mosschief/super_duck/cad/README.md

# CAD Spec

The MuJoCo model is the source of truth for the leg joints (positions, axes, ranges) and the actuators: this folder
holds what the CAD is built from, generated from it, and the real dimensions of every purchased part. The shapes,
masses, neck, cameras and IMU go the other way: `freecad/export_sim.py` exports the FreeCAD assembly into the sim
(`freecad/README.md`). Regenerate after any model change:

```bash
python3 tools/export_cad_spec.py        # hardpoints.json / hardpoints.md / purchased_parts.md
python3 tools/check_cad_clearances.py   # clearance_report.md (exit 1 on a self-contact in a leg pose)
python3 tools/export_design_loads.py    # design_loads.json / design_loads.md (~30 s)
tools/fetch_vendor_cad.sh               # vendor drawings + STEP into cad/vendor/ (git-ignored)
```

| File | What it is |
| :--- | :--- |
| [`hardpoints.md`](hardpoints.md) / `.json` | Every joint anchor, axis and range, body frame, part placement, camera, site and light, in mm at the `home_balanced` pose, plus key dimensions and the leg poses the structure must clear. Build the CAD skeleton from this. |
| [`purchased_parts.json`](purchased_parts.json) → [`.md`](purchased_parts.md) | Real envelopes, hole patterns, masses and load limits of purchased parts, each with its source and a confidence level. Edit the JSON. |
| [`clearance_report.md`](clearance_report.md) | Self-contact of the sim's collision hulls (the CAD parts) over all operating poses and full joint ranges, ground clearance, scrub torque. Exact packing and interference: [`freecad/fit_report.md`](freecad/fit_report.md). |
| [`tires.md`](tires.md) | Cast urethane tires: tread and hub spec, mold, casting steps, grip test and how to put the result into the sim. |
| [`design_loads.md`](design_loads.md) / `.json` | Force and moment through every joint (axial, radial, about and across the axis) for standing, driving, crouching, jumps, ±40 N pushes and a fall. Size brackets and bolts from these. |

Frame everywhere: floor at z = 0, x forward, y left, z up, millimetres.

## Key numbers (gim6010 build, 6.88 kg)

| | |
| :--- | :--- |
| Wheel Ø / tire width / track | 150 / 32 / 224 mm |
| Thigh / shin (axis to axis, in the leg plane) | 118 / 118 mm |
| Hip mount spacing (fixed, no hip yaw) | 168 mm |
| Wheel offset inboard of the knee (wheel under hip roll) | 48 mm; scrub offset 4 mm → 0.11 N·m standing roll torque |
| Height at home pose | 650 mm incl. antennas |
| Hip-pitch axis above the wheel axle | 236 (jump take-off) / 207 (home) / 174 mm (deepest crouch), wheel always directly below |
| Eye camera baseline | 70 mm |
| Ground clearance (lowest non-wheel part, any operating pose) | 28.7 mm (wheel motor housing, deep crouch + hip roll) |

## What the lock-down found and changed

- **GIM4305-10 is 33 mm long, not 26.** Listings quote the housing only. The SteadyWin drawing and STEP add a 6 mm
  driver boss and a 1 mm output step. The model's motor envelopes are now Ø53 × 33.
- **The 6S2P pack is 73 × 89 × 68 mm, not 70 × 84 × 63.** 12 Molicel P45B cells (Ø21.55 × 70.15 max) lying 4 × 3,
  plus strip and wrap. It now sits 2 mm below the trunk shell stand-in and 2 mm under the Pi: the trunk needs about
  5 mm more interior height, or the Pi has to move up.
- **The Teensy carrier and IMU were outside the trunk** (x = -95 / -108 mm, the scaled Open Duck Mini IMU spot). Both
  moved inside, onto the upper rear wall. The IMU orientation and gyro don't depend on where the IMU sits on the
  trunk; its acceleration magnitude (free-fall and bump detection) does a little, and those thresholds were set
  with the IMU at this spot.
- **The anti-spark switch overlapped the full-size battery** by 0.5 mm; moved 3 mm forward.
- **The eye cameras' field of view was the wide lens's** (67° vertical). The standard Camera Module 3 is 41°.

## Open issues for CAD (details in the reports)

1. **Closed (2026-10-16): hip yaw removed.** The hip-yaw GIM4305s were held at 0 by the controller (steering is by
   wheel torque), and their output bearing saw 117 N axial on landings (93% of its limit). The hips are now fixed
   mounts (~60 g each, net -240 g). **Design the mount bracket** (trunk floor to hip-roll motor) for 49 N axial /
   12 N radial / 5.8 N·m bending / 1.0 N·m twist at p99.5, peaks 120 N / 22 N / 5.9 N·m / 2.5 N·m
   (`design_loads.md`, `fixed: hip_roll_assembly`).
2. **Bending moments are large for these bearings**: ~6 N·m across the hip roll (GIM4305), ~9 N·m across the hip
   pitch and knee (GIM6010). Neither limit is published: ask SteadyWin, and support the far side of each joint (a
   bearing on the bracket opposite the motor) where you can. With the hip mount fixed, the hip-roll motor's far side
   can be carried by the mount.
3. **Wheel landing: 260 N contact, 245 N radial through the wheel motor (49% of 500 N)**, plus a torque spike from
   the spinning rotor being stopped at touchdown. The wheel hub and tire need to take it.
4. **Neck pitch reaches 5.4 N·m on landings**, above what the STS3215 can hold, so the neck hits its joint limit.
   Give it a real hard stop that isn't the servo.
5. **Printed parts must clear the head and neck motion**: head roll ±26°, neck pitch −17°…+52°, head pitch and yaw
   at their controller clips. The head hits the trunk outside the neck envelope (`freecad/neck_envelope.md`; the sim sees the same contacts, `clearance_report.md`); the controller now clips head commands to it (`test_robustness.py -k head`: no contacts).
6. **Closed (2026-10-16)**: the hip-yaw bracket no longer turns, so it needs no swept clearance under the trunk.
7. **Space still to reserve**: the e-stop needs ~45 mm behind the rear panel; the speaker depth depends on the part
   (the model assumes 6 mm, with 0.5 mm to the battery). The bucks and the bus servo adapter are now placed in the
   FreeCAD model (`freecad/README.md`).
8. **Measure on arrival**: GIM6010-8 radial protrusion (its STEP is Ø86.6 across, likely the connector), micro servo
   tab holes, the speaker, BMS, anti-spark switch and e-stop.
