mosschief/super_duck/requirements-fea.txt

# tools/fea_printed_parts.py (also needs cad/freecad/printed/ from a FreeCAD build)
-r requirements.txt
gmsh==4.15.2
scikit-fem==12.0.2
pyamg==5.4.1
