mosschief/super_duck/cad/design_loads.md

# Design Loads: `open_duck_wheeled_v2_gim6010.xml`

Generated by `tools/export_design_loads.py` (ideal sensors). Loads each joint transmits from parent to child at its anchor: through the motor's output bearing and into the brackets either side. **F_axial / F_radial**: force along / across the joint axis. **M_axis**: moment about the axis (motor torque). **M_bend**: moment across the axis (tilts the bearing; what the bracket and the motor flange bolts carry).

Robot weight 69.0 N. Values are the **99.5th percentile** over the scenario (peak in brackets). For printed parts apply a safety factor of at least 2 on p99.5 (impacts, fatigue, layer adhesion), and check the peak too. Where the M_axis peak exceeds the actuator's own limit, the extra comes from the joint hitting its limit (the hard stop carries it) or from the motor's reflected rotor inertia being stopped suddenly (a shock load through the gearbox, e.g. a spinning wheel touching down).

## Design envelope (all scenarios except the fall)

| Joint | F_axial (N) | F_radial (N) | M_axis (N·m) | M_bend (N·m) | Output bearing (peak / limit) |
| :--- | ---: | ---: | ---: | ---: | :--- |
| `neck_pitch` | 2.1 (25.1) | 29.0 (40.3) | 2.98 (3.65) | 0.38 (3.02) | STS3215 servo; **M_axis peak > actuator limit**: hard stop or rotor-inertia shock |
| `head_pitch` | 1.9 (23.2) | 26.4 (36.0) | 1.45 (1.86) | 0.29 (1.39) | STS3215 servo |
| `head_yaw` | 18.3 (31.6) | 19.1 (28.9) | 0.27 (0.44) | 0.37 (0.55) | STS3215 servo |
| `head_roll` | 16.2 (24.8) | 15.7 (26.8) | 0.06 (0.45) | 0.64 (1.00) | STS3215 servo |
| `left_antenna` | 0.1 (0.1) | 0.2 (0.3) | 0.00 (0.00) | 0.00 (0.00) | micro servo |
| `right_antenna` | 0.1 (0.2) | 0.2 (0.3) | 0.00 (0.00) | 0.00 (0.00) | micro servo |
| `left_hip_roll` | 14.5 (25.8) | 62.0 (127.2) | 1.72 (2.00) | 4.36 (5.93) | GIM4305-10: axial 21%, radial 25% |
| `left_hip_pitch` | 7.8 (10.8) | 82.9 (160.5) | 4.37 (6.02) | 3.51 (9.01) | limits not published |
| `left_knee` | 8.6 (9.6) | 104.0 (208.9) | 7.90 (8.38) | 3.95 (9.49) | limits not published |
| `left_wheel` | 9.0 (9.7) | 110.5 (231.7) | 1.47 (3.41) | 0.81 (3.00) | GIM4305-10: axial 8%, radial 46% |
| `right_hip_roll` | 14.5 (26.1) | 62.4 (112.2) | 1.67 (2.03) | 4.38 (5.94) | GIM4305-10: axial 21%, radial 22% |
| `right_hip_pitch` | 7.6 (18.4) | 83.2 (147.2) | 4.40 (6.02) | 3.46 (5.88) | limits not published |
| `right_knee` | 8.7 (20.1) | 103.8 (196.3) | 7.88 (8.37) | 4.02 (7.06) | limits not published |
| `right_wheel` | 9.0 (20.2) | 110.6 (218.8) | 1.43 (3.84) | 0.80 (1.74) | GIM4305-10: axial 16%, radial 44%; **M_axis peak > actuator limit**: rotor-inertia shock |
| `fixed: hip_roll_assembly` | 49.8 (107.2) | 13.6 (16.0) | 1.04 (1.88) | 3.73 (6.25) | fixed mount: bracket + bolts to the parent (axis = mount z) |
| `fixed: hip_roll_assembly_2` | 50.8 (90.5) | 13.2 (18.7) | 1.02 (1.65) | 3.78 (6.28) | fixed mount: bracket + bolts to the parent (axis = mount z) |

## Per scenario (p99.5)

### stand

Wheel contact peak (touch sensor): 36.1 N

| Joint | F_axial (N) | F_radial (N) | M_axis (N·m) | M_bend (N·m) |
| :--- | ---: | ---: | ---: | ---: |
| `neck_pitch` | 0.0 | 7.1 | 0.28 | 0.02 |
| `head_pitch` | 0.0 | 6.3 | 0.15 | 0.02 |
| `head_yaw` | 6.1 | 1.0 | 0.00 | 0.12 |
| `head_roll` | 0.9 | 5.2 | 0.02 | 0.10 |
| `left_hip_roll` | 1.5 | 17.6 | 0.31 | 0.21 |
| `left_hip_pitch` | 1.8 | 22.9 | 0.22 | 1.24 |
| `left_knee` | 1.8 | 29.7 | 1.62 | 1.20 |
| `left_wheel` | 1.8 | 32.8 | 0.08 | 0.28 |
| `right_hip_roll` | 1.5 | 17.5 | 0.32 | 0.21 |
| `right_hip_pitch` | 1.8 | 22.8 | 0.22 | 1.23 |
| `right_knee` | 1.8 | 29.5 | 1.61 | 1.19 |
| `right_wheel` | 1.8 | 32.6 | 0.08 | 0.27 |
| `fixed: hip_roll_assembly` | 14.3 | 2.1 | 0.07 | 0.48 |
| `fixed: hip_roll_assembly_2` | 14.2 | 2.1 | 0.07 | 0.47 |

### drive 0.6 m/s weaving

Wheel contact peak (touch sensor): 48.7 N

| Joint | F_axial (N) | F_radial (N) | M_axis (N·m) | M_bend (N·m) |
| :--- | ---: | ---: | ---: | ---: |
| `neck_pitch` | 2.1 | 7.1 | 0.26 | 0.38 |
| `head_pitch` | 1.9 | 6.3 | 0.14 | 0.29 |
| `head_yaw` | 6.1 | 1.9 | 0.27 | 0.12 |
| `head_roll` | 0.5 | 5.3 | 0.04 | 0.22 |
| `left_hip_roll` | 5.3 | 30.2 | 1.72 | 2.15 |
| `left_hip_pitch` | 7.8 | 35.3 | 2.11 | 2.33 |
| `left_knee` | 8.6 | 42.1 | 3.40 | 2.47 |
| `left_wheel` | 9.0 | 45.2 | 0.62 | 0.81 |
| `right_hip_roll` | 5.2 | 30.2 | 1.67 | 2.20 |
| `right_hip_pitch` | 7.6 | 35.3 | 2.17 | 2.38 |
| `right_knee` | 8.7 | 42.0 | 3.46 | 2.48 |
| `right_wheel` | 9.0 | 45.0 | 0.63 | 0.80 |
| `fixed: hip_roll_assembly` | 27.1 | 8.5 | 0.37 | 2.56 |
| `fixed: hip_roll_assembly_2` | 27.0 | 8.3 | 0.38 | 2.42 |

### crouch / stand cycles

Wheel contact peak (touch sensor): 91.4 N

| Joint | F_axial (N) | F_radial (N) | M_axis (N·m) | M_bend (N·m) |
| :--- | ---: | ---: | ---: | ---: |
| `neck_pitch` | 0.0 | 9.1 | 0.45 | 0.03 |
| `head_pitch` | 0.0 | 8.2 | 0.23 | 0.03 |
| `head_yaw` | 7.8 | 3.0 | 0.01 | 0.16 |
| `head_roll` | 2.6 | 6.6 | 0.03 | 0.11 |
| `left_hip_roll` | 3.7 | 20.8 | 0.38 | 0.72 |
| `left_hip_pitch` | 1.7 | 27.3 | 0.73 | 1.47 |
| `left_knee` | 1.7 | 34.9 | 2.66 | 1.44 |
| `left_wheel` | 1.7 | 38.2 | 0.44 | 0.37 |
| `right_hip_roll` | 3.6 | 20.6 | 0.38 | 0.72 |
| `right_hip_pitch` | 1.7 | 27.1 | 0.74 | 1.46 |
| `right_knee` | 1.7 | 34.7 | 2.63 | 1.43 |
| `right_wheel` | 1.7 | 38.0 | 0.44 | 0.37 |
| `fixed: hip_roll_assembly` | 17.0 | 3.7 | 0.25 | 0.70 |
| `fixed: hip_roll_assembly_2` | 16.8 | 3.7 | 0.25 | 0.70 |

### jump (standing)

Wheel contact peak (touch sensor): 241.1 N

| Joint | F_axial (N) | F_radial (N) | M_axis (N·m) | M_bend (N·m) |
| :--- | ---: | ---: | ---: | ---: |
| `neck_pitch` | 0.4 | 29.0 | 2.98 | 0.10 |
| `head_pitch` | 0.4 | 26.4 | 1.45 | 0.09 |
| `head_yaw` | 18.3 | 19.1 | 0.06 | 0.37 |
| `head_roll` | 16.2 | 15.7 | 0.06 | 0.64 |
| `left_hip_roll` | 14.5 | 62.0 | 0.28 | 4.36 |
| `left_hip_pitch` | 4.2 | 82.9 | 4.37 | 3.51 |
| `left_knee` | 4.1 | 104.0 | 7.90 | 3.95 |
| `left_wheel` | 4.0 | 110.5 | 1.47 | 0.76 |
| `right_hip_roll` | 14.5 | 62.4 | 0.30 | 4.38 |
| `right_hip_pitch` | 4.0 | 83.2 | 4.40 | 3.46 |
| `right_knee` | 3.9 | 103.8 | 7.88 | 4.02 |
| `right_wheel` | 3.9 | 110.6 | 1.43 | 0.78 |
| `fixed: hip_roll_assembly` | 49.8 | 13.6 | 1.04 | 3.73 |
| `fixed: hip_roll_assembly_2` | 50.8 | 13.2 | 1.02 | 3.78 |

### jump while driving

Wheel contact peak (touch sensor): 243.8 N

| Joint | F_axial (N) | F_radial (N) | M_axis (N·m) | M_bend (N·m) |
| :--- | ---: | ---: | ---: | ---: |
| `neck_pitch` | 0.2 | 28.2 | 2.68 | 0.09 |
| `head_pitch` | 0.1 | 25.7 | 1.25 | 0.09 |
| `head_yaw` | 17.9 | 17.1 | 0.06 | 0.32 |
| `head_roll` | 13.9 | 15.1 | 0.05 | 0.44 |
| `left_hip_roll` | 13.2 | 47.2 | 0.28 | 4.11 |
| `left_hip_pitch` | 4.0 | 69.6 | 3.99 | 2.76 |
| `left_knee` | 3.9 | 83.8 | 6.67 | 3.10 |
| `left_wheel` | 3.8 | 89.2 | 1.11 | 0.71 |
| `right_hip_roll` | 13.0 | 47.4 | 0.28 | 4.00 |
| `right_hip_pitch` | 3.9 | 70.2 | 4.00 | 2.85 |
| `right_knee` | 3.8 | 83.8 | 6.63 | 3.14 |
| `right_wheel` | 3.7 | 89.2 | 1.12 | 0.72 |
| `fixed: hip_roll_assembly` | 37.8 | 12.5 | 0.99 | 3.53 |
| `fixed: hip_roll_assembly_2` | 38.5 | 12.0 | 0.95 | 3.57 |

### push +40 N

Wheel contact peak (touch sensor): 39.1 N

| Joint | F_axial (N) | F_radial (N) | M_axis (N·m) | M_bend (N·m) |
| :--- | ---: | ---: | ---: | ---: |
| `neck_pitch` | 0.0 | 9.1 | 0.35 | 0.03 |
| `head_pitch` | 0.0 | 8.1 | 0.18 | 0.03 |
| `head_yaw` | 7.1 | 4.2 | 0.01 | 0.20 |
| `head_roll` | 3.5 | 6.0 | 0.02 | 0.13 |
| `left_hip_roll` | 7.3 | 18.1 | 0.31 | 2.09 |
| `left_hip_pitch` | 1.8 | 23.7 | 2.01 | 1.24 |
| `left_knee` | 1.8 | 31.1 | 3.48 | 1.27 |
| `left_wheel` | 1.8 | 34.7 | 1.06 | 0.28 |
| `right_hip_roll` | 7.3 | 17.9 | 0.31 | 2.07 |
| `right_hip_pitch` | 1.8 | 23.5 | 2.00 | 1.23 |
| `right_knee` | 1.8 | 30.9 | 3.47 | 1.26 |
| `right_wheel` | 1.8 | 34.6 | 1.06 | 0.28 |
| `fixed: hip_roll_assembly` | 14.7 | 9.9 | 0.80 | 1.58 |
| `fixed: hip_roll_assembly_2` | 14.5 | 10.0 | 0.80 | 1.56 |

### push -40 N

Wheel contact peak (touch sensor): 39.4 N

| Joint | F_axial (N) | F_radial (N) | M_axis (N·m) | M_bend (N·m) |
| :--- | ---: | ---: | ---: | ---: |
| `neck_pitch` | 0.0 | 8.1 | 0.67 | 0.02 |
| `head_pitch` | 0.0 | 7.3 | 0.28 | 0.02 |
| `head_yaw` | 6.8 | 4.4 | 0.01 | 0.13 |
| `head_roll` | 3.7 | 5.8 | 0.02 | 0.11 |
| `left_hip_roll` | 4.5 | 18.1 | 0.33 | 1.96 |
| `left_hip_pitch` | 1.8 | 23.7 | 1.84 | 1.28 |
| `left_knee` | 1.8 | 30.7 | 2.04 | 1.27 |
| `left_wheel` | 1.8 | 33.8 | 1.07 | 0.28 |
| `right_hip_roll` | 4.6 | 17.9 | 0.33 | 1.95 |
| `right_hip_pitch` | 1.8 | 23.6 | 1.82 | 1.26 |
| `right_knee` | 1.8 | 30.5 | 2.04 | 1.26 |
| `right_wheel` | 1.8 | 33.6 | 1.07 | 0.28 |
| `fixed: hip_roll_assembly` | 14.8 | 7.6 | 0.78 | 1.51 |
| `fixed: hip_roll_assembly_2` | 14.6 | 7.7 | 0.78 | 1.50 |

### fall (push +120 N, indicative)

Wheel contact peak (touch sensor): 134.6 N

| Joint | F_axial (N) | F_radial (N) | M_axis (N·m) | M_bend (N·m) |
| :--- | ---: | ---: | ---: | ---: |
| `neck_pitch` | 3.8 | 181.7 | 2.79 | 0.90 |
| `head_pitch` | 3.9 | 186.6 | 8.07 | 0.90 |
| `head_yaw` | 103.7 | 156.7 | 0.82 | 16.97 |
| `head_roll` | 162.5 | 105.2 | 0.53 | 9.69 |
| `left_hip_roll` | 44.6 | 71.1 | 3.18 | 4.97 |
| `left_hip_pitch` | 13.2 | 65.2 | 4.71 | 3.16 |
| `left_knee` | 9.4 | 49.7 | 5.93 | 2.61 |
| `left_wheel` | 5.2 | 39.5 | 2.42 | 0.62 |
| `right_hip_roll` | 43.7 | 72.5 | 3.27 | 4.94 |
| `right_hip_pitch` | 15.8 | 62.6 | 4.68 | 2.78 |
| `right_knee` | 10.7 | 54.0 | 5.91 | 2.37 |
| `right_wheel` | 6.9 | 39.0 | 2.41 | 0.63 |
| `fixed: hip_roll_assembly` | 81.4 | 56.9 | 3.77 | 4.65 |
| `fixed: hip_roll_assembly_2` | 82.9 | 56.0 | 3.90 | 4.60 |
