mosschief/super_duck/reports/robustness.md

# Robustness Report

Generated by `test_robustness.py` on the `open_duck_wheeled_v2_gim6010.xml` model, ideal sensors: 104 pass, 3 fail, 9 measurements.

| Result | Scenario | Details |
| :--- | :--- | :--- |
| ✅ PASS | slope up 5 deg | parked drift 2.9 cm (5-8 s), after brake 2.5 cm (14-17 s) |
| ✅ PASS | slope up 10 deg | parked drift 3.5 cm (5-8 s), after brake 3.1 cm (14-17 s) |
| ✅ PASS | slope up 15 deg | parked drift 3.8 cm (5-8 s), after brake 3.7 cm (14-17 s) |
| ✅ PASS | slope down 5 deg | parked drift 3.3 cm (5-8 s), after brake 1.1 cm (14-17 s) |
| ✅ PASS | slope down 10 deg | parked drift 4.3 cm (5-8 s), after brake 0.6 cm (14-17 s) |
| ✅ PASS | slope down 15 deg | parked drift 4.1 cm (5-8 s), after brake 0.8 cm (14-17 s) |
| ✅ PASS | slope cross 5 deg | parked drift 0.9 cm (5-8 s), after brake 2.1 cm (14-17 s) |
| ✅ PASS | slope cross 10 deg | parked drift 2.2 cm (5-8 s), after brake 2.7 cm (14-17 s) |
| ✅ PASS | slope cross 15 deg | parked drift 3.0 cm (5-8 s), after brake 3.4 cm (14-17 s) |
| ✅ PASS | ramp up 10 deg | held on the ramp to 1.0 cm, reached x 2.99 m (needs > 2.08) |
| ✅ PASS | ramp down 10 deg | held on the ramp to 3.5 cm, reached x 3.06 m (needs > 2.08) |
| ✅ PASS | ramp up 15 deg | held on the ramp to 0.7 cm, reached x 2.94 m (needs > 2.06) |
| ✅ PASS | ramp down 15 deg | held on the ramp to 3.4 cm, reached x 3.01 m (needs > 2.06) |
| ✅ PASS | threshold 5 mm @0.6 | crossed x 2.65 m, max |pitch| 10 deg |
| ✅ PASS | threshold 10 mm @0.6 | crossed x 2.64 m, max |pitch| 10 deg |
| ✅ PASS | threshold 15 mm @0.6 | crossed x 2.67 m, max |pitch| 10 deg |
| ✅ PASS | threshold 20 mm @0.6 | crossed x 2.69 m, max |pitch| 10 deg |
| ✅ PASS | threshold 25 mm @0.6 | crossed x 2.64 m, max |pitch| 10 deg |
| ✅ PASS | threshold 15 mm @1.0 | crossed x 2.87 m, max |pitch| 21 deg |
| ✅ PASS | threshold 10 mm left wheel @0.6 | crossed x 2.64 m, max |pitch| 10 deg |
| ✅ PASS | threshold 20 mm left wheel @0.6 | crossed x 2.62 m, max |pitch| 10 deg |
| ✅ PASS | curb 10 mm @0.6 | crossed x 2.65 m, max |pitch| 10 deg |
| ✅ PASS | curb 20 mm @0.6 | crossed x 2.62 m, max |pitch| 10 deg |
| ✅ PASS | curb 30 mm @0.6 | crossed x 2.64 m, max |pitch| 10 deg |
| ✅ PASS | uneven floor 5 mm | drove 5.3 m, max |pitch| 10 deg |
| ✅ PASS | uneven floor 10 mm | drove 5.3 m, max |pitch| 10 deg |
| ✅ PASS | uneven floor 20 mm | drove 5.3 m, max |pitch| 10 deg |
| ✅ PASS | turn 45 deg @0.6 m/s | yaw 45 deg (cmd 45) |
| ✅ PASS | turn 90 deg @0.6 m/s | yaw 90 deg (cmd 90) |
| ✅ PASS | turn 45 deg @1.2 m/s | yaw 45 deg (cmd 45) |
| ✅ PASS | turn 90 deg @1.2 m/s | yaw 90 deg (cmd 90) |
| ✅ PASS | turn 45 deg @1.5 m/s | yaw 45 deg (cmd 45) |
| ✅ PASS | turn 90 deg @1.5 m/s | yaw 90 deg (cmd 90) |
| ✅ PASS | turn 45 deg @1.8 m/s | yaw 45 deg (cmd 45) |
| ✅ PASS | turn 90 deg @1.8 m/s | yaw 90 deg (cmd 90) |
| ✅ PASS | turn 45 deg @2.2 m/s | yaw 45 deg (cmd 45) |
| ✅ PASS | turn 90 deg @2.2 m/s | yaw 89 deg (cmd 90) |
| ✅ PASS | turn 45 deg @2.5 m/s | yaw 45 deg (cmd 45) |
| ✅ PASS | turn 90 deg @2.5 m/s | yaw 89 deg (cmd 90) |
| ✅ PASS | push +20 N @0.6 m/s | max |pitch| 5 deg |
| ✅ PASS | push +30 N @0.6 m/s | max |pitch| 5 deg |
| ✅ PASS | push -30 N @0.6 m/s | max |pitch| 11 deg |
| ✅ PASS | push +20 N @1.1 m/s | max |pitch| 5 deg |
| ✅ PASS | push +30 N @1.1 m/s | max |pitch| 5 deg |
| ✅ PASS | push -30 N @1.1 m/s | max |pitch| 11 deg |
| ✅ PASS | push +20 N @1.5 m/s | max |pitch| 5 deg |
| ✅ PASS | push +30 N @1.5 m/s | max |pitch| 5 deg |
| ✅ PASS | push -30 N @1.5 m/s | max |pitch| 11 deg |
| ✅ PASS | push +20 N @1.8 m/s | max |pitch| 5 deg |
| ✅ PASS | push +30 N @1.8 m/s | max |pitch| 6 deg |
| ✅ PASS | push -30 N @1.8 m/s | max |pitch| 11 deg |
| ❌ FAIL | push +20 N @2.5 m/s | (FELL) fell at t=5.5 s |
| ❌ FAIL | push +30 N @2.5 m/s | (FELL) fell at t=5.4 s |
| ✅ PASS | push -30 N @2.5 m/s | max |pitch| 11 deg |
| ✅ PASS | push +80 N | max pitch 15 deg, excursion 0.97 m |
| ✅ PASS | push -80 N | max pitch 24 deg, excursion 0.95 m |
| ✅ PASS | grip mu 0.3 drive_turn_brake | cruise 0.64 m/s (cmd 0.60), yaw 90 deg, |v| after brake 0.019 m/s |
| ❌ FAIL | grip mu 0.3 push +30 N | max pitch 12 deg, excursion 2.87 m |
| ✅ PASS | grip mu 0.3 jump | wheel clearance 19.8 mm, max |pitch| 17 deg |
| ✅ PASS | grip mu 0.4 drive_turn_brake | cruise 0.64 m/s (cmd 0.60), yaw 90 deg, |v| after brake 0.019 m/s |
| ✅ PASS | grip mu 0.4 push +30 N | max pitch 6 deg, excursion 0.31 m |
| ✅ PASS | grip mu 0.4 jump | wheel clearance 19.0 mm, max |pitch| 14 deg |
| ✅ PASS | grip mu 0.5 drive_turn_brake | cruise 0.64 m/s (cmd 0.60), yaw 90 deg, |v| after brake 0.018 m/s |
| ✅ PASS | grip mu 0.5 push +30 N | max pitch 6 deg, excursion 0.31 m |
| ✅ PASS | grip mu 0.5 jump | wheel clearance 18.8 mm, max |pitch| 14 deg |
| ✅ PASS | grip mu 0.6 drive_turn_brake | cruise 0.64 m/s (cmd 0.60), yaw 90 deg, |v| after brake 0.017 m/s |
| ✅ PASS | grip mu 0.6 push +30 N | max pitch 6 deg, excursion 0.32 m |
| ✅ PASS | grip mu 0.6 jump | wheel clearance 17.8 mm, max |pitch| 14 deg |
| ✅ PASS | battery 25.2 V top_speed | cruise 2.53 m/s (cmd 2.50, capped to 2.50), |v| after brake 0.044 m/s |
| ✅ PASS | battery 25.2 V push +40 N | max pitch 7 deg, excursion 0.42 m |
| ✅ PASS | battery 25.2 V jump | wheel clearance 20.6 mm, max |pitch| 14 deg |
| ✅ PASS | battery 22.2 V top_speed | cruise 2.46 m/s (cmd 2.50, capped to 2.43), |v| after brake 0.044 m/s |
| ✅ PASS | battery 22.2 V push +40 N | max pitch 7 deg, excursion 0.42 m |
| ✅ PASS | battery 22.2 V jump | wheel clearance 14.8 mm, max |pitch| 14 deg |
| ✅ PASS | battery 21.1 V top_speed | cruise 2.33 m/s (cmd 2.50, capped to 2.30), |v| after brake 0.045 m/s |
| ✅ PASS | battery 21.1 V push +40 N | max pitch 7 deg, excursion 0.42 m |
| ✅ PASS | battery 21.1 V jump | wheel clearance 12.6 mm, max |pitch| 14 deg |
| ✅ PASS | low battery while driving @0.6 | parked: |v| 0.014 m/s after the keys, wheels off the floor -0.4 mm |
| ✅ PASS | low battery while driving @1.5 | parked: |v| 0.013 m/s after the keys, wheels off the floor -0.4 mm |
| ✅ PASS | low battery while driving @2.5 | parked: |v| 0.011 m/s after the keys, wheels off the floor -0.4 mm |
| 📏 REPORT | e-stop @0.0 m/s | first L_thigh_outer_collision at +0.48 s; peak ground force charge_port_collision 729 N, L_thigh_outer_collision 286 N, R_thigh_outer_collision 284 N, R_thigh_inner_collision 31 N |
| 📏 REPORT | e-stop @0.6 m/s | first L_thigh_outer_collision at +0.58 s; peak ground force charge_port_collision 662 N, L_thigh_outer_collision 233 N, R_thigh_outer_collision 200 N, R_thigh_inner_collision 124 N |
| 📏 REPORT | e-stop @1.8 m/s | first head_shell_collision at +0.53 s; peak ground force head_shell_collision 1091 N, trunk_shell_collision 162 N, R_antenna_collision 87 N, L_hip_roll_yoke_collision 80 N |
| 📏 REPORT | e-stop @2.5 m/s | first head_shell_collision at +0.47 s; peak ground force head_shell_collision 1202 N, trunk_shell_collision 749 N, L_thigh_inner_collision 31 N, R_thigh_inner_collision 31 N |
| ✅ PASS | CAN left wheel frames lost 20 ms @0.6 | max |pitch| 10 deg, x at end 3.21 m |
| ✅ PASS | CAN left wheel frames lost 100 ms @0.6 | max |pitch| 10 deg, x at end 3.21 m |
| ✅ PASS | CAN left bus lost 50 ms @0.6 | max |pitch| 10 deg, x at end 3.21 m |
| ✅ PASS | CAN left bus lost 200 ms standing | max |pitch| 5 deg, x at end 0.03 m |
| ✅ PASS | driver timeout left wheel limp 100 ms @0.6 | max |pitch| 10 deg, x at end 3.21 m |
| ✅ PASS | driver timeout left wheel limp 300 ms standing | max |pitch| 5 deg, x at end 0.03 m |
| ✅ PASS | driver timeout left knee limp 300 ms standing | max |pitch| 8 deg, x at end 0.03 m |
| ✅ PASS | driver timeout left leg limp 300 ms standing | max |pitch| 13 deg, x at end 0.07 m |
| ✅ PASS | feedback stale 20 ms @0.6 | max |pitch| 10 deg, x at end 3.21 m |
| ✅ PASS | feedback stale 50 ms @0.6 | max |pitch| 10 deg, x at end 3.21 m |
| ✅ PASS | IMU mounted +1 deg off | drift over the last 4 s 1.4 cm, max |pitch| 5 deg |
| ✅ PASS | IMU mounted +2 deg off | drift over the last 4 s 1.3 cm, max |pitch| 6 deg |
| ✅ PASS | IMU mounted +3 deg off | drift over the last 4 s 1.4 cm, max |pitch| 7 deg |
| ✅ PASS | IMU mounted -3 deg off | drift over the last 4 s 1.4 cm, max |pitch| 8 deg |
| ✅ PASS | gyro bias drift 0.05 deg/s per s | drift over the last 4 s 0.9 cm, max |pitch| 5 deg |
| ✅ PASS | vibration noise @1.0 m/s | drift over the last 4 s 3.9 cm, max |pitch| 13 deg |
| 📏 REPORT | fall +120 N @0.0 m/s | first trunk_shell_collision; peak ground force head_shell_collision 1293 N, trunk_shell_collision 989 N, projector_pod_collision 108 N |
| 📏 REPORT | fall +120 N @0.6 m/s | first head_shell_collision; peak ground force head_shell_collision 1392 N, trunk_shell_collision 789 N, projector_pod_collision 79 N |
| 📏 REPORT | fall +120 N @1.8 m/s | first head_shell_collision; peak ground force head_shell_collision 1831 N, trunk_shell_collision 419 N, projector_pod_collision 169 N |
| 📏 REPORT | fall +120 N @2.5 m/s | first head_shell_collision; peak ground force head_shell_collision 2039 N, trunk_shell_collision 749 N, projector_pod_collision 315 N |
| ✅ PASS | fall cutoff +60 N @1.8 m/s | slid 0.23 m on the floor, |v| 0.00 m/s before pick-up; stood up: drift 4.5 cm, max |pitch| 5 deg |
| ✅ PASS | fall cutoff +30 N @2.5 m/s | slid 0.25 m on the floor, |v| 0.00 m/s before pick-up; stood up: drift 4.9 cm, max |pitch| 5 deg |
| ✅ PASS | wall @0.6 m/s | backed off, base 0.22 m from it, max |pitch| 10 deg; wall contact: head_shell_collision 84 N |
| ✅ PASS | wall @1.2 m/s | backed off, base 0.23 m from it, max |pitch| 13 deg; wall contact: head_shell_collision 121 N, projector_pod_collision 0 N |
| ✅ PASS | drop 3 cm | peak wheel force 289 N (GIM4305 radial 500 N) |
| ✅ PASS | drop 6 cm | peak wheel force 374 N (GIM4305 radial 500 N) |
| ✅ PASS | drop 10 cm | peak wheel force 448 N (GIM4305 radial 500 N) |
| ✅ PASS | jump landing 8 deg cross slope | landed, peak wheel force 222 N, max |pitch| 14 deg |
| ✅ PASS | jump landing one wheel on 15 mm plate | landed, peak wheel force 260 N, max |pitch| 14 deg |
| 📏 REPORT | plate_edge | peak wheel force 162 N (GIM4305 radial 500 N) |
| ✅ PASS | head_sweep | 54 head poses, head/trunk contacts: none |
| ✅ PASS | endurance 20 min | hip_roll 34% (whole run 34%), hip_pitch 6% (whole run 6%), knee 35% (whole run 35%), wheel 14% (whole run 14%) of rated, worst 5 min; -> cad/fatigue_cycles.md |
