mosschief/super_duck/reports/sensitivity.md

# Sensitivity Sweep

Generated by `tools/sensitivity_sweep.py`: each factor swept alone, the others at nominal (friction 1.25, nominal mass / CoM / motors, 0.4 ms latency, no gyro bias), sensor noise on (seed 0).

## crouch_stand: wander (cm, pass < 8)

| Factor | v1 | v2 | v3 | v4 | v5 |
| :--- | :--- | :--- | :--- | :--- | :--- |
| friction | 0.8: **3.0** | 0.9: **3.0** | 1: **3.1** | 1.1: **3.1** | 1.25: **3.1** |
| trunk_mass_scale | 0.9: **3.1** | 0.95: **3.1** | 1: **3.1** | 1.05: **3.0** | 1.1: **3.1** |
| trunk_com_shift_m | -0.008: **6.7** | -0.004: **4.3** | 0: **3.1** | 0.004: **4.7** | 0.008: **7.7** |
| motor_strength | 0.9: **3.1** | 0.95: **3.1** | 1: **3.1** | 1.05: **3.0** |  |
| latency_ms | 0.25: **3.0** | 0.4: **3.1** | 0.55: **3.1** |  |  |
| gyro_bias_dps | -0.5: **3.8** | -0.25: **3.4** | 0: **3.1** | 0.25: **3.0** | 0.5: **3.2** |

## brake_settle: roll-back / settle offset (cm, pass < 6 / < 3)

| Factor | v1 | v2 | v3 | v4 | v5 |
| :--- | :--- | :--- | :--- | :--- | :--- |
| friction | 0.8: **1.3 / 1.3** | 0.9: **1.3 / 1.3** | 1: **1.3 / 1.3** | 1.1: **1.2 / 1.2** | 1.25: **1.2 / 1.2** |
| trunk_mass_scale | 0.9: **1.5 / 1.5** | 0.95: **1.3 / 1.3** | 1: **1.2 / 1.2** | 1.05: **1.1 / 1.1** | 1.1: **1.9 / 1.8** |
| trunk_com_shift_m | -0.008: **4.7 / 1.6** | -0.004: **2.8 / 1.6** | 0: **1.2 / 1.2** | 0.004: **2.1 / 2.1** | 0.008: **2.2 / 2.2** |
| motor_strength | 0.9: **1.1 / 1.1** | 0.95: **1.2 / 1.2** | 1: **1.2 / 1.2** | 1.05: **1.3 / 1.3** |  |
| latency_ms | 0.25: **1.2 / 1.2** | 0.4: **1.2 / 1.2** | 0.55: **1.2 / 1.2** |  |  |
| gyro_bias_dps | -0.5: **1.9 / 1.9** | -0.25: **1.5 / 1.5** | 0: **1.2 / 1.2** | 0.25: **0.9 / 0.9** | 0.5: **1.5 / 1.4** |
