mosschief/super_duck/cad/fea_report.md

# FEA of the Printed Leg Parts

Generated by `tools/fea_printed_parts.py` (gmsh + scikit-fem, P2 tets) from the load cases in `fea_loads.json` (`tools/export_fea_loads.py`: the sim's worst instants, falls excluded). PETG as a solid, E 1800 MPa; allowable 25 MPa (across layers); target safety factor 2 on the 99th-percentile element stress. Bolt circles are annuli, so hole-edge peaks are approximate.

| Part | Worst case | von Mises p99 / peak (MPa) | Safety factor (p99) | Peak at (mm, part frame) | Interface deflection (mm) | Mesh |
| :--- | :--- | ---: | ---: | :--- | ---: | :--- |
| `L_hip_mount` | threshold 15 mm @1.0 (peak moment, t 3.14 s) | 12.1 / 52.9 | **2.1** | -17.5, 12.6, -18 | 1.86 | 59930 tets, 298149 dofs |
| `L_hip_roll_yoke` | drop 10 cm (peak force, t 0.15 s) | 7.3 / 20.1 | **3.4** | 16.9, 7.7, 17.3 | 1.20 | 67715 tets, 356895 dofs |
| `L_thigh` | drop 10 cm (peak force, t 0.15 s) | 9.3 / 54.7 | **2.7** | -33.7, 15.3, -33.3 | 4.58 | 270458 tets, 1324455 dofs |
| `L_shin` | drop 10 cm (peak force, t 0.15 s) | 11.8 / 34.6 | **2.1** | -36.1, -27.6, -48 | 4.78 | 193351 tets, 900717 dofs |
| `L_wheel_hub` | drop 10 cm (peak force, t 0.15 s) | 4.4 / 14.3 | **5.7** | -65.5, -0.4, 15.9 | 0.60 | 91032 tets, 507204 dofs |

## Top cases per part

### `L_hip_mount`

| Case | F (N, part frame) | M (N·m) | p99 / peak (MPa) | Deflection (mm) |
| :--- | :--- | :--- | ---: | ---: |
| threshold 15 mm @1.0 (peak moment) | 10, 11, 76 | -0.18, 8.42, -3.40 | 12.1 / 52.9 | 1.86 |
| threshold 15 mm @0.6 (peak moment) | -6, -10, 99 | -3.37, 6.23, -2.43 | 8.6 / 37.0 | 1.32 |
| threshold 20 mm left wheel @0.6 (peak force) | -32, -3, 126 | -3.56, 3.59, -3.23 | 7.9 / 28.3 | 1.33 |
| drop 10 cm (peak force) | -1, 27, 207 | -0.09, 5.87, -2.54 | 7.5 / 27.5 | 1.18 |
| drop 10 cm (peak moment) | -1, 27, 207 | -0.13, 5.88, -2.51 | 7.4 / 27.3 | 1.17 |

### `L_hip_roll_yoke`

| Case | F (N, part frame) | M (N·m) | p99 / peak (MPa) | Deflection (mm) |
| :--- | :--- | :--- | ---: | ---: |
| drop 10 cm (peak force) | -16, 27, 270 | -11.24, 5.91, -2.69 | 7.3 / 20.1 | 1.20 |
| drop 10 cm (peak moment) | -16, 27, 269 | -11.26, 5.90, -2.68 | 7.3 / 20.1 | 1.20 |
| drop 6 cm (peak force) | -11, 22, 227 | -9.47, 4.88, -2.18 | 6.1 / 16.8 | 1.00 |
| drop 6 cm (peak moment) | -11, 22, 227 | -9.47, 4.88, -2.18 | 6.1 / 16.8 | 1.00 |
| threshold 15 mm @1.0 (peak moment) | -2, 14, 117 | -5.00, 8.29, -3.27 | 5.9 / 18.3 | 0.98 |

### `L_thigh`

| Case | F (N, part frame) | M (N·m) | p99 / peak (MPa) | Deflection (mm) |
| :--- | :--- | :--- | ---: | ---: |
| drop 10 cm (peak force) | -233, 27, 278 | -10.97, -13.65, -7.99 | 9.3 / 54.7 | 4.58 |
| drop 10 cm (peak moment) | -233, 27, 278 | -10.97, -13.65, -7.99 | 9.3 / 54.7 | 4.58 |
| jump landing one wheel on 15 mm plate (peak force) | -115, 0, 207 | -9.89, -4.58, -6.22 | 8.4 / 48.0 | 4.32 |
| jump landing one wheel on 15 mm plate (peak moment) | -115, 0, 207 | -9.89, -4.58, -6.22 | 8.4 / 48.0 | 4.32 |
| jump landing 8 deg cross slope (peak force) | -92, -8, 165 | -9.23, -5.45, -6.06 | 7.9 / 43.9 | 4.03 |

### `L_shin`

| Case | F (N, part frame) | M (N·m) | p99 / peak (MPa) | Deflection (mm) |
| :--- | :--- | :--- | ---: | ---: |
| drop 10 cm (peak force) | 165, 26, 374 | 1.69, 4.58, -1.05 | 11.8 / 34.6 | 4.78 |
| drop 10 cm (peak moment) | 165, 26, 374 | 1.69, 4.58, -1.05 | 11.8 / 34.6 | 4.78 |
| threshold 15 mm @1.0 (peak moment) | 45, 43, 32 | -7.20, -1.95, 4.32 | 10.1 / 37.6 | 4.41 |
| drop 6 cm (peak force) | 134, 22, 314 | 1.42, 4.03, -0.86 | 9.9 / 29.1 | 4.03 |
| drop 6 cm (peak moment) | 134, 22, 314 | 1.42, 4.03, -0.86 | 9.9 / 29.1 | 4.03 |

### `L_wheel_hub`

| Case | F (N, part frame) | M (N·m) | p99 / peak (MPa) | Deflection (mm) |
| :--- | :--- | :--- | ---: | ---: |
| drop 10 cm (peak force) | 446, 26, -2 | 0.00, 0.00, 0.00 | 4.4 / 14.3 | 0.60 |
| drop 10 cm (peak moment) | 364, 23, 14 | 0.00, 0.00, 0.00 | 3.6 / 11.5 | 0.51 |
| drop 6 cm (peak force) | 363, 22, 81 | 0.00, 0.00, 0.00 | 3.4 / 10.8 | 0.46 |
| jump landing 8 deg cross slope (peak force) | 183, -2, 122 | 0.00, 0.00, 0.00 | 3.0 / 8.8 | 0.50 |
| threshold 15 mm @1.0 (peak force) | -242, 14, -52 | 0.00, 0.00, 0.00 | 2.8 / 8.4 | 0.45 |
