mosschief/super_duck/cad/clearance_report.md

# Clearance Report: `open_duck_wheeled_v2_gim6010.xml`

Generated by `tools/check_cad_clearances.py` on the CAD's collision hulls (`cad/freecad/export_sim.py`). Negative = penetration, i.e. a contact the sim will produce.

- Operating leg poses: **0 contacts**, 0 gaps under 3 mm
- Operating head poses (controller clip ranges): 4 contacts (expected outside the neck envelope, `cad/freecad/neck_envelope.md`)
- Full joint ranges: 0 more contacts
- Ground clearance (lowest part not on a wheel, operating leg poses): **34.4 mm** (`knee_and_ankle_assembly_4__cad_print`, legs delta +0.12, hip_roll +0.30)
- Hip-roll scrub offset +4.0 mm -> standing roll torque 0.14 N·m per hip roll motor
- 430 geom pairs collide; body pairs excluded in the MJCF: `neck_pitch_assembly` / `head_assembly`, `head_pitch_to_yaw` / `head_assembly`

## Operating leg poses

None.

## Operating head poses

| Geom A | Geom B | Worst (mm) | Pose |
| :--- | :--- | ---: | :--- |
| `trunk_shell_collision` | `head_shell_collision` | -37.9 | head neck -0.30 pitch -0.70 yaw +0.00 roll -0.45 antennas -0.79 |
| `trunk_shell_collision` | `R_antenna_collision` | -15.1 | head neck -0.30 pitch -0.70 yaw +0.00 roll +0.45 antennas +0.79 |
| `trunk_shell_collision` | `L_antenna_collision` | -15.1 | head neck -0.30 pitch -0.70 yaw +0.00 roll -0.45 antennas +0.79 |
| `trunk_shell_collision` | `projector_pod_collision` | -4.1 | head neck +0.90 pitch +0.70 yaw -1.50 roll -0.45 antennas -0.79 |
| `sts3215_head_pitch_collision` | `head_yaw_to_roll_collision` | +1.8 | head neck +0.90 pitch +0.70 yaw -1.50 roll -0.45 antennas -0.79 |

## Full joint ranges only

None.
