mosschief/super_duck/cad/freecad/leg_sweep_report.md

# Leg Sweep Report

Generated by `cad/freecad/sweep_legs.py` (left leg; the right is its mirror). Grid: left_hip_roll [-25, 0, 25], left_hip_pitch [-30, 0, 30, 50, 70], left_knee [-90, -60, -30, 0, 30, 60, 90] (deg; home is hip_pitch 28.6, knee -57.3, knees bend backward). Overlap growth beyond the home pose, mm³.

| Moving part | Other part | Worst growth (mm³) | Pose (hip_roll, hip_pitch, knee) |
| :--- | :--- | ---: | :--- |
| `L_tire_vytaflex40` | `trunk_cover` | 915 | 25, 70, 90 |
| `L_tire_vytaflex40` | `trunk_tub` | 700 | 25, 70, 90 |
| `L_wheel_hub` | `trunk_tub` | 670 | 25, 70, 90 |
| `L_wheel_hub` | `trunk_cover` | 415 | 25, 70, 90 |

## Clash-free (hip_pitch x knee, all hip_roll in the grid)

| hip_pitch \ knee | -90 | -60 | -30 | +0 | +30 | +60 | +90 |
| ---: | :---: | :---: | :---: | :---: | :---: | :---: | :---: |
| -30 | ok | ok | ok | ok | ok | ok | ok |
| +0 | ok | ok | ok | ok | ok | ok | ok |
| +30 | ok | ok | ok | ok | ok | ok | ok |
| +50 | ok | ok | ok | ok | ok | ok | ok |
| +70 | ok | ok | ok | ok | ok | ok | x |
