mosschief/super_duck/cad/fatigue_cycles.md

# Joint Load Cycles (fatigue)

Generated by `test_robustness.py -k endurance` from a 20 min mixed duty cycle (weave 0.6 m/s, brake, deepest crouch hold, a jump, 1.2 m/s with turns, every minute), ideal sensors. Rainflow cycle counts of each joint's radial force and bending moment (`export_design_loads.py` terms), as cycles per hour of that duty, at or above each range. Use with the printed parts' S-N data and `design_loads.md` peaks.

| Joint | Radial force range ≥ 5 N / 10 N / 20 N / 40 N / 80 N / 160 N / 320 N | Bending range ≥ 0.25 N·m / 0.5 N·m / 1 N·m / 2 N·m / 4 N·m / 8 N·m / 16 N·m |
| :--- | :--- | :--- |
| `neck_pitch` | 240 / 120 / 120 / 21 / 0 / 0 / 0 | 336 / 24 / 3 / 3 / 0 / 0 / 0 |
| `head_pitch` | 240 / 120 / 120 / 0 / 0 / 0 / 0 | 318 / 3 / 3 / 0 / 0 / 0 / 0 |
| `head_yaw` | 240 / 147 / 60 / 0 / 0 / 0 / 0 | 120 / 21 / 0 / 0 / 0 / 0 / 0 |
| `head_roll` | 120 / 120 / 33 / 0 / 0 / 0 / 0 | 141 / 140 / 0 / 0 / 0 / 0 / 0 |
| `left_hip_roll` | 1080 / 273 / 260 / 120 / 84 / 0 / 0 | 1224 / 837 / 477 / 231 / 60 / 0 / 0 |
| `left_hip_pitch` | 1164 / 471 / 260 / 141 / 117 / 0 / 0 | 3417 / 1058 / 633 / 240 / 114 / 0 / 0 |
| `left_knee` | 1436 / 609 / 260 / 122 / 120 / 24 / 0 | 2076 / 994 / 244 / 240 / 114 / 0 / 0 |
| `left_wheel` | 1498 / 600 / 238 / 122 / 120 / 42 / 0 | 618 / 426 / 117 / 3 / 0 / 0 / 0 |
| `right_hip_roll` | 1024 / 350 / 288 / 120 / 87 / 0 / 0 | 1197 / 834 / 471 / 252 / 60 / 0 / 0 |
| `right_hip_pitch` | 1102 / 470 / 318 / 138 / 117 / 0 / 0 | 3471 / 1022 / 754 / 300 / 112 / 0 / 0 |
| `right_knee` | 1312 / 536 / 318 / 120 / 120 / 21 / 0 | 2010 / 946 / 302 / 300 / 117 / 0 / 0 |
| `right_wheel` | 1414 / 544 / 300 / 120 / 120 / 21 / 0 | 526 / 420 / 96 / 3 / 0 / 0 / 0 |
