mosschief/super_duck/cad/hardpoints.md

# CAD Hardpoints: `open_duck_wheeled_v2_gim6010.xml`

Generated by `tools/export_cad_spec.py` from the MJCF. Do not edit by hand: change the model and re-run.

Units: mm, deg, g, N*m. Frame: world at keyframe home_balanced; floor z = 0; x forward, y left, z up. Total mass 7.032 kg.

## Key dimensions

| Dimension | Value (mm) |
| :--- | ---: |
| wheel_radius | 75.0 |
| tire_width | 32.0 |
| wheel_track (wheel centre to centre) | 224.0 |
| hip mounts, lateral spacing | 168.0 |
| thigh length (hip_pitch axis to knee axis) | 118.0 |
| shin length (knee axis to wheel axle, in the leg plane) | 118.0 |
| wheel axle lateral offset from the knee axis origin (inboard routing) | -48.0 |
| hip_roll axis to wheel centre, lateral (scrub offset) | 4.0 |
| hip_roll axis height | 282.1 |
| base origin height (home) | 370.1 |
| overall height (home) | 662.6 |
| eye camera baseline | 80.0 |
| IMU site (base frame) | -58, 8, 41.1 |

### Leg poses the structure must clear

| Pose | hip_pitch (deg) | knee (deg) | hip_pitch axis above axle | axle fore/aft of hip_pitch axis |
| :--- | ---: | ---: | ---: | ---: |
| jump take-off (delta -0.46) | 2.3 | -4.6 | 235.8 | 0.0 |
| tallest drive (delta -0.25) | 14.3 | -28.6 | 228.7 | 0.0 |
| home (delta 0) | 28.6 | -57.3 | 207.1 | -0.0 |
| deepest crouch / jump wind-up (delta +0.24) | 42.4 | -84.8 | 174.3 | -0.0 |

## Joints

| Joint | Child body | Parent | Anchor (child frame, mm) | Axis (child frame) | Anchor (world, mm) | Range (deg) | Actuator / limit |
| :--- | :--- | :--- | :--- | :--- | :--- | :--- | :--- |
| `neck_pitch` | `neck_pitch_assembly` | `trunk_assembly` | 0, 0, 0 | 0, 1, 0 | 36, 0, 430.1 | -20, 65 | neck_pitch ±3.23 N·m |
| `head_pitch` | `head_pitch_to_yaw` | `neck_pitch_assembly` | 0, 0, 0 | 0, 1, 0 | 45.9, 0, 495.4 | -45, 45 | head_pitch ±3.23 N·m |
| `head_yaw` | `neck_yaw_assembly` | `head_pitch_to_yaw` | 0, 0, 0 | 0, 0, 1 | 45.9, 0, 552.4 | -94.5, 94.5 | head_yaw ±3.23 N·m |
| `head_roll` | `head_assembly` | `neck_yaw_assembly` | 0, 0, 0 | 1, 0, 0 | 86.8, 0, 533.2 | -30, 30 | head_roll ±3.23 N·m |
| `left_antenna` | `left_antenna` | `head_assembly` | 0, 0, 0 | -0.2631, 0.9354, 0.2362 | -29.6, 60.7, 533.9 | -45, 45 | left_antenna ±0.18 N·m |
| `right_antenna` | `right_antenna` | `head_assembly` | 0, 0, 0 | 0.2631, 0.9354, -0.2362 | -29.6, -60.7, 533.9 | -45, 45 | right_antenna ±0.18 N·m |
| `left_hip_roll` | `left_roll_to_pitch_assembly` | `hip_roll_assembly` | 0, 0, 0 | 1, 0, 0 | 0, 108, 282.1 | -25, 25 | left_hip_roll ±3.47 N·m |
| `left_hip_pitch` | `knee_and_ankle_assembly` | `left_roll_to_pitch_assembly` | 0, 0, 0 | 0, 1, 0 | 0, 160, 282.1 | -30, 70 | left_hip_pitch ±11.0 N·m |
| `left_knee` | `knee_and_ankle_assembly_2` | `knee_and_ankle_assembly` | 0, 0, 0 | 0, 1, 0 | -56.6, 160, 178.5 | -90, 90 | left_knee ±11.0 N·m |
| `left_wheel` | `foot_assembly` | `knee_and_ankle_assembly_2` | 0, 0, 0 | 0, 1, 0 | -0, 112, 75 | continuous | left_wheel_motor ±3.47 N·m |
| `right_hip_roll` | `right_roll_to_pitch_assembly` | `hip_roll_assembly_2` | 0, 0, 0 | 1, 0, 0 | 0, -108, 282.1 | -25, 25 | right_hip_roll ±3.47 N·m |
| `right_hip_pitch` | `knee_and_ankle_assembly_3` | `right_roll_to_pitch_assembly` | 0, 0, 0 | 0, 1, 0 | 0, -160, 282.1 | -30, 70 | right_hip_pitch ±11.0 N·m |
| `right_knee` | `knee_and_ankle_assembly_4` | `knee_and_ankle_assembly_3` | 0, 0, 0 | 0, 1, 0 | -56.6, -160, 178.5 | -90, 90 | right_knee ±11.0 N·m |
| `right_wheel` | `foot_assembly_2` | `knee_and_ankle_assembly_4` | 0, 0, 0 | 0, 1, 0 | -0, -112, 75 | continuous | right_wheel_motor ±3.47 N·m |

## Body frames

| Body | Parent | Origin in parent (mm) | Quat in parent (wxyz) | Origin (world, mm) | Mass (g) |
| :--- | :--- | :--- | :--- | :--- | ---: |
| `base` | `world` | 0, 0, 339.5 | 1, 0, 0, 0 | 0, 0, 370.1 | 0.0 |
| `trunk_assembly` | `base` | 0, 0, 0 | 1, 0, 0, 0 | 0, 0, 370.1 | 2143.0 |
| `neck_pitch_assembly` | `trunk_assembly` | 36, 0, 60 | 1, 0, 0, 0 | 36, 0, 430.1 | 76.3 |
| `head_pitch_to_yaw` | `neck_pitch_assembly` | 0, 0, 66 | 1, 0, 0, 0 | 45.9, 0, 495.4 | 20.2 |
| `neck_yaw_assembly` | `head_pitch_to_yaw` | 0, 0, 57 | 1, 0, 0, 0 | 45.9, 0, 552.4 | 89.3 |
| `head_assembly` | `neck_yaw_assembly` | 41, 0, -19.1 | 1, 0, 0, 0 | 86.8, 0, 533.2 | 503.5 |
| `left_antenna` | `head_assembly` | -116.4, 60.7, 0.7 | 1, 0, 0, 0 | -29.6, 60.7, 533.9 | 4.8 |
| `right_antenna` | `head_assembly` | -116.4, -60.7, 0.7 | 1, 0, 0, 0 | -29.6, -60.7, 533.9 | 4.8 |
| `hip_roll_assembly` | `trunk_assembly` | 0, 84, -44 | 1, 0, 0, 0 | 0, 84, 326.1 | 317.9 |
| `left_roll_to_pitch_assembly` | `hip_roll_assembly` | 0, 24, -44 | 1, 0, 0, 0 | 0, 108, 282.1 | 532.8 |
| `knee_and_ankle_assembly` | `left_roll_to_pitch_assembly` | 0, 52, 0 | 1, 0, 0, 0 | 0, 160, 282.1 | 682.8 |
| `knee_and_ankle_assembly_2` | `knee_and_ankle_assembly` | 0, 0, -118 | 1, 0, 0, 0 | -56.6, 160, 178.5 | 310.2 |
| `foot_assembly` | `knee_and_ankle_assembly_2` | 0, -48, -118 | 1, 0, 0, 0 | -0, 112, 75 | 251.1 |
| `hip_roll_assembly_2` | `trunk_assembly` | 0, -84, -44 | 1, 0, 0, 0 | 0, -84, 326.1 | 317.9 |
| `right_roll_to_pitch_assembly` | `hip_roll_assembly_2` | 0, -24, -44 | 1, 0, 0, 0 | 0, -108, 282.1 | 532.8 |
| `knee_and_ankle_assembly_3` | `right_roll_to_pitch_assembly` | 0, -52, 0 | 1, 0, 0, 0 | 0, -160, 282.1 | 682.8 |
| `knee_and_ankle_assembly_4` | `knee_and_ankle_assembly_3` | 0, 0, -118 | 1, 0, 0, 0 | -56.6, -160, 178.5 | 310.2 |
| `foot_assembly_2` | `knee_and_ankle_assembly_4` | 0, 48, -118 | 1, 0, 0, 0 | -0, -112, 75 | 251.1 |

## Cameras, sites and lights

| Name | Kind | Body | Position (local, mm) | Position (world, mm) | Notes |
| :--- | :--- | :--- | :--- | :--- | :--- |
| `trunk_nav_cam` | camera | `trunk_assembly` | 86.8, 0, -13.7 | 86.8, 0, 356.4 | fovy 75.0° |
| `left_eye_cam` | camera | `head_assembly` | 55.1, 40, 10.3 | 141.9, 40, 543.5 | fovy 41.0° |
| `right_eye_cam` | camera | `head_assembly` | 55.1, -40, 10.3 | 141.9, -40, 543.5 | fovy 41.0° |
| `imu` | site | `base` | -58, 8, 41.1 | -58, 8, 411.2 | |
| `left_foot` | site | `foot_assembly` | 0, 0, 0 | -0, 112, 75 | |
| `left_wheel_touch` | site | `foot_assembly` | 0, 0, 0 | -0, 112, 75 | |
| `right_foot` | site | `foot_assembly_2` | 0, 0, 0 | -0, -112, 75 | |
| `right_wheel_touch` | site | `foot_assembly_2` | 0, 0, 0 | -0, -112, 75 | |
| `projector` | light | `head_assembly` | 45.5, 97.8, 19.3 | | dir 1, 0, 0, cutoff 20.0° |

## Part placement (primitive geoms)

The mesh geoms (every part's shape and the collision hulls) are exported from the FreeCAD assembly by `cad/freecad/export_sim.py`; they are listed in `hardpoints.json` only. Dims: box = x, y, z; cylinder / capsule = Ø, length (along the geom's local z); sphere = Ø. Position and orientation are in the owning body's frame.

| Geom | Body | Type | Dims (mm) | Position (local, mm) | Quat (local, wxyz) | Role |
| :--- | :--- | :--- | :--- | :--- | :--- | :--- |
| `left_foot_bottom_tpu` | `foot_assembly` | cylinder | 150, 32 | 0, 0, 0 | 0.70711, 0.70711, 0, 0 | collision |
| `right_foot_bottom_tpu` | `foot_assembly_2` | cylinder | 150, 32 | 0, 0, 0 | 0.70711, 0.70711, 0, 0 | collision |
