mosschief/super_duck/cad/freecad/fit_report.md

# FreeCAD Fit Report

Generated by `cad/freecad/build_super_duck.py` (home_balanced pose). Do not edit by hand.

## Interferences at home: 0

None.

### Between Open Duck Mini parts at their ODM positions: 3

Press fits / pockets in the ODM design, or STL-to-solid conversion artefacts; not layout errors.

| Part A | Part B | Overlap (mm³) |
| :--- | :--- | ---: |
| `head_bot_sheet` | `head_shell` | 412 |
| `head_roll_mount` | `sts3215_head_roll` | 11 |
| `head_yaw_to_roll` | `sts3215_head_yaw` | 10 |

## Printed parts

Exported to `printed/<name>.step` in the part's body frame. Mass at 100% infill, PETG 1.27 g/cm³.

| Part | Body | Volume (cm³) | Mass @100% (g) |
| :--- | :--- | ---: | ---: |
| `trunk_tub` | `trunk_assembly` | 429.8 | 546 |
| `trunk_cover` | `trunk_assembly` | 149.8 | 190 |
| `trunk_lid` | `trunk_assembly` | 52.7 | 67 |
| `pi_deck_frame` | `trunk_assembly` | 7.8 | 10 |
| `electronics_shelf` | `trunk_assembly` | 11.4 | 14 |
| `L_hip_mount` | `hip_roll_assembly` | 140.0 | 178 |
| `L_hip_roll_end_cap` | `hip_roll_assembly` | 5.0 | 6 |
| `L_hip_roll_yoke` | `left_roll_to_pitch_assembly` | 99.8 | 127 |
| `L_thigh_outer` | `knee_and_ankle_assembly` | 146.9 | 187 |
| `L_thigh_inner` | `knee_and_ankle_assembly` | 82.0 | 104 |
| `L_shin` | `knee_and_ankle_assembly_2` | 141.5 | 180 |
| `L_wheel_end_cap` | `knee_and_ankle_assembly_2` | 3.1 | 4 |
| `L_wheel_hub` | `foot_assembly` | 122.1 | 155 |
| `R_hip_mount` | `hip_roll_assembly_2` | 140.0 | 178 |
| `R_hip_roll_end_cap` | `hip_roll_assembly_2` | 5.0 | 6 |
| `R_hip_roll_yoke` | `right_roll_to_pitch_assembly` | 99.8 | 127 |
| `R_thigh_outer` | `knee_and_ankle_assembly_3` | 146.9 | 187 |
| `R_thigh_inner` | `knee_and_ankle_assembly_3` | 82.0 | 104 |
| `R_shin` | `knee_and_ankle_assembly_4` | 141.5 | 180 |
| `R_wheel_end_cap` | `knee_and_ankle_assembly_4` | 3.1 | 4 |
| `R_wheel_hub` | `foot_assembly_2` | 122.1 | 155 |
| `neck_servo_pocket` | `trunk_assembly` | 22.1 | 28 |
| `neck_left_sheet` | `neck_pitch_assembly` | 8.1 | 10 |
| `neck_right_sheet` | `neck_pitch_assembly` | 6.2 | 8 |
| `head_pitch_to_yaw` | `head_pitch_to_yaw` | 13.5 | 17 |
| `head_yaw_to_roll` | `neck_yaw_assembly` | 29.4 | 37 |
| `head_bot_sheet` | `head_assembly` | 65.9 | 84 |
| `head_roll_mount` | `head_assembly` | 13.4 | 17 |
| `L_antenna` | `left_antenna` | 0.4 | 1 |
| `left_antenna_holder` | `left_antenna` | 2.9 | 4 |
| `right_antenna_holder` | `right_antenna` | 2.9 | 4 |
| `R_antenna` | `right_antenna` | 0.4 | 1 |
| `head_shell` | `head_assembly` | 228.3 | 290 |
| `projector_pod` | `head_assembly` | 12.5 | 16 |
| `projector_reflector` | `head_assembly` | 2.2 | 3 |
| `L_eye_diffuser` | `head_assembly` | 1.6 | 2 |
| `R_eye_diffuser` | `head_assembly` | 1.6 | 2 |
