mosschief/super_duck/cad/freecad/neck_sweep_report.md

# Neck Sweep Report

Generated by `cad/freecad/sweep_neck.py`. Grid: neck_pitch [-20, 0, 30, 65], head_pitch [-45, 0, 45], head_yaw [-94.5, 0, 94.5], head_roll [-30, 0, 30] (deg). Overlap growth beyond the home pose, mm³.

| Moving part | Other part | Worst growth (mm³) | Pose (neck_pitch, head_pitch, head_yaw, head_roll) |
| :--- | :--- | ---: | :--- |
| `head_shell` | `trunk_lid` | 3780 | -20, -45, 0, 0 |
| `head_shell` | `trunk_tub` | 2243 | 65, 45, 94.5, 30 |
| `head_bot_sheet` | `breast_cover` | 2182 | 65, 45, 0, 0 |
| `projector_pod` | `trunk_tub` | 1832 | -20, -45, 94.5, -30 |
| `head_bot_sheet` | `trunk_tub` | 1803 | 65, 45, 0, -30 |
| `head_shell` | `breast_cover` | 1629 | 65, 45, -94.5, -30 |
| `head_bot_sheet` | `trunk_lid` | 1462 | -20, -45, 0, -30 |
| `head_shell` | `estop_22mm` | 1150 | -20, -45, 0, -30 |
| `head_bot_sheet` | `bus_servo_adapter` | 796 | 65, 45, -94.5, -30 |
| `head_shell` | `teensy_40` | 789 | -20, -45, 0, 30 |
| `head_shell` | `bus_servo_adapter` | 667 | 65, 45, 94.5, 30 |
| `head_shell` | `usb_chest_cam` | 592 | 65, 45, 0, 0 |
| `L_antenna_sg90` | `trunk_lid` | 568 | -20, -45, 0, -30 |
| `R_antenna_sg90` | `trunk_lid` | 568 | -20, -45, 0, 30 |
| `projector_pod` | `trunk_lid` | 555 | 0, -45, 94.5, -30 |
| `left_antenna_holder` | `trunk_lid` | 482 | -20, -45, 0, -30 |
| `right_antenna_holder` | `trunk_lid` | 482 | -20, -45, 0, 30 |
| `head_bot_sheet` | `usb_chest_cam` | 435 | 65, 45, 0, 0 |
| `head_bot_sheet` | `can_transceivers` | 413 | -20, -45, 0, 0 |
| `head_shell` | `can_transceivers` | 408 | -20, -45, 0, 30 |
| `left_antenna_holder` | `estop_22mm` | 264 | -20, -45, 0, -30 |
| `head_bot_sheet` | `teensy_40` | 261 | -20, -45, 0, -30 |
| `right_antenna_holder` | `trunk_tub` | 171 | -20, -45, 0, 0 |
| `left_antenna_holder` | `trunk_tub` | 171 | -20, -45, 0, 0 |
| `head_bot_sheet` | `estop_22mm` | 169 | -20, -45, 94.5, 0 |
| `head_shell` | `max98357a_i2s_amp` | 153 | -20, -45, 94.5, -30 |
| `R_eye_cam_module3` | `breast_cover` | 147 | 65, 45, 0, 30 |
| `L_eye_cam_module3` | `breast_cover` | 147 | 65, 45, 0, -30 |
| `R_eye_diffuser` | `breast_cover` | 136 | 65, 45, 0, 30 |
| `L_eye_diffuser` | `breast_cover` | 136 | 65, 45, 0, -30 |
| `head_shell` | `teensy_carrier_pcb` | 123 | -20, -45, 0, 30 |
| `L_eye_led_ring` | `breast_cover` | 94 | 65, 45, 0, -30 |
| `R_eye_led_ring` | `breast_cover` | 94 | 65, 45, 0, 30 |
| `L_eye_diffuser` | `trunk_tub` | 91 | 65, 45, 0, -30 |
| `R_eye_diffuser` | `trunk_tub` | 91 | 65, 45, 0, 30 |
| `sts3215_head_roll` | `breast_cover` | 83 | 65, 45, 0, 0 |
| `L_eye_led_ring` | `trunk_tub` | 59 | 65, 45, 0, -30 |
| `R_eye_led_ring` | `trunk_tub` | 59 | 65, 45, 0, 30 |
| `projector_pod` | `estop_22mm` | 31 | -20, -45, 94.5, -30 |
| `R_antenna` | `trunk_lid` | 25 | -20, -45, 0, 30 |
| `L_antenna` | `trunk_lid` | 25 | -20, -45, 0, -30 |
| `projector_mosfet` | `trunk_tub` | 18 | 65, 45, 0, -30 |
| `neck_left_sheet` | `trunk_lid` | 8 | 65, -45, -94.5, -30 |
| `head_shell` | `electronics_shelf` | 7 | -20, -45, 0, 30 |
| `neck_right_sheet` | `trunk_lid` | 6 | 65, -45, -94.5, -30 |
