mosschief/super_duck/cad/purchased_parts.md

# Purchased Parts: Real Dimensions

Generated by `tools/export_cad_spec.py` from `purchased_parts.json` (edit the JSON, not this file). Units mm / g. Confidence: **drawing** = official mechanical drawing, **step** = measured from the vendor STEP, **datasheet** = manufacturer spec, **listing** = retailer listing, **estimate** = not yet sourced. Download vendor drawings/STEP with `tools/fetch_vendor_cad.sh`.

## SteadyWin GIM6010-8 (with GDS68 driver)

- **Qty** 4 · **Mass** 388 g · **Confidence** drawing + step · **Model** `left/right_hip_pitch`, `left/right_knee`
- **Envelope**: Overall 44.0 axial x Ø80 (STEP bbox; something reaches R43.3 = Ø86.6 radially, likely the connector: check on arrival). Stack along the axis: driver cover Ø57 x 11 | housing Ø80 x 26 | output steps 7 (Ø47 +0/-0.03 spigot 3.5 long, then the hub).
- **Mounting**: Housing, both faces: 8x M3 depth 5 on Ø74 ±0.10 PCD
- **Mounting**: Output hub: 6x M3 depth 5 on Ø25 ±0.10 PCD, 3x Ø4 ±0.05 dowel holes on Ø20.4 PCD
- **Mounting**: Locating spigot: Ø47 +0/-0.03 x 3.5 (output side)
- **Mounting**: Driver PCB 47 x 47 x 8.65, 4x M2; connectors: 2+2 power/CAN terminal, USB-C
- **Mounting**: Optional output-shaft variant: Ø14 +0/-0.03 x 15 shaft with a Ø5 x 3 cross hole / key slot; housing holes then 8x M3 depth 4.5 (back) and depth 4 (front) (6010-8 Output Shaft drawing)
- **Loads**: Rated 5 N*m, stall 11 N*m, 420 rpm max. Bearing load limits not published in the manual: ask SteadyWin.
- **Verify**: Radial protrusion (Ø86.6 bbox), connector exit direction, which face your driver variant puts the connector on.
- **Sources**: [1](https://cdn.shopify.com/s/files/1/0673/6848/5000/files/6010-8_Installation_Diagram.pdf), [2](https://cdn.shopify.com/s/files/1/0673/6848/5000/files/SteadyWin_GIM6010_8.step), [3](https://cdn.shopify.com/s/files/1/0673/6848/5000/files/6010-8_Output_Shaft_Mounting_Dimensions_Drawing.pdf), [4](https://sdalal1.github.io/assets/pdf/SteadyWin_GIM6010-8_Manual_rev1.pdf)

## SteadyWin GIM4305-10SHS (with front cover, integrated driver)

- **Qty** 4 · **Mass** 150 g · **Confidence** drawing + step · **Model** `left/right_hip_roll`, `left/right_wheel`
- **Envelope**: Overall 33.0 axial x Ø53 (drawing + STEP). Listings say 'Ø53 x 26', which is the housing only. Stack: output step Ø37 x 1 | housing Ø53 x 26 | rear driver boss Ø40 x 6. The no-front-cover variant is 31 (2 + 23 + 6) but must not be run until its bearing is retained by your part.
- **Mounting**: Output (rotor): 3x M3 effective depth 4 on Ø27 PCD
- **Mounting**: Housing, output face: 3x M2.5 effective depth 5 on Ø47.5 PCD
- **Mounting**: Housing, rear face: 6x M2.5 depth 3 on Ø47.5 PCD; screws longer than 3 mm engagement damage the motor
- **Loads**: Max axial 125 N, max radial 500 N (listing). Rated 1.0 N*m, stall 3.47 N*m.
- **Verify**: Axial/radial load limits with SteadyWin (the wheel motors carry the robot's weight and landing loads radially, and side loads axially).
- **Sources**: [1](https://cdn.shopify.com/s/files/1/0673/6848/5000/files/GIM4305-10SHS_Installation_Diagram.pdf), [2](https://cdn.shopify.com/s/files/1/0673/6848/5000/files/SteadyWin_GIM4305_10.step), [3](https://aifitlab.com/products/steadywin-gim4305-planetary-reducer-servo-motor)

## Feetech STS3215 serial bus servo, 7.4 V

- **Qty** 4 · **Mass** 55 g · **Confidence** listing · **Model** `neck_pitch`, `head_pitch`, `head_yaw`, `head_roll`
- **Envelope**: 45.2 x 24.7 x 35 body; 25T output spline
- **Mounting**: Use the STS3215 model in the Open Duck Mini Onshape CAD (same servo, same brackets)
- **Verify**: Hole pattern from the Open Duck Mini CAD.
- **Sources**: [1](https://www.robotshop.com/products/magnetic-encoding-servo-sts3215-74v-19kgcm), [2](https://github.com/apirrone/Open_Duck_Mini)

## Micro servo, MG90S (metal gear) or SG90

- **Qty** 2 · **Mass** 13.4 g · **Confidence** listing · **Model** `left/right_antenna`
- **Envelope**: MG90S 22.8 x 12.2 x 28.5 body, ~32.5 across the mounting tabs; SG90 22.2 x 11.8 x 31, 9 g
- **Mounting**: 2x tab holes, spacing ~27.5 (measure)
- **Verify**: Tab hole spacing and horn height on the part you buy. The model assumes 9 g (SG90); MG90S adds 4.4 g per side in the head.
- **Sources**: [1](https://protosupplies.com/product/servo-motor-micro-mg90s/)

## 6S2P 21700 pack (12x Molicel P45B)

- **Qty** 1 · **Mass** 870 g · **Confidence** datasheet (cell); pack envelope is derived · **Model** `battery_pack_6s`
- **Envelope**: Cell max Ø21.55 x 70.15, <= 70 g (Molicel datasheet). 4 x 3 cells lying along x: bare 70.2 x 86.2 x 64.7; +1.5 per side for nickel strip, fish paper and wrap = 73 x 89 x 68
- **Mounting**: Strap or clamp in a tray; no holes. Balance lead + main leads to the BMS
- **Verify**: Final pack envelope from the builder / your layout.
- **Sources**: [1](https://18650batterystore.com/products/molicel-p45b)

## Raspberry Pi 5

- **Qty** 1 · **Mass** 46 g · **Confidence** step + datasheet · **Model** `raspberry_pi_5`
- **Envelope**: PCB 85 x 56; 90.0 x 57.7 x 19.8 including connector overhang (STEP)
- **Mounting**: 4x Ø2.7 (M2.5) holes on a 58 x 49 rectangle, 3.5 from the PCB edges (HAT+ standard)
- **Verify**: Leave room for USB/Ethernet plugs and the cooler's fan inlet.
- **Sources**: [1](https://datasheets.raspberrypi.com/rpi5/raspberry-pi-5-mechanical-drawing.pdf), [2](https://www.step.parts/step/raspberry_pi_5.step)

## Raspberry Pi AI HAT+ 26 TOPS (with Active Cooler underneath)

- **Qty** 1 · **Mass** 41 g · **Confidence** datasheet · **Model** `ai_hat_plus_26tops`
- **Envelope**: 65.1 x 56.7 x 5.5; on a 16 mm stacking header above the Pi (clears the Active Cooler)
- **Mounting**: Same 58 x 49 hole pattern as the Pi, supplied spacers
- **Sources**: [1](https://core-electronics.com.au/raspberry-pi-ai-hat-26-tops-for-raspberry-pi-5.html)

## PJRC Teensy 4.0 (+ 2x CAN transceiver breakouts on a carrier)

- **Qty** 1 · **Mass** 8 g · **Confidence** datasheet · **Model** `teensy_40_dual_can`
- **Envelope**: Teensy 35.6 x 17.8 (1.4 x 0.7 in); the model box (42 x 22 x 7) is the carrier
- **Mounting**: No mounting holes: socket it on a carrier PCB or perfboard with M2.5 holes
- **Verify**: Carrier size once the transceivers, level shifter, fan MOSFET and connectors are laid out. Cut the VUSB-VIN pad: it is fed from the Pi buck and also gets 5 V over USB from the Pi.
- **Sources**: [1](https://www.pjrc.com/store/teensy40.html)

## Raspberry Pi Camera Module 3 (standard)

- **Qty** 2 · **Mass** 4 g · **Confidence** drawing · **Model** `left_eye_cam`, `right_eye_cam`
- **Envelope**: PCB 25 x 23.862 x 1.12; 11.3 deep including the lens (wide: 12.0). Lens holder 10.8 x 10.8, lens Ø5.75 (wide Ø6.95). FOV 66 x 41 deg (wide 102 x 67)
- **Mounting**: 4x Ø2.2 (M2) holes, 21 apart horizontally (2 from each side edge); vertical spacing and the lens-axis height from the drawing in the product brief
- **Verify**: Set the 70 mm baseline between lens axes, not PCB centres.
- **Sources**: [1](https://cdn.sparkfun.com/assets/c/b/3/a/1/Camera_Module_3_Product_Brief.pdf)

## WS2812B 12-LED ring (Adafruit NeoPixel Ring 12 class)

- **Qty** 2 · **Mass** 2.5 g · **Confidence** listing · **Model** `left/right_eye_led_ring`
- **Envelope**: Ø37 OD, Ø23 ID, ~3.5 thick with LEDs
- **Mounting**: No holes: clamp or glue behind a diffuser
- **Verify**: Ø23 ID clears the Camera Module 3 lens holder (10.8 square = 15.3 across corners).
- **Sources**: [1](https://www.adafruit.com/product/1643)

## Adafruit 3968 speaker, 40 mm, 4 ohm, 3 W (5 W max)

- **Qty** 1 · **Mass** 27.3 g · **Confidence** listing · **Model** `speaker_40mm_3w`
- **Envelope**: Ø40 x 20 overall (Adafruit spec; Digi-Key: seated height max 20.00). Modelled as a 2 mm rim, a tapered basket and a Ø22 magnet cup, cone outward under the tail-top grille
- **Mounting**: No tabs or holes: clamp it by its rim against the inside of the tail's top face (a printed ring or a bead of hot glue)
- **Verify**: Rim width on arrival (Adafruit redesigned the cone in January 2024).
- **Sources**: [1](https://www.adafruit.com/product/3968)

## MAX98357A I2S amplifier breakout

- **Qty** 1 · **Mass** 2 g · **Confidence** listing · **Model** `max98357a_i2s_amp`
- **Envelope**: ~18 x 19 PCB
- **Sources**: [1](https://www.adafruit.com/product/3006)

## INMP441 I2S MEMS microphone breakout

- **Qty** 1 · **Mass** 2 g · **Confidence** listing · **Model** `microphone_inmp441`
- **Envelope**: ~Ø14 round PCB; acoustic port on the bottom of the PCB
- **Verify**: Port side faces the head's mic hole.

## RAFI LUMOTAST 22 latching e-stop, 1.15.105.032/0000 (NC + NO, no indicator) or 1.15.105.031/0000 (with status indicator)

- **Qty** 1 · **Mass** 25 g · **Confidence** listing (series data; per-part pages not readable) · **Model** `estop_bezel`, `estop_mushroom`
- **Envelope**: Ø22.3 panel cutout, ring nut from the rear, 17.9 mm behind the panel (17.6 on one Digi-Key page), 0.8 mm tab terminals, IP65, twist to release, 2.5 A 250 V. Head size not published: modelled Ø32 x 20 proud
- **Verify**: Confirm on the Digi-Key page that the part has an NO contact as well as the NC (the anti-spark switch's button wiring needs both), and the mushroom size. Digi-Key showed 0 in stock for both when checked (Oct 2026).
- **Sources**: [1](https://www.digikey.com/en/product-highlight/r/rafi/lumotast-22-emergency-stop-push-buttons), [2](https://www.automationmagazine.co.uk/lumotast-22-from-rafi-space-saving-emergency-stop-pushbutton-with-redundant-nc-contact/)

## Heltec 6S/7S 80 A split-port BMS, 3.7 V Li-ion, set for 6S

- **Qty** 1 · **Mass** 60 g · **Confidence** listing · **Model** `bms_6s_100a`
- **Envelope**: 83 x 55 x 8 (Heltec listing). Modelled on edge across the bay just ahead of the pack (x 12..20), pads toward -y
- **Loads**: 80 A continuous, 200 A current-limit protection (listing); balance 83 mA
- **Verify**: Ask Heltec for the discharge over-current delay (it must ride through 80 A for 50 ms; a 200 A limit suggests it will, but no delay is published) and the charge-port current rating (>= 4 A). Weight is an estimate.
- **Sources**: [1](https://heltec-bms.com/product/6s-7s-bms-30a-60a-80a-150a-200a-300a-350a-balance-battery-protection-board/)

## Flipsky Antispark Switch Pro V3.0, heatsink version (SKU ANSPFS14SH)

- **Qty** 1 · **Mass** 60 g · **Confidence** listing · **Model** `antispark_switch_120a`
- **Envelope**: 42.2 x 33 x 26.6 with heatsink and heat shrink, 12 AWG leads (Flipsky). 3-14S, 60 A continuous with the heatsink (100 A with the aluminium-PCB version, 83.9 x 45 x 17), 200 A max. Switches the battery negative
- **Mounting**: Lies on the tail shelf, leads along y
- **Verify**: Its button is a 3-wire latching changeover (S common, + = NO, - = NC); the e-stop's contacts replace it (see README). Bench-test that pressing the e-stop switches it off before relying on it. Weight is an estimate.
- **Sources**: [1](https://flipsky.net/collections/anti-spark-switch/products/flipsky-antispark-switch-pro-with-aluminum-pcb-case-200a-for-electric-skateboard-ebike-scooter-robots)

## 40 A blade fuse + inline holder

- **Qty** 1 · **Mass** 10 g · **Confidence** estimate · **Model** `main_fuse_40a`
- **Envelope**: ~24 x 10 x 20 holder; modeled 24 x 10 x 20

## Pololu D36V50F5 (5 V, Pi and peripherals) x2 + D36V50F7 (7.5 V, head servos) x1

- **Qty** 3 · **Mass** 7 g · **Confidence** datasheet · **Model** `buck_5v1_5a_pi`, `buck_7v4_10a_servos`, `buck_5v_5a_peripherals`
- **Envelope**: 25.4 x 25.4 x 9.5 each, 3x M2 holes (Ø2.18), 5.5-50 V in. Pololu graph at 24 V in, room temperature, still air: ~7.3 A (5 V), ~6.4 A (7.5 V)
- **Verify**: No published ambient rating: the bay reaches 45-50 C, so expect less than the room-temperature figures (thermal shutdown protects them). The 7.5 V board covers the head servos' ~1 A typical; all four STS3215 stalled at once (~11 A) would trip it. The Pi gets 5.0 V, not 5.1: keep its 20 AWG feed short.
- **Sources**: [1](https://www.pololu.com/product/4091), [2](https://www.pololu.com/product/4093)

## Waveshare Bus Servo Adapter (A)

- **Qty** 1 · **Mass** 10 g · **Confidence** estimate · **Model** `bus_servo_adapter`
- **Envelope**: Modelled on the front bulkhead (envelope estimated)
- **Verify**: Envelope and mounting holes on arrival.
- **Sources**: [1](https://www.waveshare.com/bus-servo-adapter-a.htm)

## CAN transceiver breakout, 3.3 V (SN65HVD230)

- **Qty** 2 · **Mass** 2 g · **Confidence** listing · **Model** `teensy_40_dual_can`
- **Envelope**: ~10 x 15 PCB; modelled as part of the Teensy carrier
- **Mounting**: Solder to the carrier; 120 ohm terminator fitted on most SN65HVD230 boards (keep it: the Teensy is one end of each bus)
- **Verify**: If you use an MCP2562FD instead: VDD must be 5 V (VIO 3.3 V for the Teensy), and fit the 120 ohm yourself.

## 74AHCT125 quad level shifter (WS2812B data)

- **Qty** 1 · **Mass** 1 g · **Confidence** datasheet
- **Envelope**: DIP-14 or SOIC-14; on the Teensy carrier (not modelled)

## 40 x 40 x 10 mm 5 V PWM fan (Noctua NF-A4x10 5V PWM)

- **Qty** 1 · **Mass** 9 g · **Confidence** datasheet · **Model** `fan_40x10_5v`
- **Envelope**: 40 x 40 x 10; 4x M3 on 32 mm
- **Mounting**: 4x M3 on the rear bulkhead's tail face, Ø38 bore
- **Verify**: 25 kHz PWM input is open-drain with an internal pull-up to 5 V: drive it from Teensy pin 5 through a 2N7002, never directly.
- **Sources**: [1](https://noctua.at/en/nf-a4x10-5v-pwm)

## Arducam UB0234 2MP wide-angle USB 2.0 camera board (OV2710, M12 lens)

- **Qty** 1 · **Mass** 8 g · **Confidence** listing · **Model** `usb_nav_cam`
- **Envelope**: 32 x 32 board, 105 deg horizontal FOV (listing). Lens holder and depth as modelled (15 x 15, estimate)
- **Mounting**: 4 posts off the front cap: M2 self-tapping at the bottom corners, locating pins at the top
- **Verify**: Hole positions and the USB plug's exit on arrival (Arducam's own pages weren't readable).
- **Sources**: [1](https://welectron.com/Arducam-UB0234-2MP-Wide-Angle-USB20-Camera-Board-with-M12-Lens)

## GX16-2 aviation panel socket + plug (charge input)

- **Qty** 1 · **Mass** 15 g · **Confidence** listing · **Model** `charge_port_gx16`
- **Envelope**: Thread Ø16 (panel hole Ø16.2), flange on the front, solder cups to ~30 behind the panel
- **Loads**: Contacts ~5 A: 5 A fuse on the charge lead
- **Verify**: The panel pins are at pack voltage when unplugged unless the charge lead has a series diode (fitted: see README).

## 1 W LED on a 15 x 12 board + AO3400 MOSFET board + 6.8 ohm 1 W resistor

- **Qty** 1 · **Mass** 3 g · **Confidence** estimate · **Model** `projector_led_1w`, `projector_mosfet`
- **Envelope**: LED board 15 x 12 (the ODM flashlight insert's pocket); MOSFET board modelled in the head
- **Verify**: Use a MOSFET fully on at 3.3 V gate drive (AO3400 class, not IRLZ44N). 6.8 ohm sets ~270 mA from 5 V at Vf ~3.2 V; or a 350 mA constant-current driver.

## 6S Li-ion charger, 25.2 V CC/CV, 3-4 A

- **Qty** 1 · **Mass** 0 g · **Confidence** estimate
- **Envelope**: External brick (not on the robot)
- **Verify**: Fit the GX16 plug to its output lead, observing polarity.

## Smooth-On VytaFlex 40 urethane rubber (tire treads)

- **Qty** 1 · **Mass** 90 g · **Confidence** datasheet (material); tread geometry is the design · **Model** `left/right_foot_bottom_tpu`
- **Envelope**: Cast tread per wheel: Ø150 OD x 32 wide, 6 thick (hub rim Ø138), crowned edges R4; ~87 cm³ each. Mass assumes density ~1.0 (estimate)
- **Mounting**: Mechanically keyed to the printed hub: 12x Ø3 axial through-holes + circumferential grooves (no bond to PLA/PETG)
- **Loads**: Shore 40A, 1:1 by volume, 30 min pot life, 16 h demold (Smooth-On). Hub sees ~250 N radial on landings (design_loads.md)
- **Verify**: Density and full-cure time on the datasheet; measure μ on your floors (cad/tires.md).
- **Sources**: [1](https://sculpturesupply.com/products/vytaflex-40), [2](https://www.smooth-on.com/products/reoflex-40/)
