mosschief/super_duck/assets/cad/foot_assembly__cad_print.stl

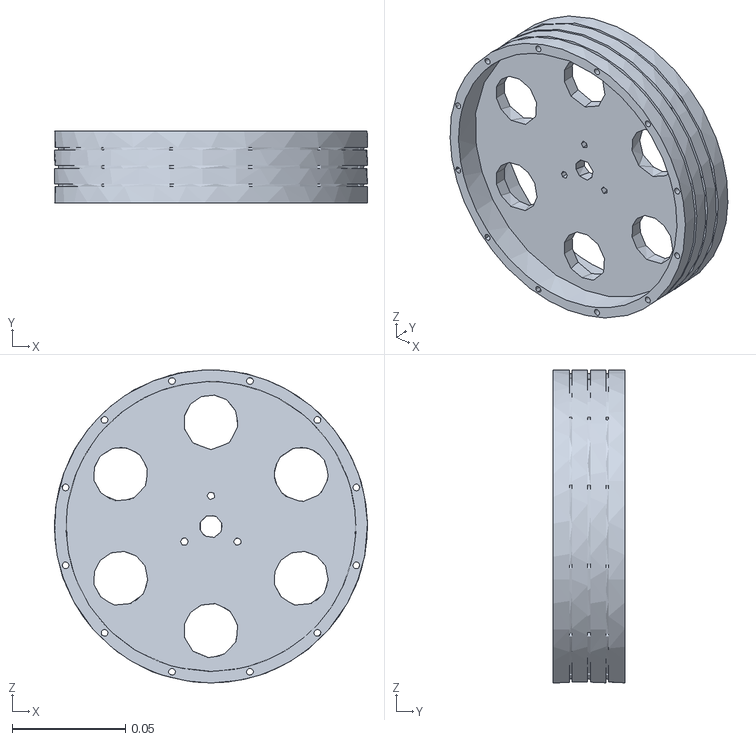
[picture p1: CAD file, 2026-10-31]
assets/cad/foot_assembly__cad_print.stl
0.138 x 0.032 x 0.138
