mosschief/super_duck/assets/cad/left_roll_to_pitch_assembly__cad_print.stl

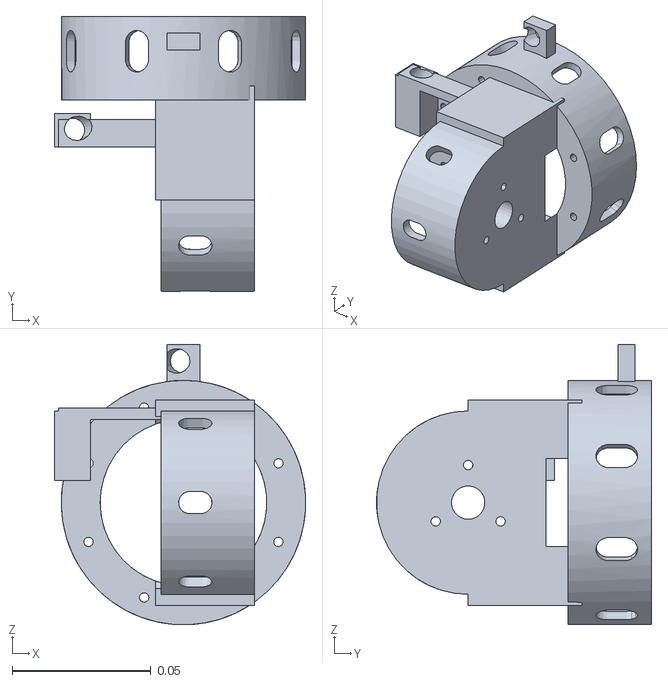
[picture p2: CAD file, 2026-10-31]
assets/cad/left_roll_to_pitch_assembly__cad_print.stl
0.0905 x 0.099 x 0.101
