mosschief/super_duck/assets/cad/hip_roll_assembly__cad_print.stl

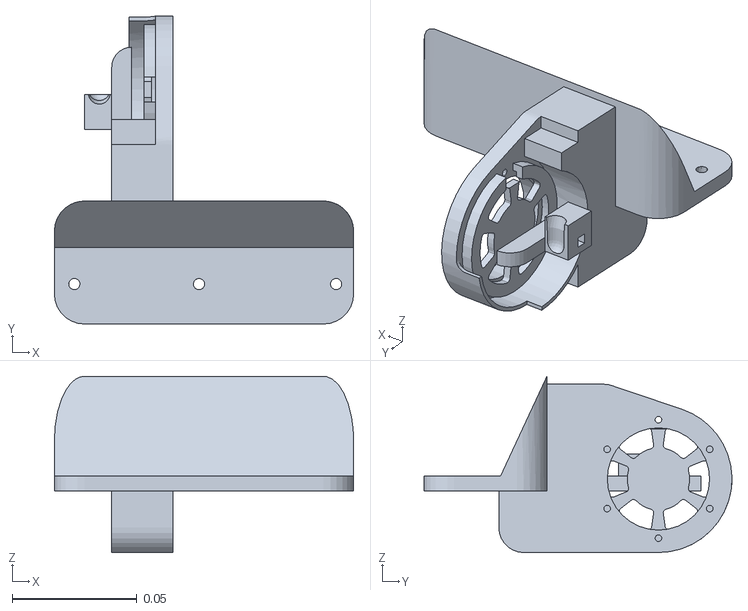
[picture p3: CAD file, 2026-10-31]
assets/cad/hip_roll_assembly__cad_print.stl
0.12 x 0.123 x 0.0706
