mosschief/super_duck/assets/cad/knee_and_ankle_assembly_2__cad_print.stl

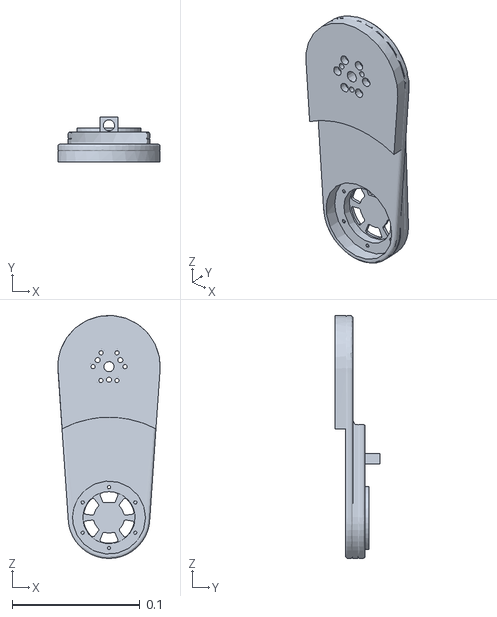
[picture p4: CAD file, 2026-10-31]
assets/cad/knee_and_ankle_assembly_2__cad_print.stl
0.0801 x 0.035 x 0.19
