mosschief/super_duck/assets/cad/trunk_assembly__cad_shell.stl

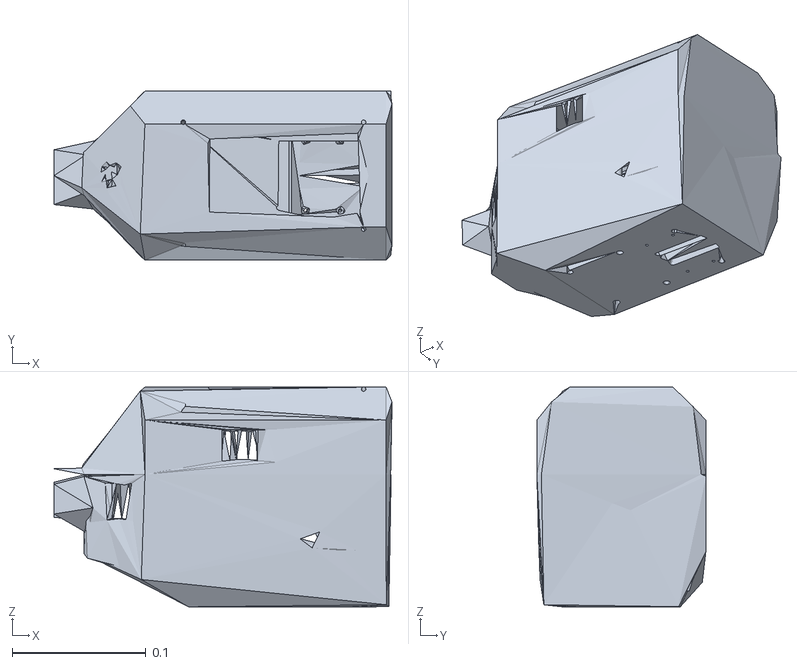
[picture p5: CAD file, 2026-10-31]
assets/cad/trunk_assembly__cad_shell.stl
0.253 x 0.127 x 0.164
