mosschief/super_duck/assets/cad/hip_roll_assembly_2__cad_motor.stl

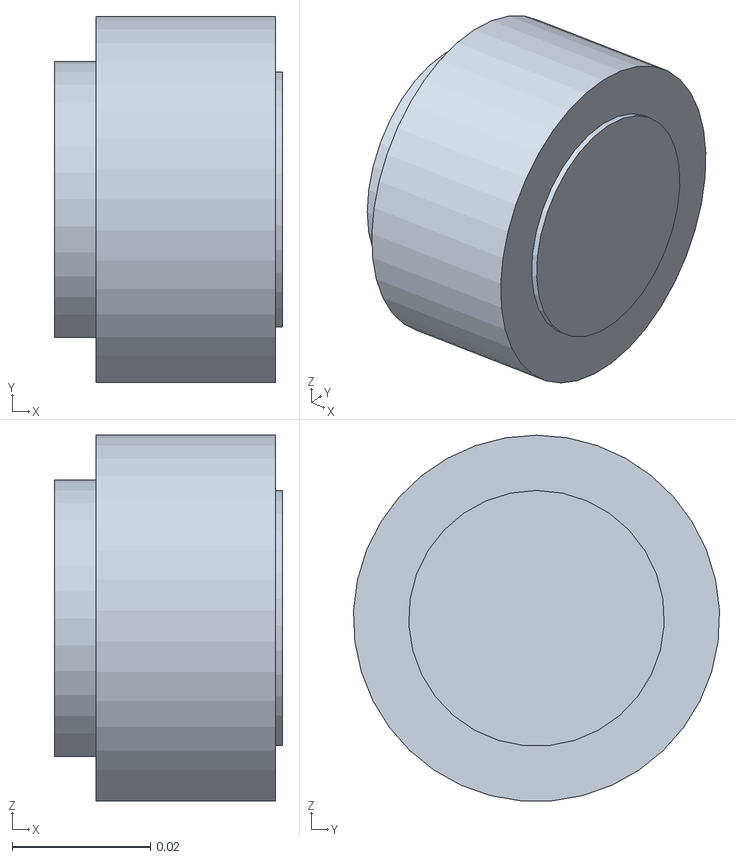
[picture p6: CAD file, 2026-10-26]
assets/cad/hip_roll_assembly_2__cad_motor.stl
0.033 x 0.053 x 0.0529
