mosschief/super_duck/assets/cad/trunk_assembly__cad_cell.stl

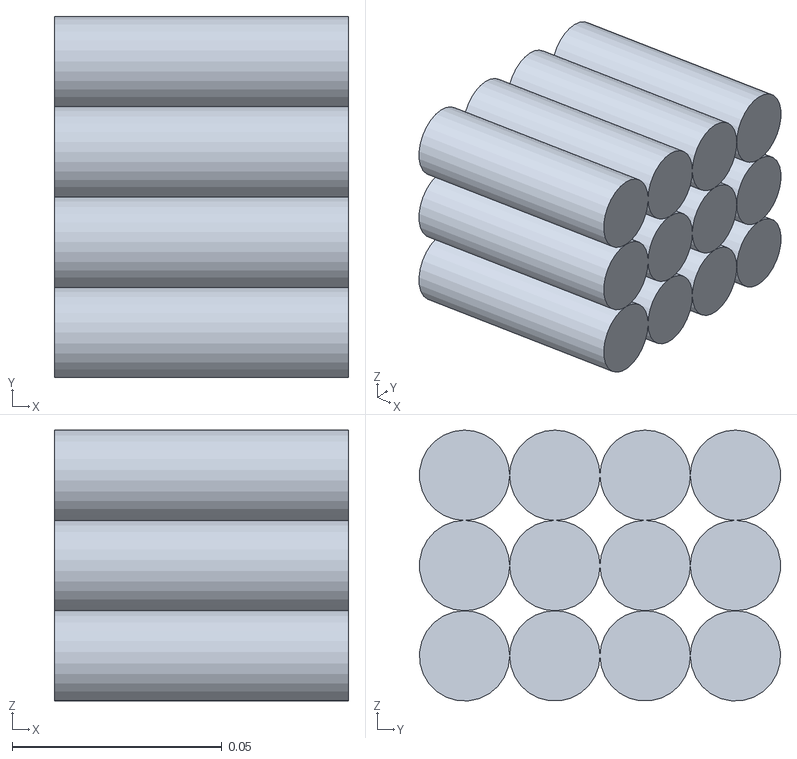
[picture p7: CAD file, 2026-10-26]
assets/cad/trunk_assembly__cad_cell.stl
0.0702 x 0.0861 x 0.0646
