mosschief/super_duck/assets/cad/knee_and_ankle_assembly__cad_print.stl

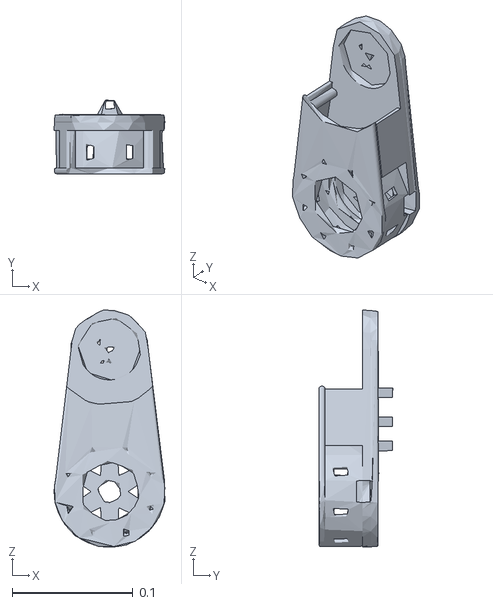
[picture p8: CAD file, 2026-10-26]
assets/cad/knee_and_ankle_assembly__cad_print.stl
0.0917 x 0.0612 x 0.196
