mosschief/super_duck/assets/cad/trunk_assembly__cad_chip.stl

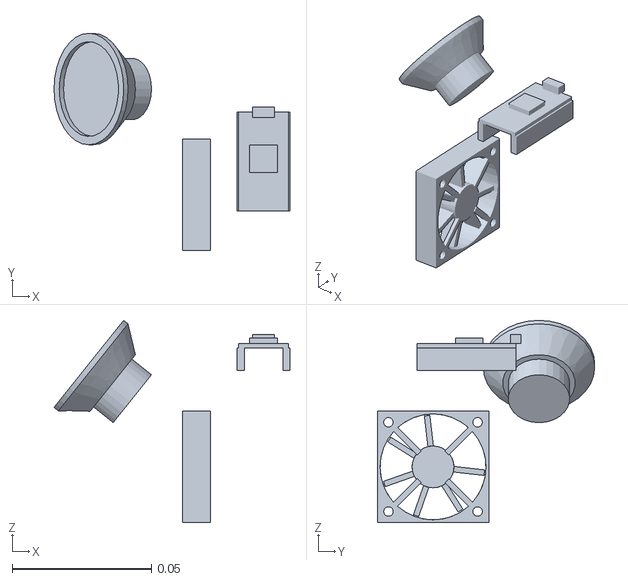
[picture p9: CAD file, 2026-10-26]
assets/cad/trunk_assembly__cad_chip.stl
0.0847 x 0.078 x 0.0726
