mosschief/super_duck/assets/cad/head_assembly__cad_led.stl

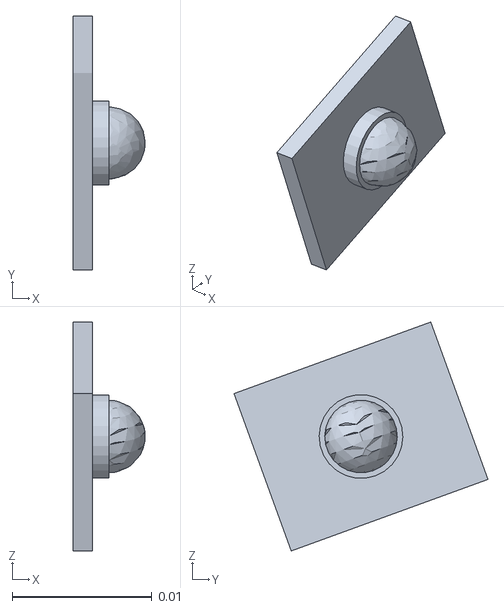
[picture p10: CAD file, 2026-10-26]
assets/cad/head_assembly__cad_led.stl
0.00518 x 0.0182 x 0.0164
