mosschief/super_duck/assets/cad/trunk_assembly__cad_pcb.stl

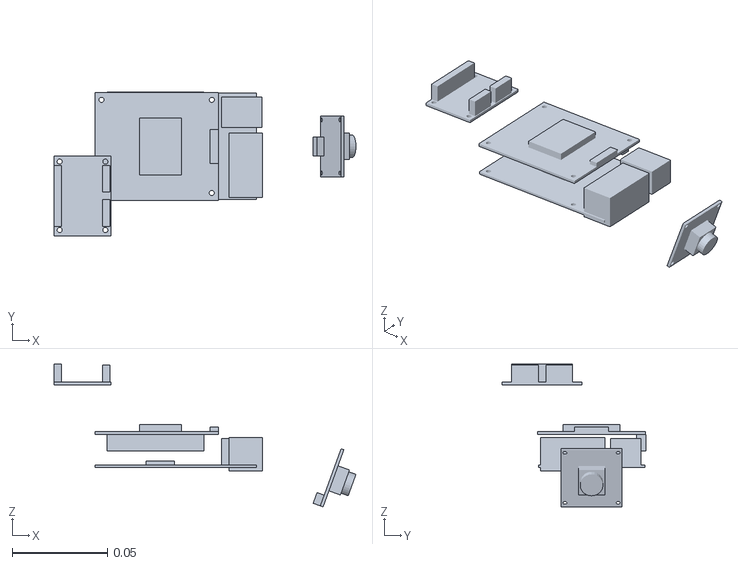
[picture p11: CAD file, 2026-10-26]
assets/cad/trunk_assembly__cad_pcb.stl
0.159 x 0.0755 x 0.0751
