mosschief/super_duck/assets/cad/head_assembly__cad_led_ring.stl

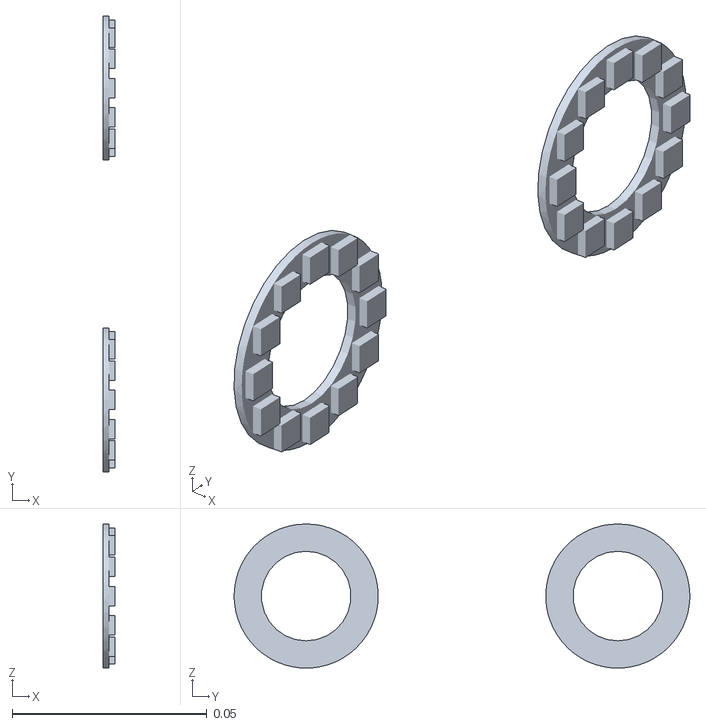
[picture p12: CAD file, 2026-10-26]
assets/cad/head_assembly__cad_led_ring.stl
0.0032 x 0.117 x 0.037
