mosschief/super_duck/assets/cad/neck_pitch_assembly__cad_servo.stl

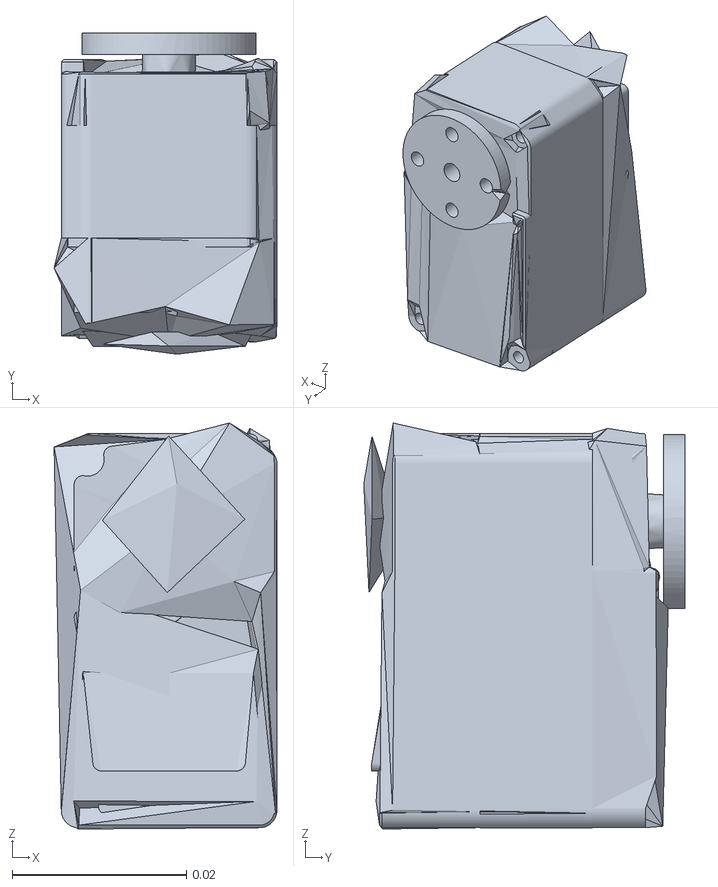
[picture p13: CAD file, 2026-10-26]
assets/cad/neck_pitch_assembly__cad_servo.stl
0.0255 x 0.0369 x 0.0465
