mosschief/super_duck/assets/cad/trunk_assembly__cad_print.stl

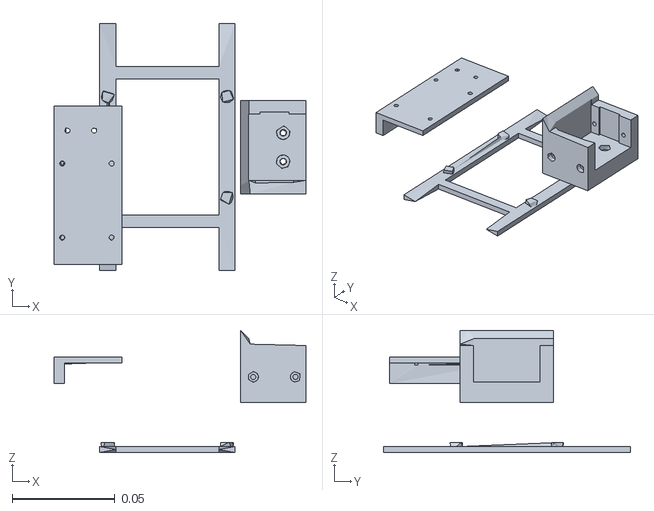
[picture p14: CAD file, 2026-10-26]
assets/cad/trunk_assembly__cad_print.stl
0.122 x 0.12 x 0.0593
