mosschief/super_duck/assets/cad/trunk_assembly__cad_cell_wrap.stl

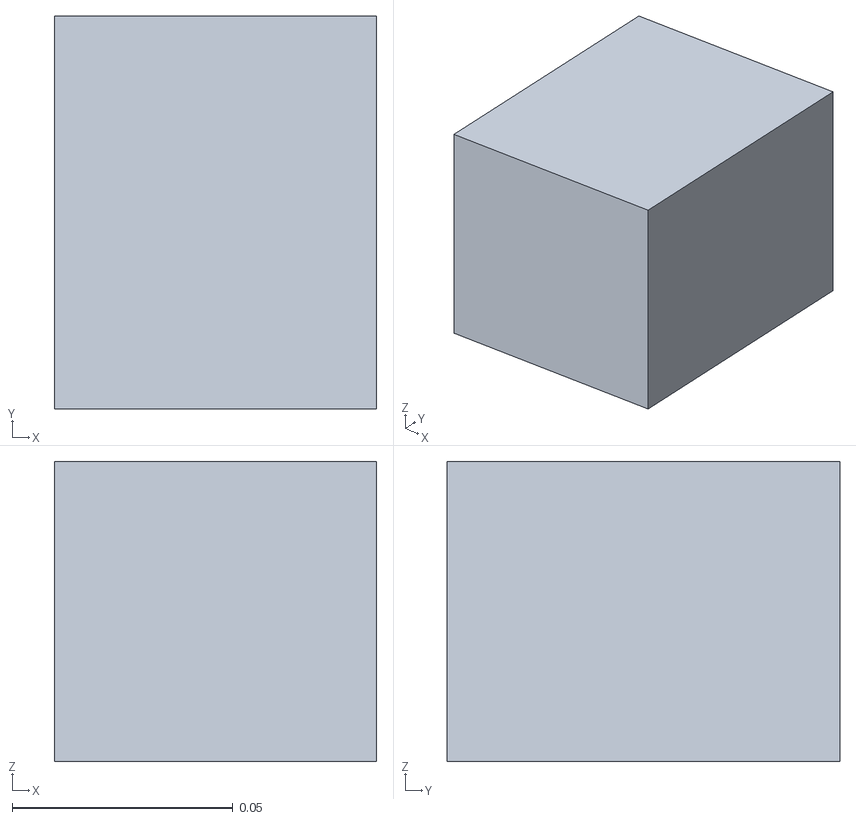
[picture p15: CAD file, 2026-10-26]
assets/cad/trunk_assembly__cad_cell_wrap.stl
0.073 x 0.089 x 0.068
