mosschief/super_duck/assets/cad/trunk_assembly__cad_servo.stl

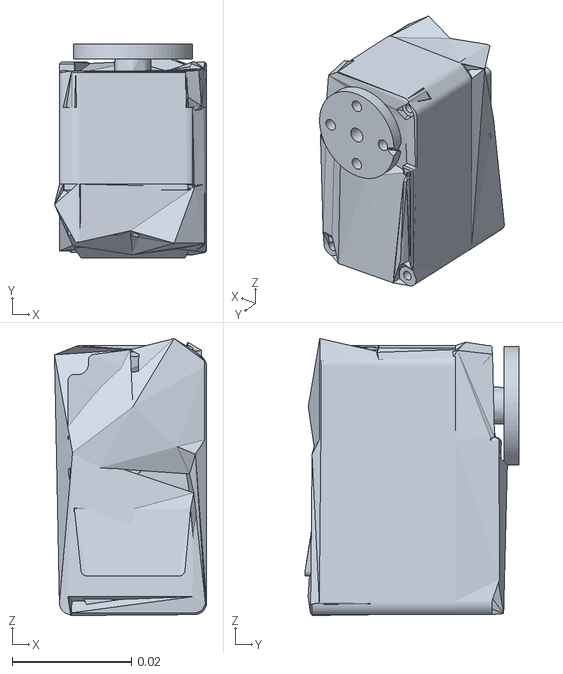
[picture p16: CAD file, 2026-10-26]
assets/cad/trunk_assembly__cad_servo.stl
0.0255 x 0.0359 x 0.0465
