mosschief/super_duck/assets/cad/head_assembly__cad_shell.stl

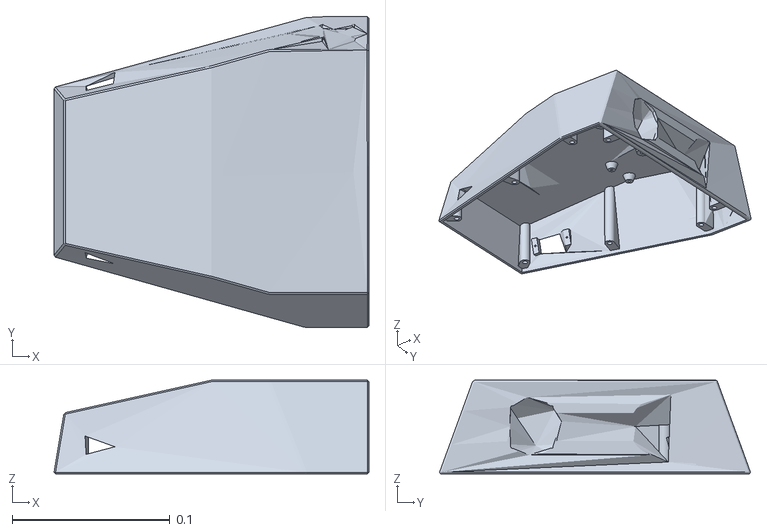
[picture p17: CAD file, 2026-10-26]
assets/cad/head_assembly__cad_shell.stl
0.2 x 0.197 x 0.0594
