mosschief/super_duck/assets/cad/knee_and_ankle_assembly_4__cad_harness.stl

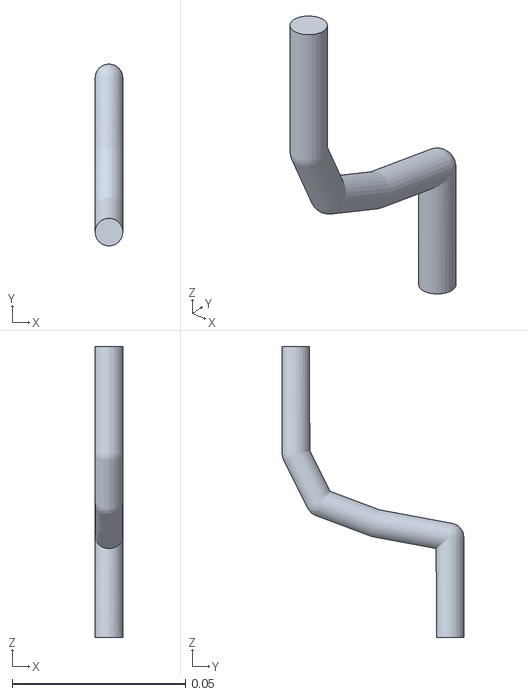
[picture p18: CAD file, 2026-10-26]
assets/cad/knee_and_ankle_assembly_4__cad_harness.stl
0.008 x 0.0524 x 0.084
