mosschief/super_duck/assets/cad/neck_yaw_assembly__cad_print.stl

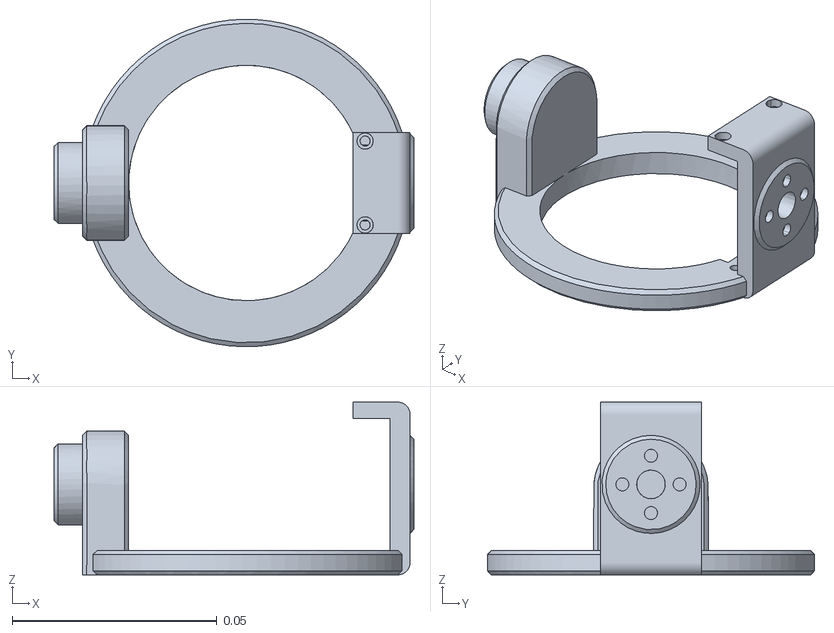
[picture p19: CAD file, 2026-10-26]
assets/cad/neck_yaw_assembly__cad_print.stl
0.088 x 0.08 x 0.0422
