mosschief/super_duck/assets/cad/knee_and_ankle_assembly__cad_harness.stl

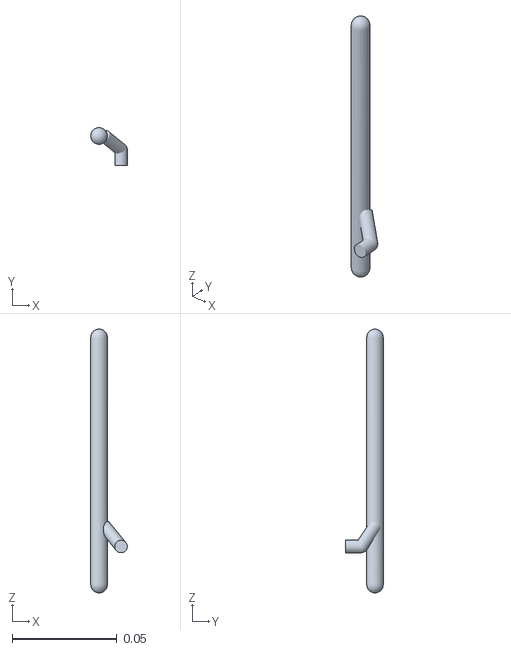
[picture p20: CAD file, 2026-10-26]
assets/cad/knee_and_ankle_assembly__cad_harness.stl
0.0175 x 0.018 x 0.126
