mosschief/super_duck/assets/cad/right_roll_to_pitch_assembly__cad_harness.stl

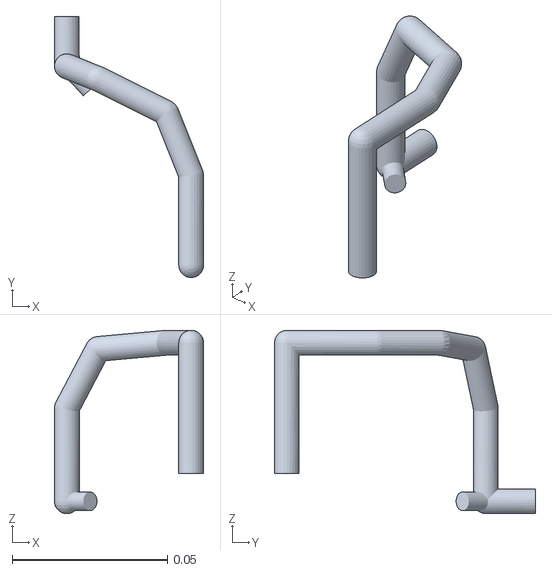
[picture p21: CAD file, 2026-10-26]
assets/cad/right_roll_to_pitch_assembly__cad_harness.stl
0.048 x 0.084 x 0.059
