mosschief/super_duck/assets/cad/knee_and_ankle_assembly__cad_motor.stl

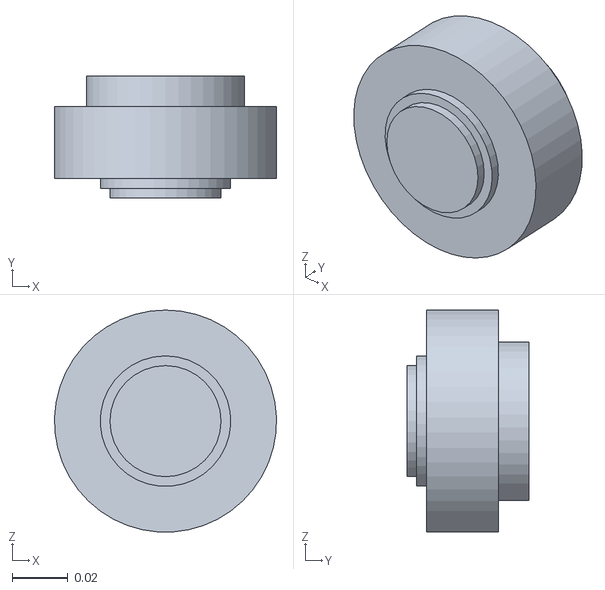
[picture p22: CAD file, 2026-10-26]
assets/cad/knee_and_ankle_assembly__cad_motor.stl
0.08 x 0.044 x 0.0799
