mosschief/super_duck/assets/cad/neck_pitch_assembly__cad_print.stl

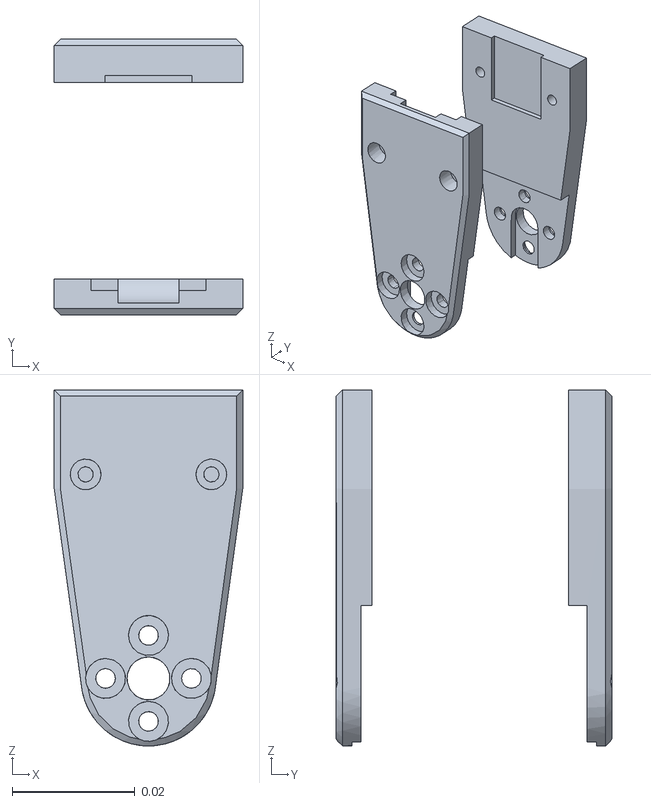
[picture p23: CAD file, 2026-10-26]
assets/cad/neck_pitch_assembly__cad_print.stl
0.0307 x 0.0449 x 0.058
