mosschief/super_duck/assets/cad/hip_roll_assembly_2__cad_harness.stl

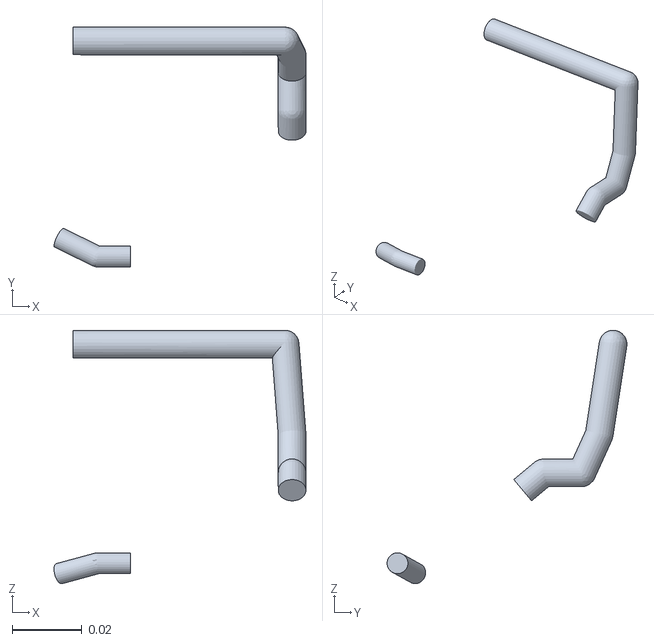
[picture p24: CAD file, 2026-10-26]
assets/cad/hip_roll_assembly_2__cad_harness.stl
0.0725 x 0.069 x 0.0729
