mosschief/super_duck/assets/cad/trunk_assembly__cad_power.stl

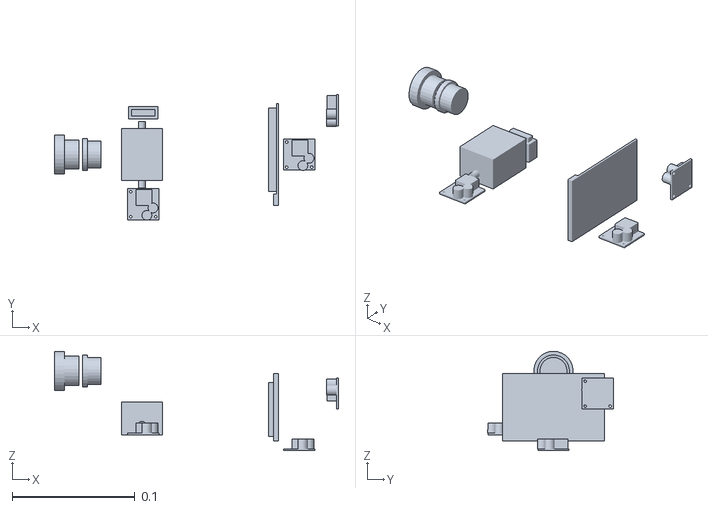
[picture p25: CAD file, 2026-10-26]
assets/cad/trunk_assembly__cad_power.stl
0.231 x 0.102 x 0.081
