mosschief/super_duck/assets/cad/knee_and_ankle_assembly__cad_metal.stl

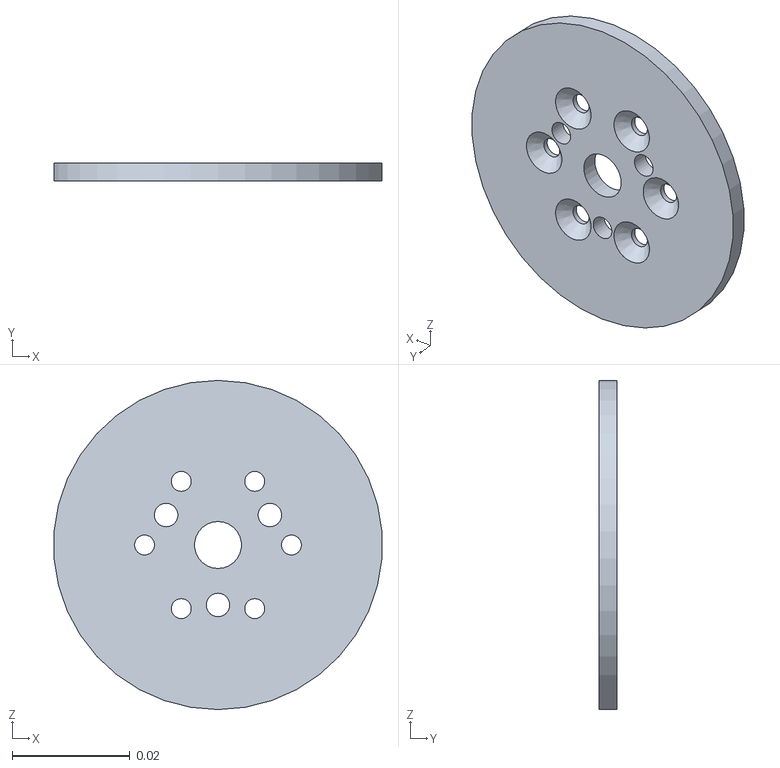
[picture p26: CAD file, 2026-10-26]
assets/cad/knee_and_ankle_assembly__cad_metal.stl
0.0558 x 0.003 x 0.056
