mosschief/super_duck/assets/cad/trunk_assembly__cad_servo_adapter.stl

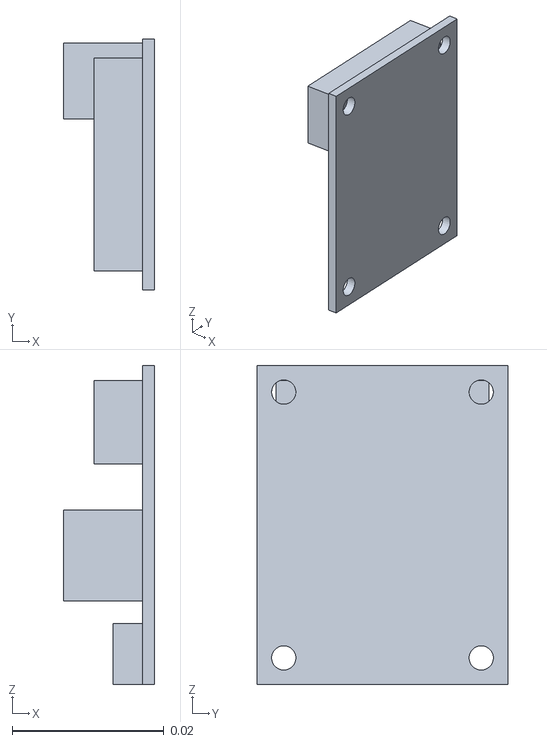
[picture p27: CAD file, 2026-10-26]
assets/cad/trunk_assembly__cad_servo_adapter.stl
0.012 x 0.033 x 0.042
