mosschief/super_duck/assets/cad/trunk_assembly__cad_amp.stl

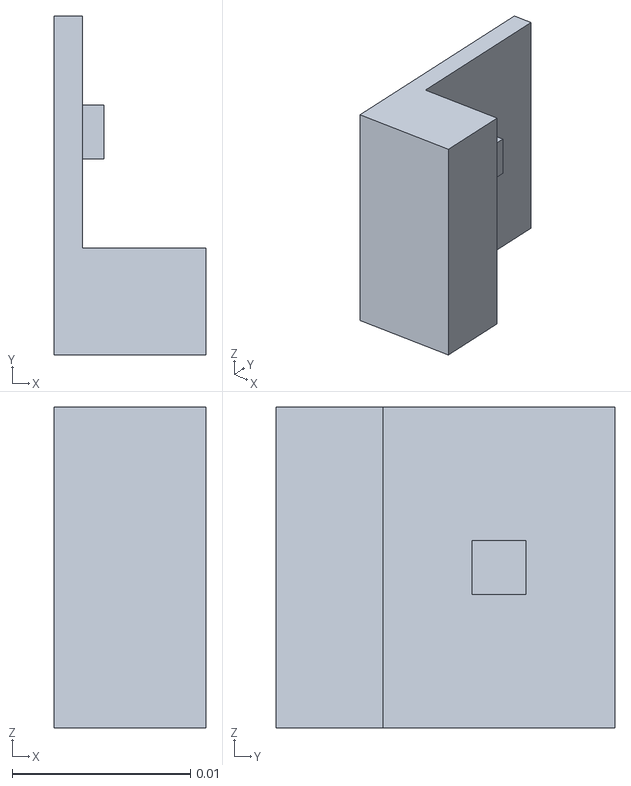
[picture p28: CAD file, 2026-10-26]
assets/cad/trunk_assembly__cad_amp.stl
0.0085 x 0.019 x 0.018
