mosschief/super_duck/assets/cad/hip_roll_assembly_2__cad_rubber.stl

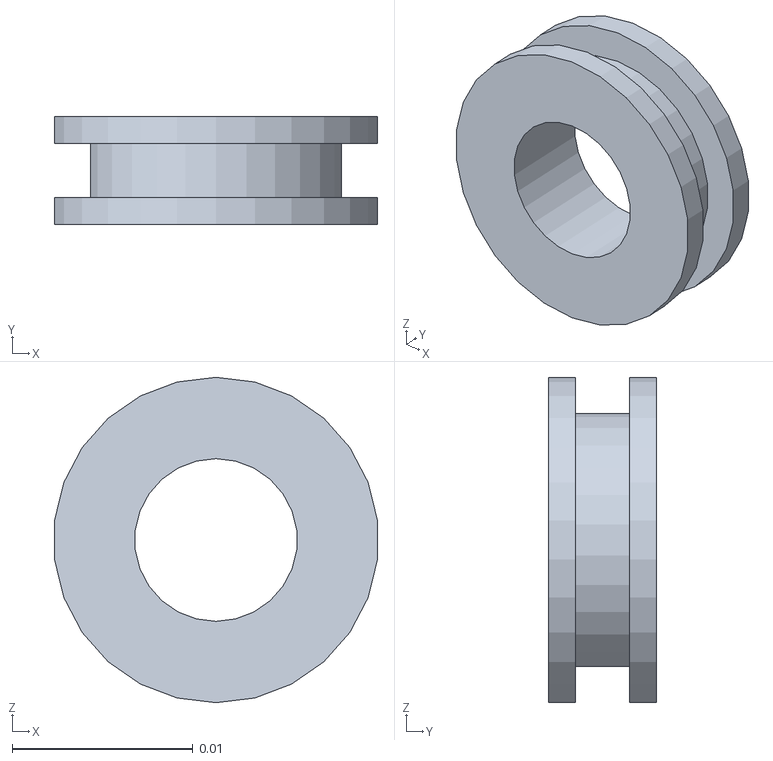
[picture p29: CAD file, 2026-10-26]
assets/cad/hip_roll_assembly_2__cad_rubber.stl
0.0179 x 0.006 x 0.018
