mosschief/super_duck/assets/cad/head_assembly__cad_diffuser.stl

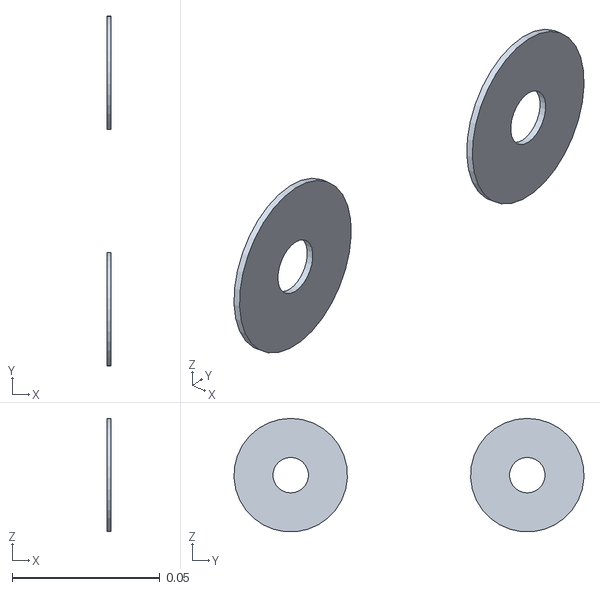
[picture p30: CAD file, 2026-10-26]
assets/cad/head_assembly__cad_diffuser.stl
0.0015 x 0.118 x 0.0383
