mosschief/super_duck/assets/cad/head_assembly__cad_metal.stl

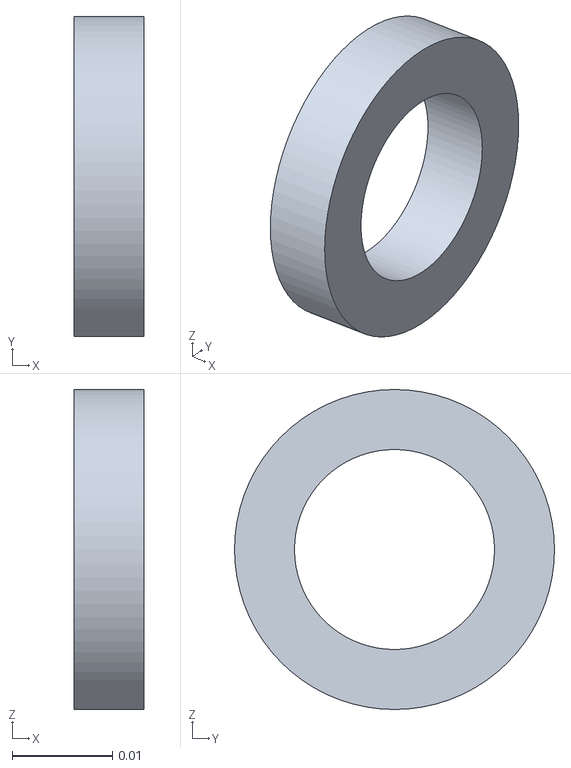
[picture p31: CAD file, 2026-10-26]
assets/cad/head_assembly__cad_metal.stl
0.007 x 0.032 x 0.032
