mosschief/super_duck/assets/cad/trunk_assembly__cad_metal.stl

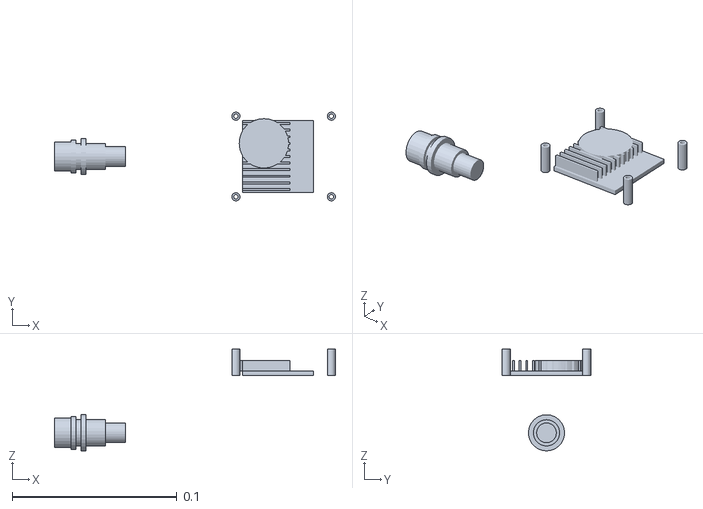
[picture p32: CAD file, 2026-10-26]
assets/cad/trunk_assembly__cad_metal.stl
0.171 x 0.054 x 0.0619
