mosschief/super_duck/assets/cad/head_assembly__cad_servo.stl

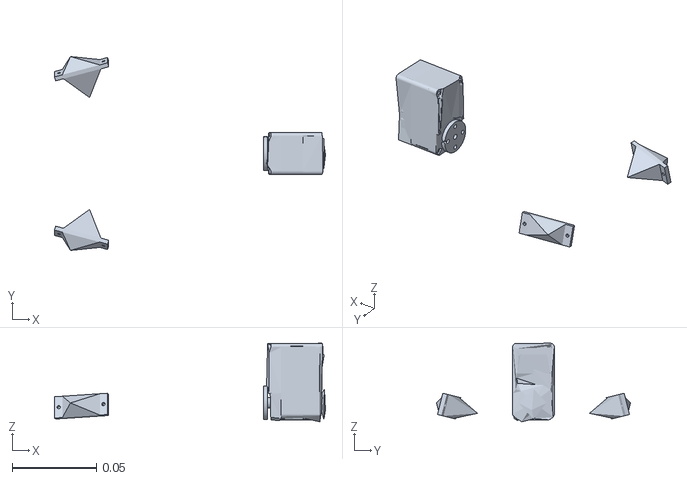
[picture p33: CAD file, 2026-10-26]
assets/cad/head_assembly__cad_servo.stl
0.16 x 0.115 x 0.0465
