mosschief/super_duck/assets/cad/trunk_assembly__cad_imu.stl

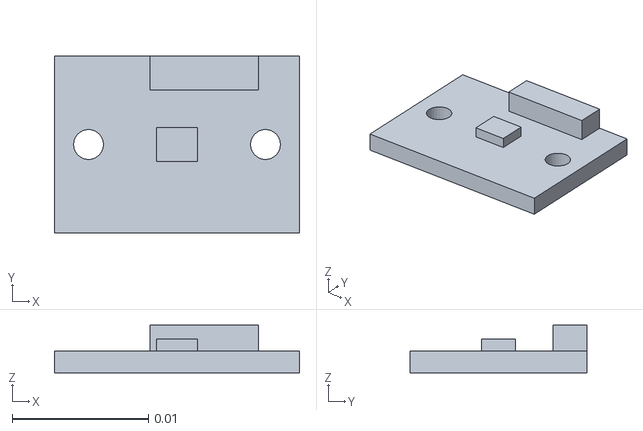
[picture p34: CAD file, 2026-10-26]
assets/cad/trunk_assembly__cad_imu.stl
0.018 x 0.013 x 0.0035
