mosschief/super_duck/assets/cad/neck_yaw_assembly__cad_servo.stl

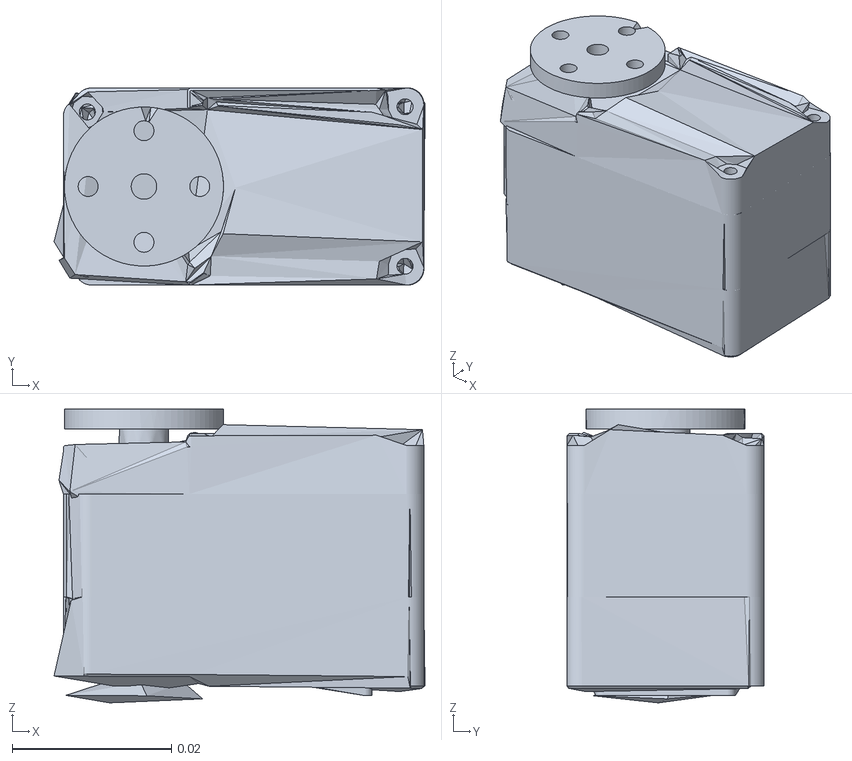
[picture p35: CAD file, 2026-10-26]
assets/cad/neck_yaw_assembly__cad_servo.stl
0.0465 x 0.0247 x 0.0369
