mosschief/super_duck/assets/cad/head_assembly__cad_print.stl

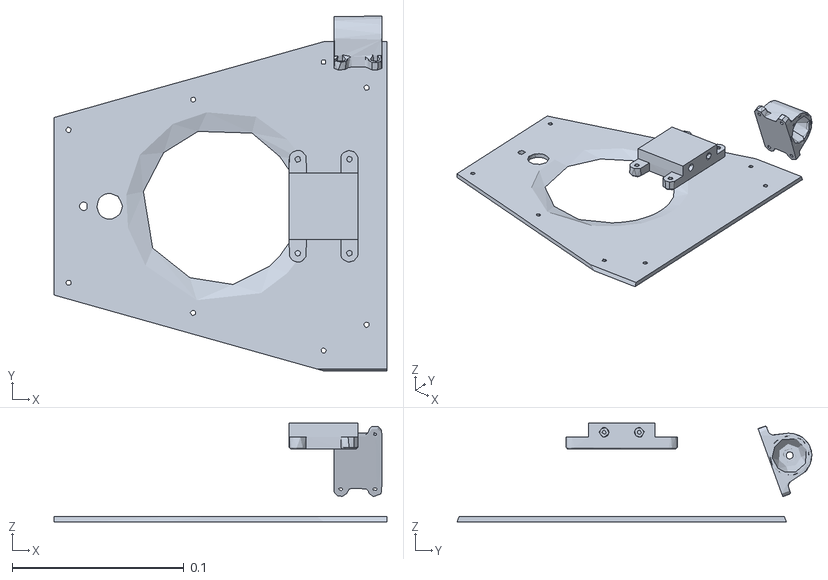
[picture p36: CAD file, 2026-10-26]
assets/cad/head_assembly__cad_print.stl
0.194 x 0.206 x 0.0574
