mosschief/super_duck/assets/cad/head_assembly__cad_pcb.stl

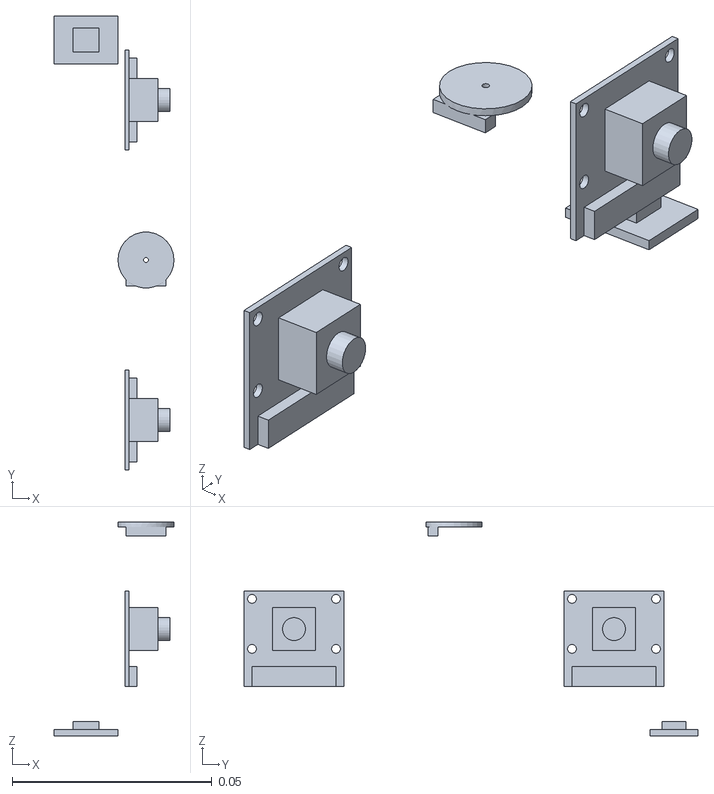
[picture p37: CAD file, 2026-10-26]
assets/cad/head_assembly__cad_pcb.stl
0.03 x 0.113 x 0.0534
