mosschief/super_duck/assets/cad/L_shin_hull.stl

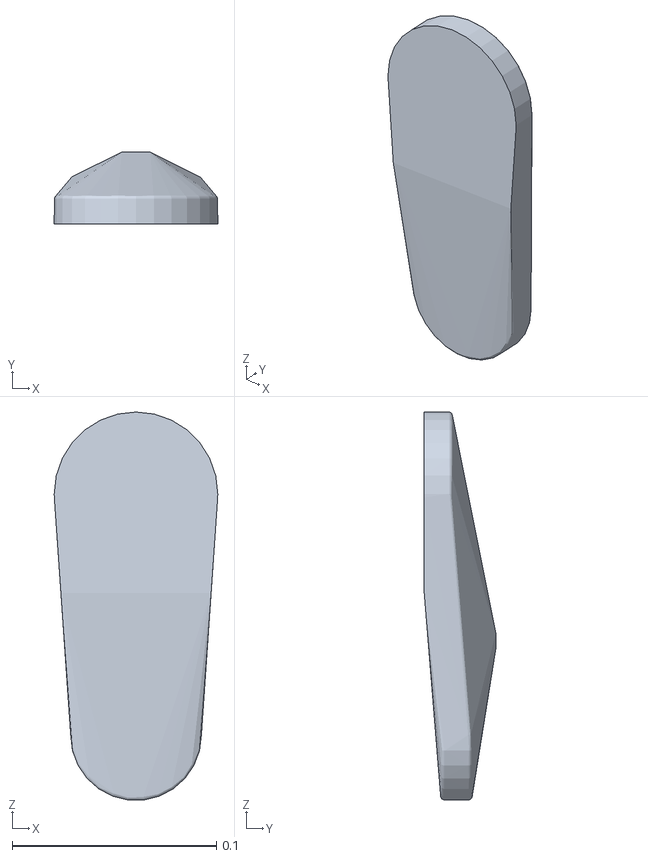
[picture p38: CAD file, 2026-10-31]
assets/cad/L_shin_hull.stl
0.08 x 0.035 x 0.19
