mosschief/super_duck/assets/cad/L_hip_roll_yoke_hull.stl

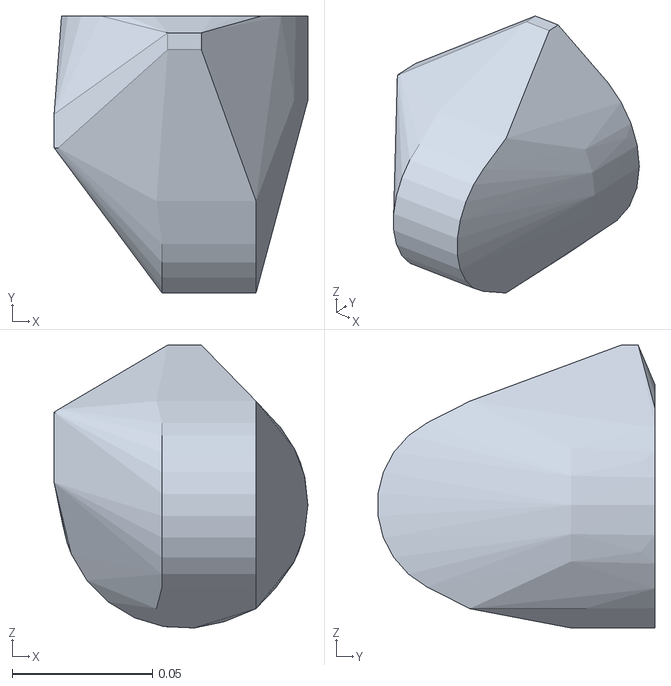
[picture p39: CAD file, 2026-10-31]
assets/cad/L_hip_roll_yoke_hull.stl
0.0905 x 0.0988 x 0.101
