mosschief/super_duck/assets/cad/L_hip_mount_hull.stl

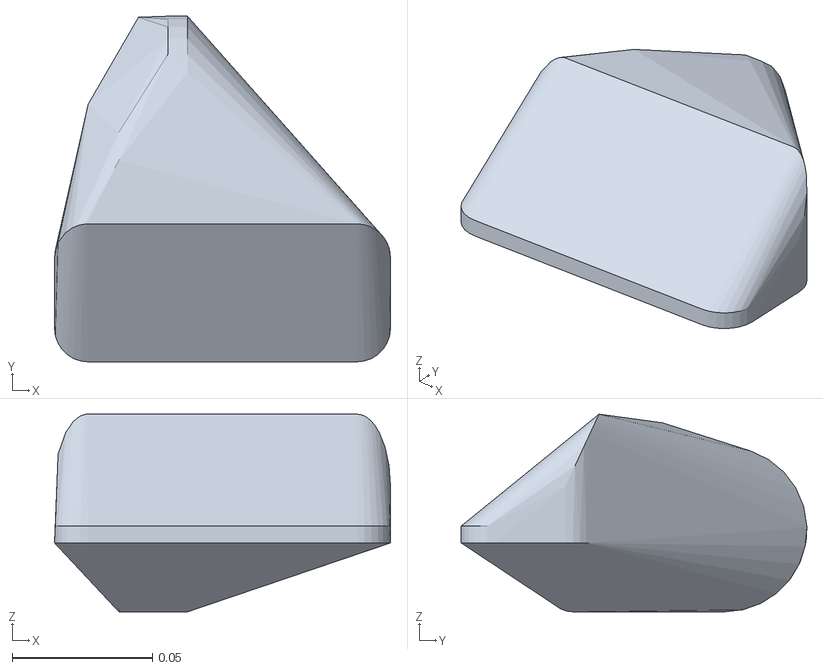
[picture p40: CAD file, 2026-10-31]
assets/cad/L_hip_mount_hull.stl
0.12 x 0.123 x 0.0706
