mosschief/super_duck/assets/cad/trunk_shell_hull.stl

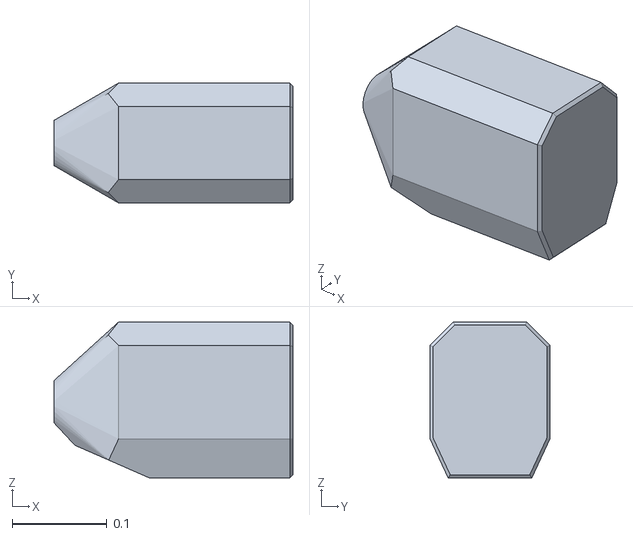
[picture p41: CAD file, 2026-10-31]
assets/cad/trunk_shell_hull.stl
0.252 x 0.126 x 0.164
