mosschief/super_duck/assets/cad/sts3215_head_yaw_hull.stl

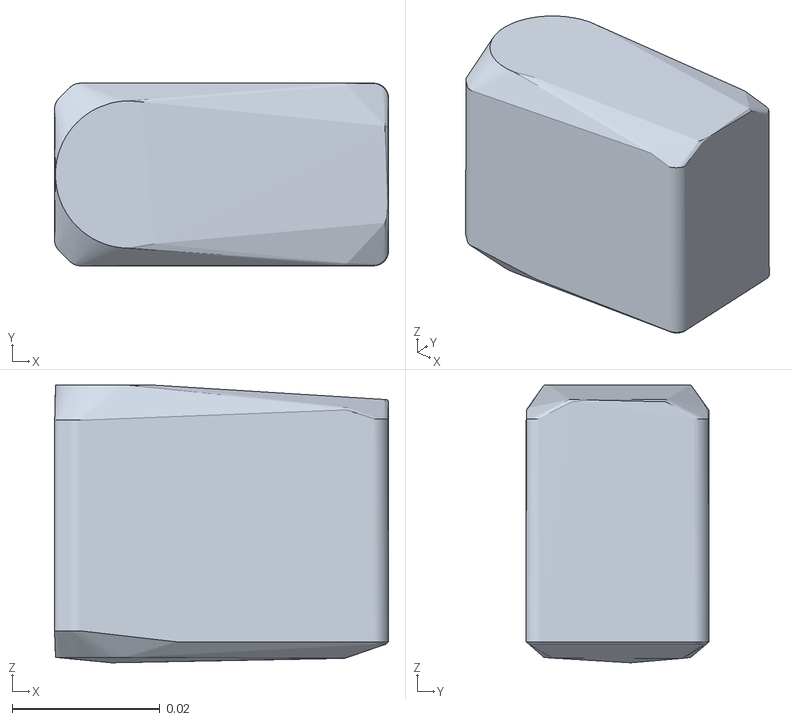
[picture p42: CAD file, 2026-10-26]
assets/cad/sts3215_head_yaw_hull.stl
0.0452 x 0.0247 x 0.0376
