mosschief/super_duck/assets/cad/L_thigh_inner_hull.stl

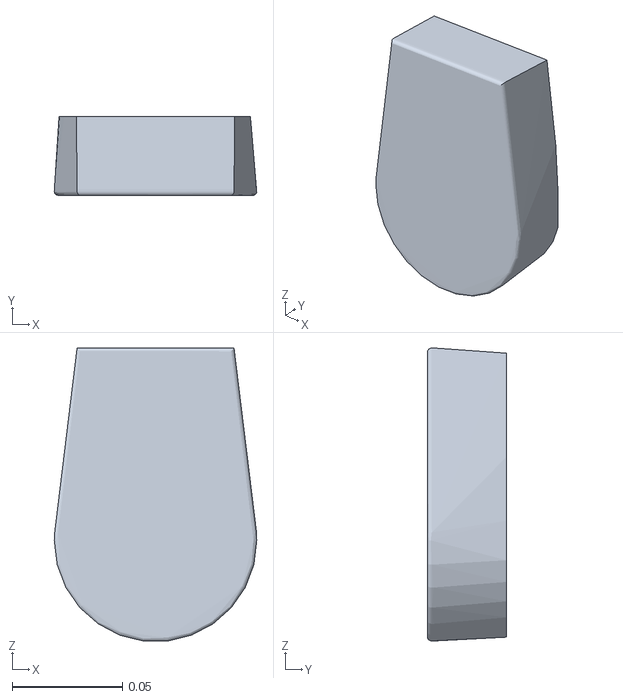
[picture p43: CAD file, 2026-10-26]
assets/cad/L_thigh_inner_hull.stl
0.0919 x 0.036 x 0.133
