mosschief/super_duck/assets/cad/sts3215_head_pitch_hull.stl

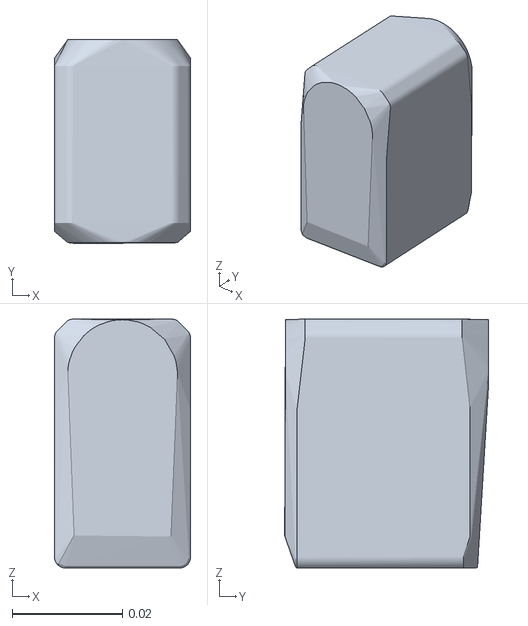
[picture p44: CAD file, 2026-10-26]
assets/cad/sts3215_head_pitch_hull.stl
0.0247 x 0.037 x 0.0452
