mosschief/super_duck/assets/cad/R_knee_gim6010_hull.stl

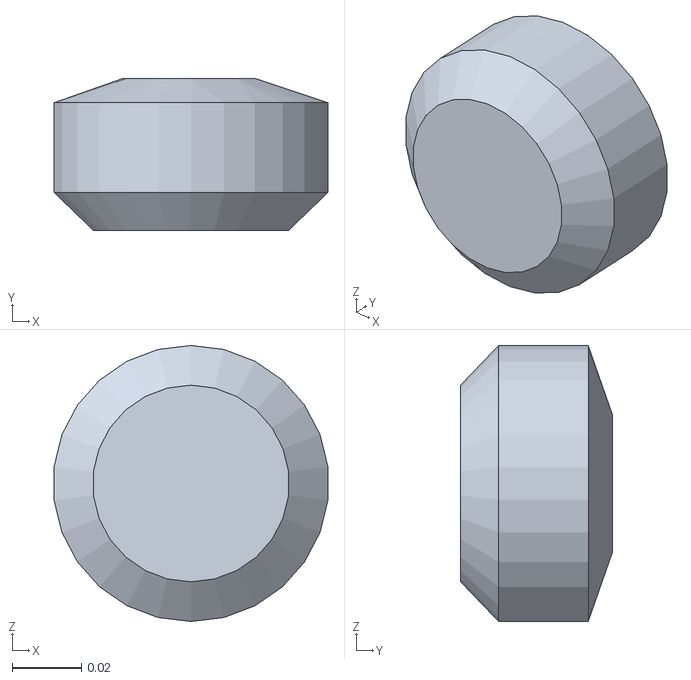
[picture p45: CAD file, 2026-10-26]
assets/cad/R_knee_gim6010_hull.stl
0.0794 x 0.044 x 0.08
