mosschief/super_duck/assets/cad/neck_left_sheet_hull.stl

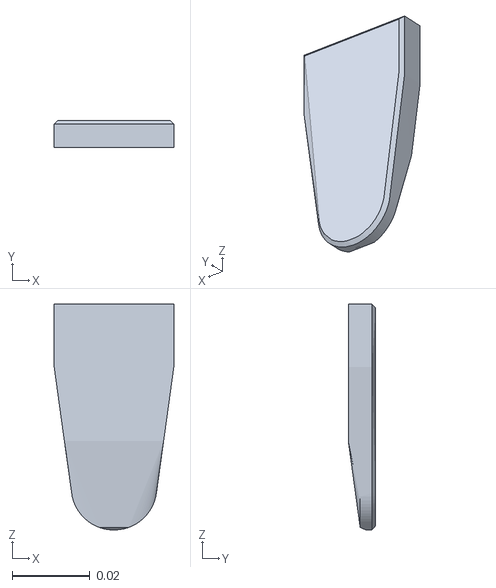
[picture p46: CAD file, 2026-10-26]
assets/cad/neck_left_sheet_hull.stl
0.0307 x 0.00705 x 0.058
