mosschief/super_duck/assets/cad/right_antenna__cad_antenna.stl

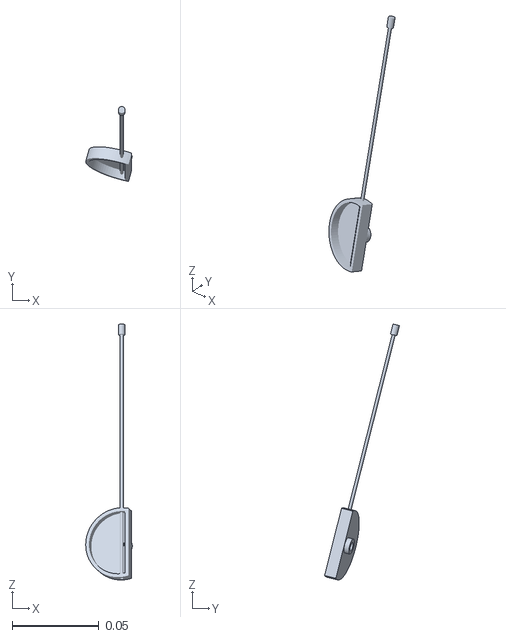
[picture p47: CAD file, 2026-10-26]
assets/cad/right_antenna__cad_antenna.stl
0.0269 x 0.0432 x 0.148
