mosschief/super_duck/assets/cad/R_thigh_outer_hull.stl

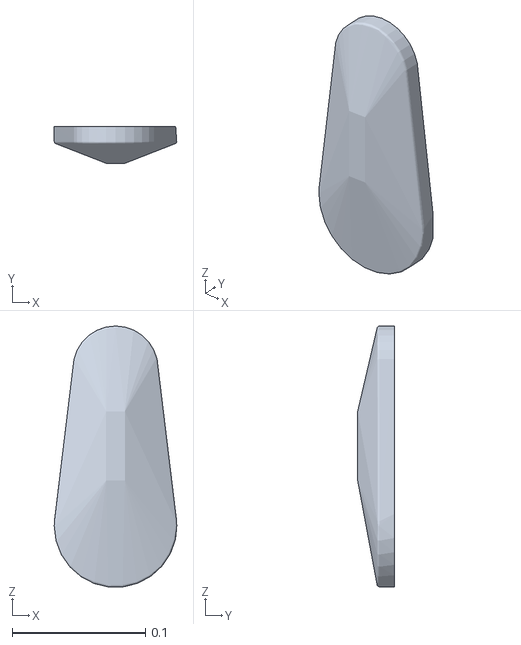
[picture p48: CAD file, 2026-10-26]
assets/cad/R_thigh_outer_hull.stl
0.0919 x 0.0275 x 0.196
