mosschief/super_duck/assets/cad/L_hip_roll_gim4305_hull.stl

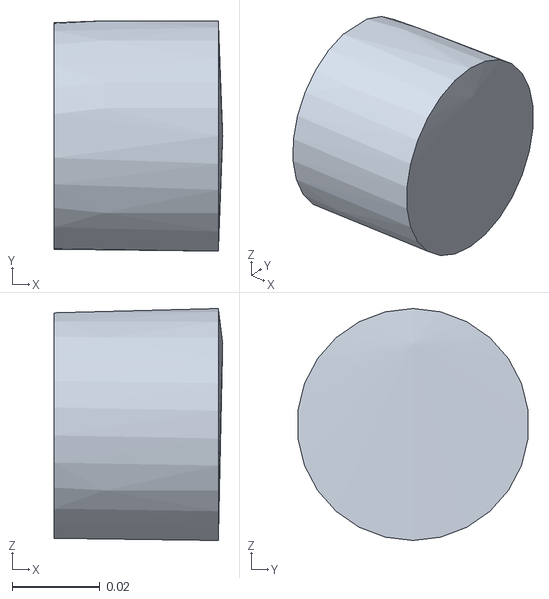
[picture p49: CAD file, 2026-10-26]
assets/cad/L_hip_roll_gim4305_hull.stl
0.0385 x 0.0526 x 0.053
