mosschief/super_duck/assets/cad/R_antenna_hull.stl

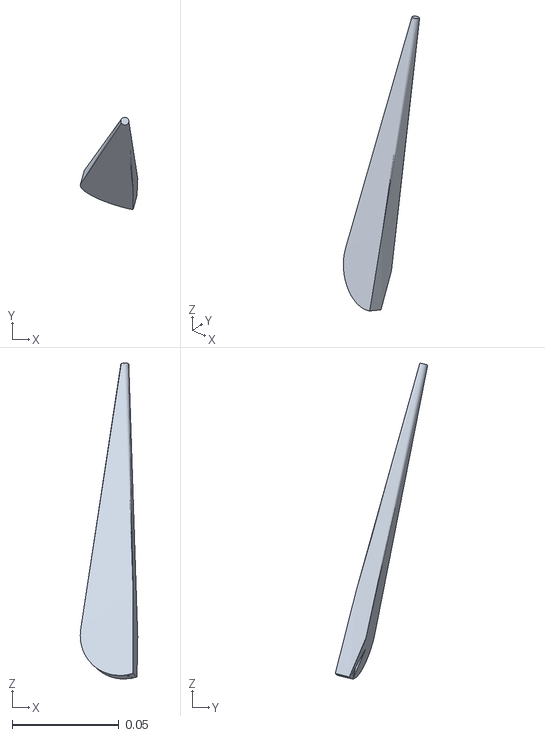
[picture p50: CAD file, 2026-10-26]
assets/cad/R_antenna_hull.stl
0.0269 x 0.0432 x 0.148
