mosschief/super_duck/assets/cad/charge_port_hull.stl

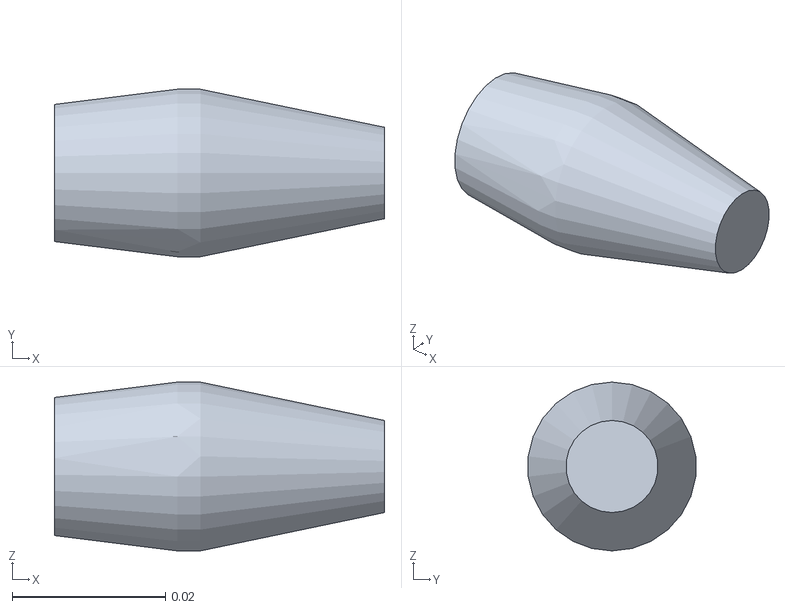
[picture p51: CAD file, 2026-10-26]
assets/cad/charge_port_hull.stl
0.043 x 0.0218 x 0.022
