mosschief/super_duck/assets/cad/head_pitch_to_yaw_hull.stl

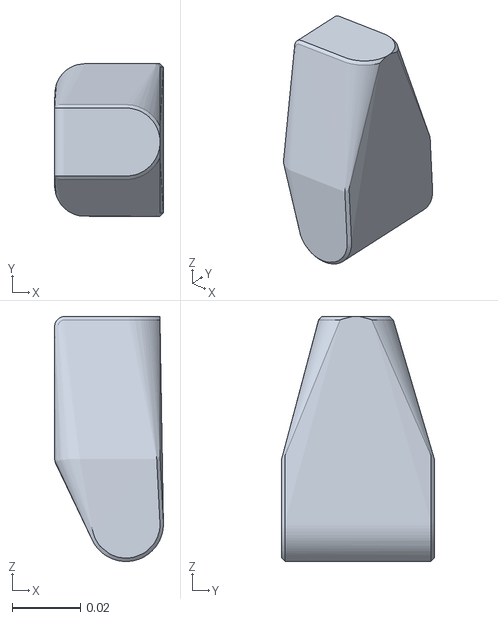
[picture p52: CAD file, 2026-10-26]
assets/cad/head_pitch_to_yaw_hull.stl
0.032 x 0.0449 x 0.072
