mosschief/super_duck/assets/cad/L_wheel_gim4305_hull.stl

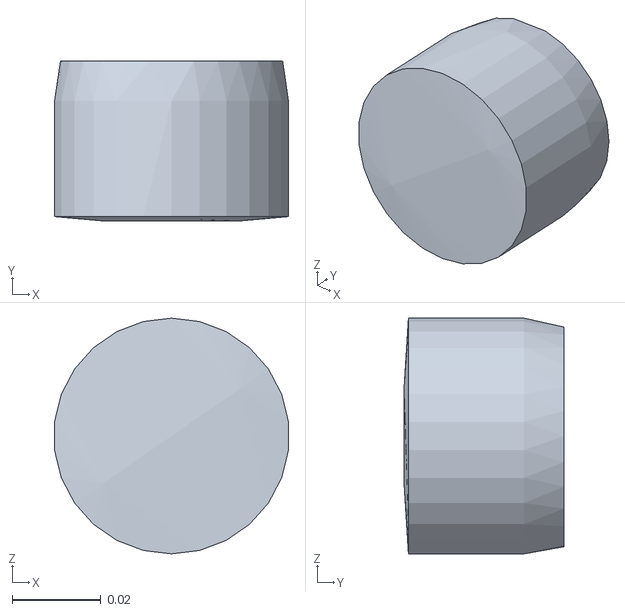
[picture p53: CAD file, 2026-10-26]
assets/cad/L_wheel_gim4305_hull.stl
0.0526 x 0.036 x 0.053
