mosschief/super_duck/assets/cad/projector_pod_hull.stl

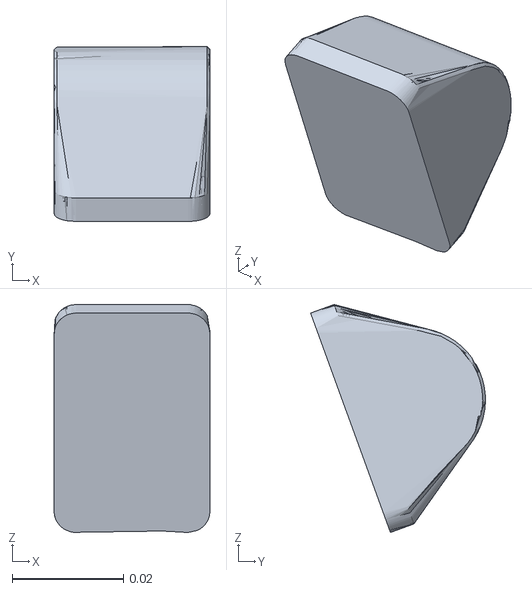
[picture p54: CAD file, 2026-10-26]
assets/cad/projector_pod_hull.stl
0.028 x 0.0315 x 0.041
