mosschief/super_duck/assets/cad/head_yaw_to_roll_hull.stl

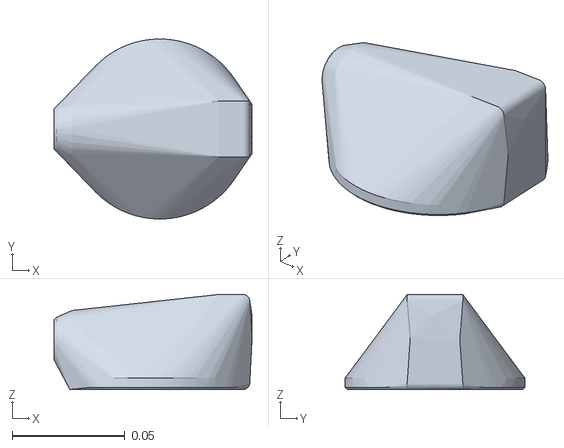
[picture p55: CAD file, 2026-10-26]
assets/cad/head_yaw_to_roll_hull.stl
0.0879 x 0.08 x 0.0422
