mosschief/super_duck/assets/cad/L_antenna_hull.stl

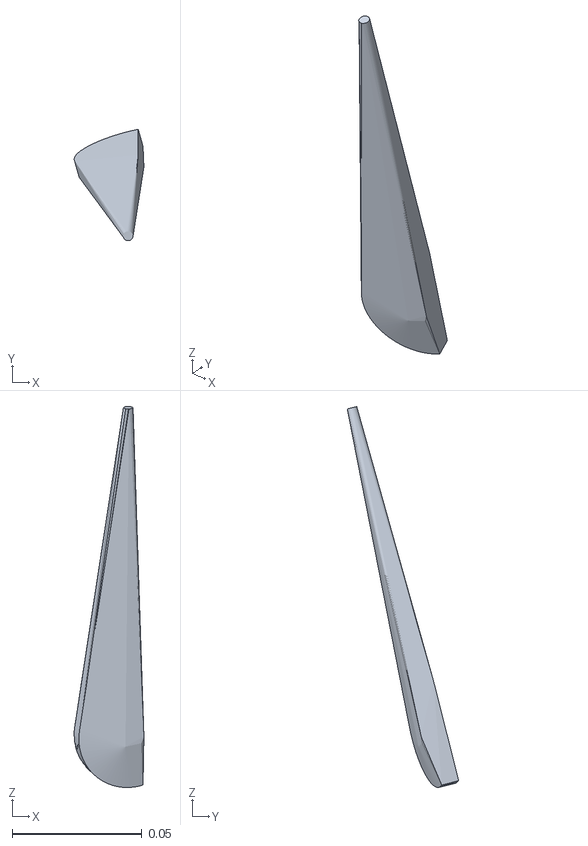
[picture p56: CAD file, 2026-10-26]
assets/cad/L_antenna_hull.stl
0.0269 x 0.0429 x 0.147
