mosschief/super_duck/assets/cad/head_pitch_to_yaw__cad_print.stl

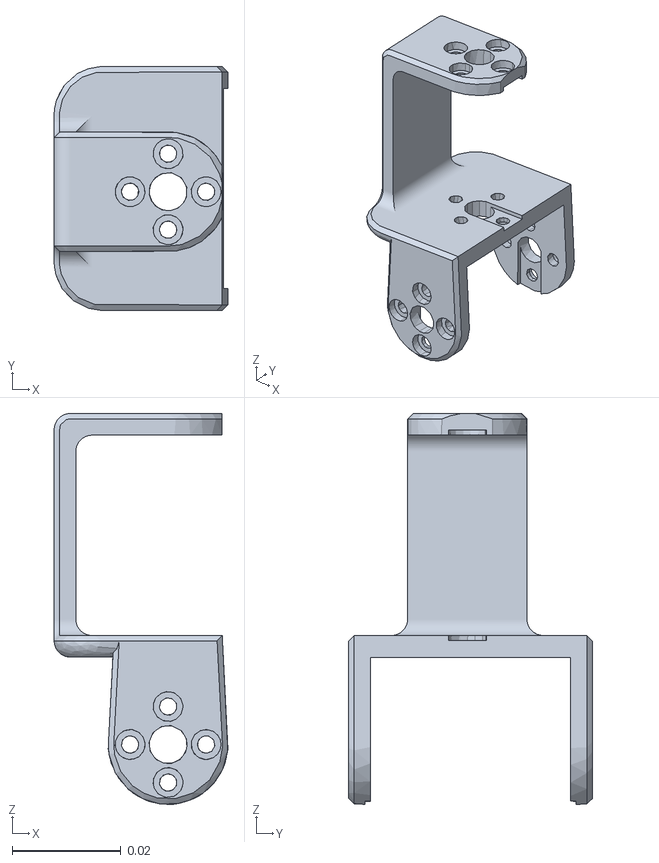
[picture p57: CAD file, 2026-10-26]
assets/cad/head_pitch_to_yaw__cad_print.stl
0.032 x 0.0449 x 0.0721
