mosschief/super_duck/assets/cad/head_shell_hull.stl

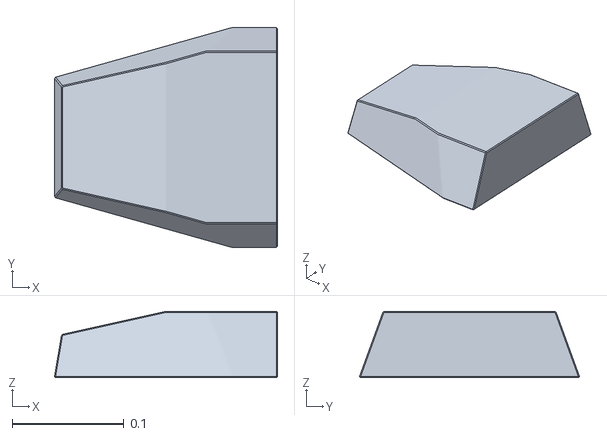
[picture p58: CAD file, 2026-10-26]
assets/cad/head_shell_hull.stl
0.2 x 0.197 x 0.0594
