mosschief/super_duck/assets/cad/estop_hull.stl

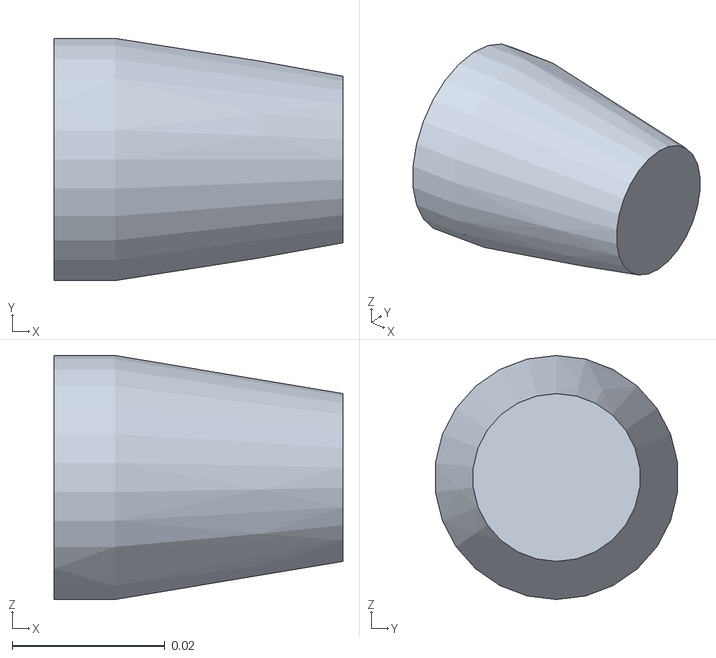
[picture p59: CAD file, 2026-10-26]
assets/cad/estop_hull.stl
0.0379 x 0.0318 x 0.032
