mosschief/super_duck/assets/cad/neck_right_sheet_hull.stl

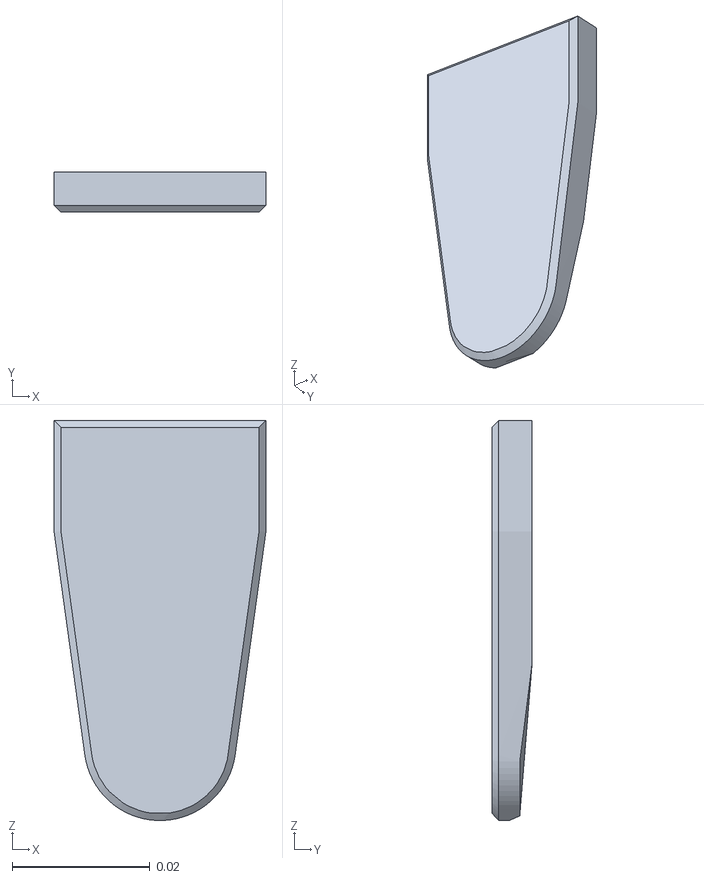
[picture p60: CAD file, 2026-10-26]
assets/cad/neck_right_sheet_hull.stl
0.0307 x 0.00585 x 0.058
