mosschief/super_duck/(list of files, cad)

Other CAD files:
assets/cad/foot_assembly_2__cad_print.stl
assets/cad/right_roll_to_pitch_assembly__cad_print.stl
assets/cad/knee_and_ankle_assembly_4__cad_print.stl
assets/cad/hip_roll_assembly_2__cad_print.stl
assets/cad/knee_and_ankle_assembly_4__cad_motor.stl
assets/cad/knee_and_ankle_assembly_2__cad_motor.stl
assets/cad/knee_and_ankle_assembly_3__cad_motor.stl
assets/cad/hip_roll_assembly__cad_motor.stl
assets/cad/left_roll_to_pitch_assembly__cad_motor.stl
assets/cad/right_roll_to_pitch_assembly__cad_motor.stl
assets/cad/knee_and_ankle_assembly_2__cad_harness.stl
assets/cad/hip_roll_assembly__cad_harness.stl
assets/cad/knee_and_ankle_assembly_3__cad_harness.stl
assets/cad/hip_roll_assembly__cad_rubber.stl
assets/cad/knee_and_ankle_assembly_3__cad_print.stl
assets/cad/knee_and_ankle_assembly_3__cad_metal.stl
assets/cad/left_roll_to_pitch_assembly__cad_harness.stl
assets/cad/R_shin_hull.stl
assets/cad/R_hip_roll_yoke_hull.stl
assets/cad/R_hip_mount_hull.stl
assets/cad/L_knee_gim6010_hull.stl
assets/cad/L_hip_pitch_gim6010_hull.stl
assets/cad/left_antenna__cad_antenna.stl
assets/cad/L_thigh_outer_hull.stl
assets/cad/R_thigh_inner_hull.stl
assets/cad/R_hip_pitch_gim6010_hull.stl
assets/cad/R_wheel_gim4305_hull.stl
assets/cad/R_hip_roll_gim4305_hull.stl
