mosschief/super_duck/docs/design_log.md

# Design Log

Dated engineering notes moved here from the old `GEMINI.md` ("Next Engineering Milestones"). Entries record what was
true **on their date**; some numbers have since changed (e.g. the build is now 7.03 kg from the CAD export, hip roll is
GIM4305-10 again on the zero-scrub geometry, and the balance loop runs on a Teensy 4.0). The README and `reports/` hold
the current figures.

1. Optionally download `.stl` meshes from `apirrone/Open_Duck_Mini` into `./assets/` and uncomment `<mesh ... scale="1.35 1.35 1.35"/>` in `open_duck_wheeled_v2.xml`.

2. ~~Add sim-to-real domain randomization (IMU noise, `2-4 ms` CAN bus latency, push-recovery benchmarking) or a jumping trajectory.~~ Done (2026-10-14): `SimToReal`, `test_scenarios.py --realism N`, `C` jump. Benchmark on 12 randomized robots: stand 12/12, drive/turn/brake 12/12, brake settle 7/12, crouch 5/12, push ±20 N 12/12, ±30 N 9/12 (falls only on μ < 0.93 floors), ±40 N 0/12, jump 12/12, jump while driving 8/12.

   * **Push-recovery limit is traction, not control**: max tire force ≈ μ·m·g ≈ 48 N at μ = 1.25, and a 40 N shove uses most of it. Stronger hips, traction control, torque slew limits and a leg-extension reflex were all tried and didn't help; only more grip (μ ≥ 1.6 with damped legs) survived 40 N. Realistic target on wood/tile (μ ≈ 0.8–1.0) is ~30 N. Hardware levers: grippier/softer tires, lower CoM.
     * *Correction (2026-11-06)*: until then every shove was applied to the massless `base` body, which MuJoCo puts at its inertial frame 0.71 m up (above the 0.57 m robot, 0.43 m above its CoM), so the push limits above were measured with ~3x the lever arm about the CoM (0.43 m vs 0.15 m) of a push on the trunk. Shoves now go to the back of the trunk at 0.43 m (`test_scenarios.PUSH_HEIGHT`): 100 N standing, 80 N at 0.6 m/s, 40 N at 1.5 m/s, 30 N at 1.8 m/s; at 2.2-2.5 m/s under 20 N, where the wheel motors run out of speed.
   * **Knee heat (`thermal` scenario)**: stock GIM4305 knees run at 80% of their 1.0 N·m continuous rating standing and 115% crouched — they would overheat.
   * **GIM6010-8 hip-pitch + knee upgrade evaluated (2026-10-14)**: model in `open_duck_wheeled_v2_gim6010.xml` (+0.95 kg, CoM 13 mm lower). Specs from the SteadyWin GIM6010-8 manual rev1.2: Ø80 × 44 mm incl. driver, 8× M3 on Ø74 bolt circle both faces, output 6× M3 + 3× Ø4 pins, Ø47 spigot; 5 N·m rated @120 rpm, 11 N·m stall, 0.47 N·m/A; MIT mode supported (kp in N·m/turn). Rotor inertia unpublished — armature 0.0048 from the GB6010's 748 g·cm² × 8². Sim should apply the torque-speed curve T ≤ min(11, (285 − rpm)/17): the jump drives joints to ~185 rpm. Needs its own tuning: derived LQR body params, trim `-0.0952` + posture fit `(-0.1588, -0.0566)`, `THRUST_WHEEL_MODE="zero"`, `JUMP_THRUST_TIME=0.05`. Results vs stock on 12 randomized robots: knee heat 20–29% of rating, ±30 N pushes 12/12 (stock 9/12), jump 27 mm with the torque-speed curve (stock 16–17 mm, also curve-free so optimistic) 12/12, crouch 3/12 (stock 9/12, mostly 8.5–9.6 cm vs an 8 cm limit).
   * **Control architecture (2026-10-14)**: `--realism` now models the Feather M4 CAN running the balance loop (`--arch mcu`, 0.3–0.8 ms) vs Linux on the Pi (`--arch pi`, 2–4 ms + scheduling stalls), the IMU (`--imu bno055` = fused orientation and gyro at 100 Hz, assumed from the BNO055 fusion-mode rate — unverified; `--imu fast` = raw 1 kHz-class IMU filtered on the MCU) and the single classic-CAN bus (`--leg-rate`; GIM drivers are classic CAN, 1 Mbps max). Bus load: wheels 500 Hz + legs 100 Hz = 50% (legs 200 Hz = 72%, all at 500 Hz = 136%). Results (gim6010, 12 randomized robots): MCU vs Pi — drive/turn/brake 10/12 vs 2/12, brake settle 7/12 vs 0/12; fast IMU on the MCU — drive 12/12, brake 9/12, ±30 N 12/12; legs at 200 Hz gave no gain over 100 Hz. Stock gim4305 with the 100 Hz BNO055 gyro: jump while driving drops to 8/12.
   * **Pre-order checks (2026-10-14)**:
     * *Motor drivers*: SteadyWin ships two driver families — ODrive-based (GIM6010-8 manual: `odrivetool`, CAN ID = node_id×32 + cmd) and SteadyWin's own (Motor Wizard: CAN ID + master ID, SteadyWin or MIT protocol). Order all 10 GIM motors with the same family; mixing works on one bus only with non-overlapping IDs.
     * *Heat (`thermal`, all GIM motors, sustained windows)*: hip roll (GIM4305) is the problem — 68% of rated just standing, 72–83% while weaving, because the wheel contact sits 60 mm outboard of the roll axis. Fix in CAD (roll axis above the contact patch) or upgrade hip roll to GIM6010-8 (+476 g). Wheels 40–49%, knees 29%, hip yaw 14%, hip pitch 4%.
     * *Power (`tools/power_budget.py`)*: standing ~35 W, cruising ~52 W, mixed use ~43 W → a 90 Wh 6S pack gives ~100 min. Jump thrust pulls ~80 A for ~50 ms (4 knees/hips near stall): use high-drain cells / 6S2P, bus capacitance, or cap the jump thrust current. 5 V rail peak ~3.8 A (Pi 5 + Hailo-8 at max) → 5.1 V/5 A buck is OK.
     * *IMU*: fast raw IMU (ICM-42688-P: 2.8 mdps/√Hz, up to 32 kHz ODR, SPI 24 MHz; or BMI088) on SPI to the Feather, filtered there; the sim's fast-IMU noise (0.3 °/s RMS) is conservative.
     * *Tires*: grip is the push-recovery limit. Soft cast urethane (≈Shore 45A) treads on printed 150 mm hubs; vendor μ on MDF ≈1.75 urethane vs 1.30 silicone vs 1.05 rubber (unverified). Measure on your floors (incline test, μ = tan θ) and set `RealismConfig.friction`.
   * **Build configuration (2026-10-14)**: hip roll also moved to GIM6010-8 (fixes its 72–83% heat: now 21%) and the battery to 6S2P (+0.42 kg vs the assumed 6S1P baseline). 5.79 kg total. Ideal sensors: every scenario passes, incl. ±40 N pushes (22° / 15° peak) and a 30–32 mm jump. 12 randomized robots: stand, drive, ±20–30 N pushes, jumps, thermal 12/12; ±40 N 9/12; brake settle 9/12; crouch 3/12. Heat: knees 37%, wheels 44%, hip roll 21%, hip yaw 16%. Power: ~40 W mixed use → ~214 min on a 180 Wh pack; jump thrust still ~80 A for ~50 ms. Note: at full crouch the heavier robot's knees sag to ~0.04 rad from their joint stop (was ~0.09).
   * **Open issues**: (a) on robots with a ±6–8 mm CoM offset the trim starts wrong and the learner (τ ≈ 7 s; faster gains oscillate) leaves 7–22 cm offsets after braking/crouching — on hardware, persist the learned trim between runs; (b) jump while driving still falls on 4/12 low-grip/latency robots (lands with ~60° lean).

3. Fork the Open Duck Mini v2 Onshape CAD, scale shells by `1.35x`, and adapt leg servo pockets to `Ø53 x 33 mm` GIM4305-10 bodies (`6x M2.5` on `Ø47.5` rear, `3x M3` on `Ø27` output; see `cad/purchased_parts.md`).
