mosschief/super_duck/(commit log)

2026-10-15 Wheeled Open Duck Mini v2 sim: balance controller, sim-to-real tests, GIM6010-8 upgrade
    MuJoCo model and LQR balance/drive controller for the 1.35x scaled wheeled
    Open Duck Mini v2, plus the tooling used to evaluate the hardware design.
    - Robot profiles: gim6010 (default; SteadyWin GIM6010-8 on hip-pitch and
    knees) and gim4305 (original all-GIM4305-10 design), each with its own
    model file, LQR body model, balance-lean fit and jump tuning.
    - Controller fixes: leg-fold-aware wheel odometry, adaptive pitch trim with
    posture feedforward fitted against measured leg fold, S-curve braking,
    post-push re-anchoring, crouch capped clear of the knee joint limit,
    MIT-mode leg damping schedulin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
2026-10-15 Build configuration: GIM6010-8 on hip roll, 6S2P battery; model-editing tools
    The hip-roll motors (GIM4305-10) ran at 72-83% of their continuous rating
    because the wheel contact sits 60 mm outboard of the roll axis. Moving hip
    roll to the GIM6010-8 brings it to 21%. The battery moves to a 6S2P 21700
    pack (+0.42 kg vs the assumed 6S1P baseline), for ~214 min of mixed use.
    The default robot is now 5.79 kg.
    - RobotProfile gains curve_actuators so the GIM6010-8 torque-speed limit
    covers hip roll as well; profile body params and balance-lean fit
    re-derived for the new mass distribution.
    - New tools to repeat this after CAD changes: upgrade_motor.py,
    battery_pack.py, derive_lqr_params.py, f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
2026-10-15 Add teensy dualcan and BOM
2026-10-15 Re-fit gim6010 balance trim; fix stale Feather/BNO055 docs
    The hip-roll GIM4305 swap, leg re-routing and battery move in d17a425 shifted
    the CoM, but initial_pitch_trim was left at -0.0118 rad. fit_balance_trim.py
    measures -0.0639 (posture coeffs -0.1303, -0.0323); with the stale trim 6/12
    scenarios failed (351 mm stand-still drift). All 12 pass again.
    - Teensy latency is now RealismConfig.mcu_latency_ms; the Feather gets
    feather_latency_ms instead of a hard-coded range
    - --arch help, IMU comment, XML trunk comment: Teensy / ICM-42688-P
    - GEMINI.md / README: hip-roll is GIM4305-10, build mass 5.32 kg
    - Restore 644 file modes changed to 755 in d17a425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
2026-10-15 Add Open Duck Mini expression package and battery protection
    Brings the build to parity with Open Duck Mini's expression features
    (eyes, projector, antennas, speaker, microphone, camera) and adds the
    protection a 6S2P pack needs. tools/add_expression_hardware.py applies it
    to both MJCFs (+37 g head, +130 g trunk; build now 5.48 kg):
    - Antennas hinged on 9 g micro servos (left/right_antenna, ctrl[14:16],
    +/-45 deg like antennas.py); Q/E in the sim
    - WS2812B eye rings, projector LED + toggleable spot light (P in the sim),
    INMP441 mic, MAX98357A amp + 40 mm speaker
    - 6S BMS, 40 A fuse, anti-spark switch with e-stop in its control loop,
    separate 5 V peripheral buck
    - Wheel touch sensors (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
2026-10-15 Lock down CAD dimensions: hardpoints, real part sizes, clearances, loads
    New cad/ folder, generated from the model so CAD has one source of truth:
    - hardpoints.md/.json (tools/export_cad_spec.py): every joint anchor,
    axis and range, body frame, part placement, camera/site/light in mm,
    key dimensions and the leg poses the structure must clear
    - purchased_parts.json/.md: real envelopes, hole patterns, masses and
    load limits with sources and confidence (SteadyWin drawings + STEP
    measured in FreeCAD, Raspberry Pi drawings, Molicel datasheet)
    - clearance_report.md (tools/check_cad_clearances.py): operating-pose
    and full-range sweeps, real-part layout errors vs. CAD constraints,
    trunk/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
2026-10-17 Remove hip yaw (fixed hip mounts); spec cast urethane tires
    Hip yaw: the controller always commanded 0 and steering is by wheel
    torque, so the two GIM4305s did nothing but carry 117 N axial on
    landings (93% of their bearing limit) and need swept clearance under
    the trunk. Replaced with fixed ~60 g mounts in both models (build now
    5.24 kg, -240 g). ctrl shrinks 16 -> 14; controller, realism, thermal
    test, power budget and CAD tools updated; LQR params re-derived and
    trims re-fit. gim6010: all 12 ideal scenarios pass; runtime 236 ->
    251 min; CAN load 25% -> 22% (Teensy, 100 Hz legs). Realism, 12
    robots: +40 N push 9/12 -> 5/12 (same 3 falls; the others roll out
    1.52-1.94 m vs the 1.5 m limit,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
2026-10-17 Add FreeCAD assembly with ODM 1:1 neck and head
    cad/freecad/ builds the full robot in FreeCAD (GUI via the MCP or headless
    freecadcmd): printed structure, every purchased electronic part as a model,
    the charge port and e-stop, and the Open Duck Mini v2 neck/head placed from
    its own robot.xml and STLs (fetched by tools/fetch_vendor_cad.sh). It writes
    fit_report.md (0 interferences at home) and printed/*.step (git-ignored).
    sweep_neck.py and neck_envelope.py check neck range of motion. The neck
    mechanism is clear everywhere; the head hits the trunk at same-direction pitch
    extremes. The controller now carries a TODO to clip head commands to the
    coupled envelope.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
    [build_super_duck.py, neck_envelope.py, sweep_neck.py]
2026-10-23 Restyle legs and body after the Open Duck Mini; vents, fan, nav cam
    - Knees bend backward; sim joint ranges, keyframe and balance trim refit
    - Legs: Impulse-style slotted motor cans, twin-sheet thigh and shin like
    the ODM's leg links, hip mount hung under the body (rounded corners)
    - Body: the ODM v2 shell scaled x1.15, split into tub and top cover,
    sides closed (hip motors stay outside), old walls kept as bulkheads
    - Ventilation: floor inlet slots, high side slots beside the Pi, 40 mm
    exhaust fan on the rear bulkhead out through the tail sides
    - Nav camera behind the front cap, 20 deg down like the sim's
    - Charging: GX16 socket, 6S charger, charge-lead fuse in the BOM
    - New sweep_legs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
2026-10-25 Strengthen legs, source real parts, update sim masses from CAD
    CAD (cad/freecad):
    - Thigh and shin closed into boxes (thigh printed as outer sheet + inner
    tray, aluminium clamp ring at the hip), hip-mount block, yoke gussets;
    FEM landing peaks roughly halved, standing wheel tilt ~1.2 -> 0.3 deg.
    - Leg harness: the shin's cantilevered cable bar is gone; the harness spans
    free round the thigh's knee end to one clip on the shin.
    - Real parts modelled: Heltec 6S 80 A split-port BMS (moved ahead of the
    pack), Flipsky Antispark Pro V3.0, Pololu D36V50F5/F7 bucks, RAFI
    LUMOTAST 22 e-stop, Adafruit 3968 speaker, Arducam UB0234 nav cam.
    - Teardrop wall holes, tail-shelf ribs, P1S printing n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
    [build_super_duck.py]
2026-10-26 Export the sim from the CAD: meshes, hulls, inertials, neck, cameras
    cad/freecad/export_sim.py (replaces mass_properties.py) writes every body's parts as
    meshes (assets/cad/), convex collision hulls, each body's mass / CoM / inertia, the ODM
    neck body positions and tilted antenna axes, the eye / nav cameras, projector light and
    IMU site into the gim6010 MJCF. The build writes parts_manifest.json (tag, colour).
    Tires stay MuJoCo cylinders; vendor STEP parts are exported as envelope models.
    check_cad_clearances.py now sweeps the hulls for self-contact; export_cad_spec.py handles
    mesh geoms. Robot 6.88 kg; LQR params and trim refit; 12/12 scenarios, realism unchanged.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
    [L_antenna_hull.stl, L_hip_mount_hull.stl, L_hip_pitch_gim6010_hull.stl, L_hip_roll_gim4305_hull.stl, L_hip_roll_yoke_hull.stl, L_knee_gim6010_hull.stl, L_shin_hull.stl, L_thigh_inner_hull.stl]
2026-10-27 Add robustness suite, sensitivity sweep, FEA of printed legs, sysid
    test_robustness.py: slopes, ramps, thresholds / curbs, uneven floor, low grip, turns at
    speed, battery sag, e-stop, CAN / driver / sensor faults, IMU errors, falls, a wall,
    drops, bad landings, a head-range sweep and a 20 min duty cycle (thermal + rainflow
    load cycles -> cad/fatigue_cycles.md); --report writes reports/robustness.md.
    test_scenarios.run gained terrain / init / fault / hook arguments.
    Controller: every head command is clipped to the CAD neck envelope (clip_neck_envelope),
    plus a head_pose command input. Core suite unchanged (12/12, realism as before).
    tools/sensitivity_sweep.py (crouch / brake weak spots: CoM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
2026-10-31 Stiffen the hip mount, yoke and shin; fix the hub mesh; guard the e-stop
    From the robustness FEA (10 cm drop, safety factor on p99 stress):
    - Hip mount 1.0 -> 1.5: the rib and plate are one block from the body out past
    the roll axis (bored Ø56 for the end cap and screws, clear of both cable
    runs). The front shelf bolt moves from x 58 to 55: its counterbore broke
    through the shelf's end.
    - Yoke 1.5 -> 2.3: 9 mm GIM4305 output plate, 6 mm walls run out flush with
    the hip-pitch plate, 5 mm gussets.
    - Shin 1.5 -> 1.7: outer sheet R40 at the knee, so its 14 mm edges run on
    down outside the tyre circle.
    - Wheel hub: the tread key grooves only touched the key holes, an edge gmsh
    couldn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
    [L_hip_mount_hull.stl, L_hip_roll_yoke_hull.stl, L_shin_hull.stl, R_hip_mount_hull.stl, R_hip_roll_yoke_hull.stl, R_shin_hull.stl, foot_assembly_2__cad_print.stl, foot_assembly__cad_print.stl]
2026-11-06 Controller: slope and IMU trim learning, turn limit, 1.8 m/s, low battery, drops
    The sim now applies the GIM4305-10 wheel speed-torque curve (it only had the
    legs'), scaled with the pack voltage the controller reads. With it the robot
    holds 1.8 m/s down to 21 V; 1.95 m/s is marginal and 2.2 m/s falls over even
    on a full pack, so top speed goes from 1.5 to 1.8 m/s with a voltage-based cap.
    - Trim learner: gain grows with the position error, also learns while
    cruising, held off at start-up and for 1 s after a leg move. Slopes up to
    15 deg now hold within 4 cm (were up to 73 cm), IMU mounted +/-3 deg off
    drifts 1.5 cm (was 9).
    - Gyro bias: running average while parked and still, then a s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
2026-11-06 Top speed 1.8 -> 2.5 m/s: fix wheel loss and braking models, virtual wheel damper
    The wheel joint's damping="0.05" counted the GIM4305-10's losses twice: the
    speed-torque curve the sim applies already reaches zero torque at the listed
    366 rpm no-load speed, and the damper took another 1.2 N*m per wheel at
    1.8 m/s, so an unloaded wheel couldn't reach even its 300 rpm rated speed.
    Damping is now 0.005 (bearing / seal drag only); frictionloss unchanged.
    - The balance tuning leaned on that passive damper (slope holds, low grip, a
    limp leg regressed without it, and LQR retuning didn't help), so the
    controller now supplies it about the reference speed (WHEEL_DAMPING 0.045).
    Same behaviour a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
2026-11-06 Detect driving into a wall: stop, back off 10 cm, stay upright
    The head sticks out ahead of the wheels, so on a wall it is always the first
    thing to touch. The wall was a worldbody geom, and the fall test counts any
    non-leg contact with the world as ground, so `wall @0.6/1.2 m/s` recorded a
    fall on the first touch, before any controller could react. Physically the
    robot did not fall: the speed reference kept running, the LQR drove it back
    into the wall, and the cruise trim learner read the stall as "lean further".
    It ended up pinned to the wall at 14 deg (0.6 m/s) / 23 deg (1.2 m/s) and
    still climbing.
    Controller (`_detect_bump`, IMU and wheel encoders only): an IMU acceleration
    spike over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
2026-11-06 Fall cutoff: wheels off past 40 deg of lean, re-armed once stood up
    Forward shoves while cruising fast (push +30 N @1.5, +20/+30 N @1.8 and
    @2.5 m/s) fail because the wheels run out of speed, not because of the
    controller: the wheel command sits at the GIM4305-10 speed-torque limit
    from the shove until the fall, other LQR weights fail the same way, and a
    15% faster motor recovers +30 N @1.5. At 2.5 m/s both wheels' torque only
    covers drag at 2.77 m/s, and a 20 N / 0.1 s shove alone takes the 7.03 kg
    robot to 2.78 m/s, so no wheel controller can catch it.
    What the controller can do there is fall safely. Before this change the
    balance loop kept driving the fallen robot along the floor on its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
2026-11-06 Slope observer: feed forward a slope's wheel torque and lean (ramps pass)
    The LQR has no integral term, so on a fresh incline it only produced the
    holding torque M*g*R*sin(slope) through standing errors, and the slope was
    left to the trim learner. On a 15 deg ramp it crawled up at 0.16 of 0.45 m/s,
    a brake there rolled it back 33 cm (re-anchored) while the parked learner
    caught up, and it ran out of time before the platform. Down the ramp the
    slope got stored as "trim" and was wrong on the flat at the bottom.
    Add a momentum observer (`_update_slope`): p = (M + 2 I_w/R^2) v +
    m_b l cos(pitch) pitch_rate, dp/dt = tau/R - M g sin(slope). It needs no
    differentiation and does not depend on the I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
2026-11-06 Crouch drift: posture lean-rate feedforward, fast lean learner after leg moves
    crouch_stand failed on 7/10 randomized robots (8.4-12 cm wander vs 8 cm), and
    the ideal robot passed with 7.4 cm.
    - Lean-rate feedforward: the posture feedforward moved the balance lean with
    the leg fold, but the LQR pitch-rate reference stayed at zero. While the legs
    moved, the LQR fought the trunk's rotation to its new lean and paid for it
    with a velocity error (K_pitch_rate / K_vel ~ 0.9 m per rad), about 7 cm on
    the ideal robot. The reference is now d(posture_trim)/d(fold) x the measured
    fold rate. Ideal crouch_stand: 7.4 -> 3.4 cm.
    - Fast lean learner: a trunk CoM offset of 4-8 mm leaves the fitted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
2026-11-06 Thresholds and curbs: fix the step-edge collision artifact, end soft-landed drops
    The 20-25 mm thresholds and 20-30 mm curbs fell at t=3.8 s for a reason in the
    sim, not the robot. Against the cylinder tire, MuJoCo 3.17's convex collider
    (native EPA, and libccd's MPR on long boxes) reports a box/mesh face normal at a
    box edge instead of the radial one. On a 20 mm edge it gave (1, 0) at 2.4 mm
    depth where the geometry gives (0.64, -0.76) at 3.7 mm. That turned the edge
    into a vertical wall the tire could only climb by friction: the wheel stopped
    dead, spun at the 3.47 N*m stall (slip at mu 1.25), and the trunk pitched over.
    test_robustness.add_step builds a step whose tire-reachable surfaces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
2026-11-06 Make the merged sim fixes work together: slope observer vs bumps, falls, Kt error
    The five branches each passed on their own; merged, the slope observer
    (ramps) broke two of the others and still cost randomized slope holds:
    - Wall: the observer read the wall's push as a 3 deg upslope, fed it forward
    (leaning back into the wall) and, once settled, re-anchored the hold point
    on the wall, undoing the bump back-off. A bump now restores the estimate
    from before the impact and freezes the observer for BUMP_SLOPE_HOLD (1.5 s).
    - Fall cutoff: a shove at 1.8 m/s read as a 7 deg slope, partly because the
    observer used the commanded wheel torque, which the speed-torque curve
    doesn't deliver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
2026-11-06 Apply test shoves to the back of the trunk, not 0.71 m up on the base
    Every shove went to the massless `base` body, which MuJoCo applies at that
    body's inertial frame 0.71 m above the floor: above the 0.57 m robot and
    0.43 m above its CoM (vs 0.15 m for the trunk's back), so each push tipped
    it far harder than a real one. test_scenarios.Pusher now applies it at
    PUSH_HEIGHT 0.43 m on the trunk's centreline (top of its back), at a point
    fixed in the trunk, as force + moment about the trunk CoM. Used by the
    scenario suites and tools/export_design_loads.py.
    Measured margins (ideal sensors, 0.1 s forward shove): 100 N standing,
    80 N at 0.6 m/s, 60 N at 1.1, 40 N at 1.5, 30 N at 1.8, under 20 N a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
2026-11-10 Split simulate_wheeled_duck.py into the duck/ package
    duck/robot.py (params, profiles, LQR), duck/controller.py (the controller,
    no MuJoCo: the part to port to the Teensy) and duck/plant.py (realism layer,
    sensors, torque curves, step_robot). Code moved unchanged; the script keeps
    the viewer/CLI and re-exports everything for the tests and tools.
    test_robustness now patches apply_leg_servo_kd in duck.plant, where
    step_robot looks it up. test_scenarios, --realism 4 and test_robustness
    output is identical before and after.
2026-11-10 Port the controller to C++ for the Teensy; check it against Python in the sim
    firmware/controller/duck_controller.{hpp,cpp} is a line-for-line port of
    duck/controller.py (no heap, exceptions or Arduino code). Every constant,
    robot parameter and LQR gain comes in through Config, filled from the Python
    controller: at runtime in the sim (duck/cpp_controller.py, via a C API and
    ctypes) and from config_gim6010.hpp on the Teensy, generated by
    tools/export_firmware_config.py.
    --controller py|cpp|compare on the sim and both test suites (or
    $DUCK_CONTROLLER). compare runs both controllers on the same sensor readings
    and fails on the first command or state field that differs by more than 1e-9.
    test_s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
